mengwei666/my_microduck/readme.md

20261021
添加工控机模型

20261021
添加其他项目文件2

20261021
添加其他项目文件

20261021
上传文件测试
