mengwei666/my_microduck/microduck_scs225/scs225_left_knee/README_CN.md

# 左膝 SCS225 适配（第一关节验证件）

## 1. 这次改了什么

目标：保持 Microduck 左腿的运动学轴线不变，只把 **左膝** 的舵机安装接口从
飞特 HD-1910（`-FT` 版原设计）改成 **SCS225**，先做一个可以在 FreeCAD 里量尺寸、
可以打印试装的验证件。

没有改髋 pitch、髋 roll、踝、脚；右腿也没有改。

关键结论：

- `microduck-replica-cad-master/SolidWorks-FT2026-09-25/` 是 **HD-1910 飞特版**，
  不是 SCS225 版；`microduck_scs225/ascll/` 是从这个版本导出的左腿 STEP。
- 上腿外壳的外形包络是按 XL330 级别（45×24.7×35）留的，但 `-FT` 版的
  膝部舵机腔/加固板已经按更小的 HD-1910 缩过；SCS225 需要把舵机腔清大，
  并且 `rigidity_plate`（上腿加固板）的舵机孔位/轴承座必须改。
- 原 16×22×4 轴承的内孔是 16 mm，SCS225 的输出凸台是 Ø19.2，**不能直接套**；
  本包把轴承上移 2 mm，并给了一个 16 mm 轮毂的占位模型，轮毂和 SCS225 原装
  舵盘的连接还需要按实物舵盘孔距最终确定。

## 2. 文件

| 文件 | 用途 |
|---|---|
| `left_knee_SCS225_check.step` | **总检查装配**：改后上腿 + 改后加固板 + SCS225 + 轴承 + 小腿 + 16 mm 轮毂占位 + 原 HD-1910 髋舵机参考 |
| `left_upper_leg_knee_SCS225.step` | 改后左上腿（膝部按 SCS225 清空） |
| `left_upper_leg_rigidity_plate_knee_SCS225.step` | 改后上腿加固板（SCS225 四孔 + Ø20.2 让位 + 轴承座环） |
| `reference_raw_clearance_cut.step` | 原始切割结果（含被切下的小碎块），仅用于对照，不要打印 |
| `01_mount_holes_top_view.png` | 安装孔俯视图（20.7 × 20.5） |
| `02_knee_stack_section.png` | 膝部轴向剖面（板/轴承/小腿/轮毂的 Z 向堆叠） |
| `03_check_assembly_iso.png` | 总装等轴测预览 |
| `04_check_assembly_knee.png` | 膝部近景 |

所有 STEP 都在 **04_左大腿 装配坐标系** 里：膝轴 `(X,Y) = (10.13, -4.51)`，
轴线沿 `+Z`；原加固板底面 `Z=43.95`，顶面 `Z=45.95`。

## 3. 关键尺寸（可以直接在 FreeCAD 里量）

### SCS225（以输出轴中心、安装面为原点）

- 机体：45.25 × 24.78 mm，深 35 mm（输出面到后盖），输出凸台顶面在 `+3.2 mm`
- 安装面四孔：**20.7 × 20.5 mm**
  - 近排：距轴 **8.3 mm**
  - 远排：距轴 **29.0 mm**
  - 两排都在输出轴同一侧；横向 ±10.25 mm
- 本装配坐标里的四孔中心：
  - `(18.43, -14.76)`
  - `(18.43, +5.74)`
  - `(39.13, -14.76)`
  - `(39.13, +5.74)`

### 改后加固板

- 板底 `Z=43.95`（和 SCS225 安装面共面），板顶 `Z=45.95`
- 四孔：Ø3.2 通孔（M3  clearance，r=1.6）
- 中心让位：Ø20.2（SCS225 输出凸台 Ø19.2，单边 0.5 mm）
- 轴承座环：内 Ø20.2，外 Ø24.0，顶面 `Z=47.95`
- 原 16×22×4 轴承：从 `Z=45.95~49.95` 上移到 **`Z=47.95~51.95`**
  - 与 SCS225 凸台顶面 `Z=47.15` 留 **0.8 mm** 轴向间隙

### 小腿

- 小腿来自 `05_左小腿`，按膝轴对齐后：`Z=51.95~59.9`
- 膝部是 Ø16 内孔（外径约 Ø20 的凸台），和 16 mm 轮毂配合
- 检查装配里小腿底面与轴承顶面有 **0.7 mm** 间隙，试装时用 0.7 mm 垫片或
  调整轮毂法兰补掉

## 4. 在 FreeCAD 里怎么核对

1. 打开 `left_knee_SCS225_check.step`。
2. 用 **Part → Measure**（或 Draft 尺寸）量加固板四个孔：
   - X 向孔距 **20.7**
   - Y 向孔距 **20.5**
   - 对角 **29.14**
   - 孔径 **3.2**（M3 通孔）
3. 量轴线：SCS225 输出凸台、轴承内孔、小腿膝孔的圆心都应在
   `(10.13, -4.51)`，轴线沿 Z；不同心度建议 <0.1 mm。
4. 量安装面：加固板底面与 SCS225 前端面都应是 `Z=43.95`。
5. 量间隙：
   - SCS225 凸台顶 `47.15` ↔ 轴承底 `47.95`：**0.8 mm**
   - 小腿 ↔ 上腿：约 **11.5 mm**
   - 小腿 ↔ 加固板：约 **4.7 mm**
6. 单独打开两个改后零件，运行 **Part → Check geometry**；两个都是单一有效实体。
7. 检查髋舵机冲突：原 HD-1910 髋舵机的近端在 `Y=-15.66`，SCS225 远排
   内侧孔 `(39.13,-14.76)` 距它只有约 **0.9 mm**。**第一次膝部试装不要把
   HD-1910 髋舵机装上去**；以后把髋也换成 SCS225 时，让它的长边朝 `-X`，
   机体会退到 `Y≈-52.5~-27.8`，这个冲突就消失。

## 5. 打印与试装步骤

1. 打印：
   - 上腿：PLA/PETG，0.2 mm 层高，3 墙，20% 填充
   - 加固板：**4 墙，40% 以上填充**（它是承力件）
2. 先不装舵机，把 SCS225 放进上腿膝部，确认机体不顶住上腿，安装面与
   加固板底面贴合。
3. 用原螺丝把加固板固定到上腿（髋侧仍是 HD-1910 孔位，膝侧是新孔位）。
4. 用 **4× M3×8 沉头/低扁头** 把 SCS225 锁到加固板上，对角预紧。
   - 远排内侧那颗离髋舵机很近；若暂时不装髋舵机，可以先装它。
5. 把 16×22×4 轴承放进加固板轴承环（`Z=47.95`）。太松就加轴承胶，
   太紧就把环孔修 0.1 mm。
6. 给 SCS225 装 16 mm 轮毂（`16mm_hub_proposal_not_final` 只是占位）：
   - 轮毂法兰要固定在 SCS225 原装 25T 舵盘上（按实物舵盘孔距打 4×M2，
     或压装/胶接）
   - 轮毂 16 mm 外圆与轴承内孔、小腿 Ø16 孔配合；建议 16.0 -0.02/-0.05
7. 舵机先回中位（raw 511）再装舵盘/轮毂/小腿；手动转 ±30°，确认无卡滞。
8. 用 7.4 V、≥5 A 电源给舵机上电，先小角度（±10°）来回，再逐步加大。
9. 记录实测孔距、轴心偏差、轴承间隙；如果都正常，再按同样方法改髋 pitch
   和右腿。

## 6. 已知问题 / 下一步

- **上腿结构**：SCS225 比 HD-1910 大，切割后上腿膝部是开口的；加固板
  （2 mm + 轴承环）目前充当外侧盖板。验证尺寸没问题，但长期使用建议加一块
  **内侧背板/抱箍**，把 SCS225 背面四个孔和上腿连起来，形成“三明治”结构。
  这也是下一步最值得做的零件。
- **16 mm 轮毂**：STEP 里的轮毂是占位件，25T 舵盘接口必须按你手上的 SCS225
  实物舵盘测孔距后才能定稿。
- **髋 pitch**：本次未改。第一次膝部测试不要装原 HD-1910 髋舵机；后续改髋时
  让 SCS225 长边朝 `-X`。
- **运动学**：膝轴 `(10.13,-4.51)` 没变；轴承/小腿整体外移 2 mm，属于横向
  偏移，矢状面连杆长度不变。RL 模型暂时不用改连杆，但碰撞体要按新外形更新。
- **SCS225 参考 STEP**：原文件是 8 个重叠实体的 compound，FreeCAD 会报
  `valid=False`，这是参考模型本身的问题，不影响尺寸核对；我们改的
  上腿和加固板都是单一有效实体。
