mengwei666/my_microduck/docs/rk3588-scs225-13dof.md

# RK3588 + SCS225 十三自由度机器人 — 接口与训练安排

本文档记录这台自制机器人的硬件接口、关节分配、标定方法、IMU 约定，以及
`microduck_rl` 训练计划。运行时基于 `microduck` 的 `robotd`（新增 `--bus scs`），
训练基于 `microduck_rl`。

---

## 1. 硬件

| 部件 | 型号 / 接口 | 说明 |
|---|---|---|
| 主控 | 正点原子 ATK-DLRK3588（RK3588） | Buildroot，glibc 2.37，aarch64 |
| 舵机 | 飞特 Feetech **SCS225** ×13 | 串行总线，TTL 半双工，7.4V |
| 舵机转接板 | Waveshare Bus Servo Adapter (A) | 跳线 **B**（USB 模式），USB 接板子 → `/dev/ttyACM0` |
| IMU | **MPU6050** 模块 | I2C2：JP5 `P1_A0`=SCL、`P1_A1`=SDA，地址 **0x68**（AD0→GND） |
| 舵机供电 | 7.4V（2S）/ ≥5A | **不可用 12V**，会损坏 SCS225 |
| IMU 供电 | 3.3V（JP1） | JP5 是纯信号排针，无电源脚 |

调试串口：板载 CH343，`/dev/ttyACM0`（在 PC 上），**1500000 8N1**。

---

## 2. 关节分配（舵机 ID → 关节 → robotd 槽位）

舵机 ID 就是总线地址，出厂已按 1–13 设置。**本机没有摇头（head_yaw）和嘴巴（mouth）**
两个自由度，其余关节保持与量产 Microduck 相同的顺序和索引。

| 舵机 ID | 关节名 | robotd 槽位 | 中文 |
|---:|---|---:|---|
| 1 | `left_hip_yaw` | 0 | 左髋偏航 |
| 2 | `left_hip_roll` | 1 | 左髋横滚 |
| 3 | `left_hip_pitch` | 2 | 左髋俯仰 |
| 4 | `left_knee` | 3 | 左膝 |
| 5 | `left_ankle` | 4 | 左踝 |
| 6 | `neck_pitch` | 5 | 颈俯仰 |
| 7 | `head_pitch` | 6 | 头俯仰 |
| 8 | `head_roll` | 8 | 头横滚 |
| 9 | `right_hip_yaw` | 10 | 右髋偏航 |
| 10 | `right_hip_roll` | 11 | 右髋横滚 |
| 11 | `right_hip_pitch` | 12 | 右髋俯仰 |
| 12 | `right_knee` | 13 | 右膝 |
| 13 | `right_ankle` | 14 | 右踝 |

**缺失的两个槽位**：`head_yaw` = 槽位 7、`mouth` = 槽位 9。它们保持 0，永不被命令。
代码里的常量是 `robotd::SCS_JOINT_SLOTS = [0,1,2,3,4,5,6,8,10,11,12,13,14]`。

> ⚠️ 这是一条**约定**，不是测量结果。接线时若某个舵机装到了别的关节，必须改这张表。
> 验证方法见 §5。

### 2.1 训练用的紧凑顺序

训练（`microduck_rl`）用一套 13 元素的紧凑顺序，与上表**同序**，只是重新编号：

```
训练索引 i : 0  1  2  3  4   5          6          7         8   9  10 11 12
关节       : 左髋×5             颈俯仰    头俯仰     头横滚    右髋×5
运行时槽位 : 0  1  2  3  4   5          6          8         10 11 12 13 14
```

即 `训练索引 i ↔ 运行时槽位 SCS_JOINT_SLOTS[i]`，两边顺序一致。

---

## 3. SCS225 电气与协议参数（实测）

| 项目 | 值 |
|---|---|
| 总线 | 1 Mbps，8 数据位，无校验，1 停止位；TTL 半双工 |
| 位置分辨率 | 0–1023，中位 **511**，行程 300°（约 0.293°/count） |
| 字节序 | 16 位寄存器 **高字节在前（大端）**（SCS 系列与 SMS 系列相反） |
| 单次 READ 长度 | **≤3 字节可靠**；4 字节大量失败，≥5 字节完全无响应（实测） |
| 单次 WRITE | 任意长度均可 |
| 同步写 | 广播 ID `0xFE`，指令 `0x83` |
| 弧度换算 | `rad = (raw − 511) × (300° / 1024)`；`rad_to_raw` 为其逆 |
| 默认力矩 | 上电为**自由**，需显式使能 |

关键寄存器（大端）：

| 地址 | 名称 | 字节 | 说明 |
|---|---:|---|---|
| 0x05 | ID | 1 | 1–253 |
| 0x06 | 波特率 | 1 | 0 = 1 Mbps |
| 0x09 / 0x0B | 最小/最大角度限位 | 2 / 2 | 出厂 20 / 1003 |
| 0x12 | phase | 1 | Bit0：方向取反；Bit3：速度 0 = 最大 |
| 0x15 / 0x16 | 位置环 Kp / Kd | 1 / 1 | 0–254 |
| 0x28 | 力矩开关 | 1 | 0 自由 / 1 使能 / 2 阻尼 |
| 0x2A | 目标位置 | 2 | 0–1023 |
| 0x2E | 目标速度 | 2 | 步/秒，0 = 最快 |
| 0x38 | 当前位置 | 2 | |
| 0x3A | 当前速度 | 2 | 有符号，步/秒 |
| 0x3C | 当前负载 | 2 | 0.1% |
| 0x3E | 输入电压 | 1 | 0.1V |
| 0x3F | 温度 | 1 | °C |
| 0x41 | 状态 | 1 | Bit0 电压 / Bit2 温度 / Bit5 负载 |
| 0x42 | 移动标志 | 1 | 1 = 运动中 |

---

## 4. 关节标定（每台机器人必做）

驱动把 **raw 511 当作 0 rad**，正方向为 raw 增大。由于装配差异，每个关节需要：

1. **机械零位 raw**：手扶关节到设计零位，读当前位置，与 511 的差就是该关节的
   offset（当前代码未实现 per-joint offset，需要时再加）。
2. **方向**：给该关节一个小目标（如 +100 raw），确认实际转向与模型一致；不一致就写
   `phase`（0x12）Bit0 取反，或在标定表里记负号。
3. **限位**：写 `min/max angle limit`（0x09/0x0B），避免自碰撞或扯线。
4. **Kp/Kd**：默认 Kp=32、Kd=0 可先跑，整定阶段再调（运行时 `robotd` 会按策略的
   `gain` 统一写 Kp）。

标定时的读/写命令可用板子上的 `/root/scs225` 工具（scan/read/move），或笔记本上的
`microduck/scripts/scs225_debug.py`。

---

## 5. IMU 与机身坐标

- 当前**以模块现有安装方向作为机身坐标**：驱动里 mount = 单位四元数，不额外旋转。
- `gravity` 约定与 Microduck 一致：**竖直静止时为 `[0, 0, −1]`**（机身坐标）。
  MPU6050 的加速度计在静止时测到的是"向上"的比力，驱动取反并归一化。
- **没有磁力计 → 无法测偏航**。四元数只含倾斜（tilt-only），航向恒为 0；依赖偏航的
  功能（如精准转向）需要额外传感器或靠腿部里程计。
- 若以后改变模块安装方向，在 `duck-control/src/mpu6050.rs` 里加 mount 旋转（与
  `imu.rs` 的 `SflpDecoder::DEFAULT_MOUNT` 同一套约定），改完重新编译部署。

---

## 6. 运行与验证

板子上（`/root/robotd`、`/root/robotctl` 已部署）：

```sh
RUST_LOG=info /root/robotd --bus scs --port /dev/ttyACM0 --no-policy \
    --socket /run/robotd.sock > /tmp/robotd.log 2>&1 &
/root/robotctl --socket /run/robotd.sock health
```

期望输出：

```
robot     healthy
  loop      49.9 of 50.0 Hz · ...
  bus       ok
  imu       ready
  battery   7.x V (..%)
```

总线自检（不动舵机）：

```sh
/root/scs225 --port /dev/ttyACM0 --ids 1-13 scan
/root/scs225 --port /dev/ttyACM0 --ids 1-13 read
```

---

## 7. 训练计划（`microduck_rl`）

**目标**：13 自由度、先训**前进/后退**（机体 x 方向速度 `vx`，侧移/转向先不训）。

### 7.1 模型

当前 `microduck_rl` 的模型是 14 自由度（`0-4` 左腿、`5-8` 头颈
`neck_pitch/head_pitch/head_yaw/head_roll`、`9-13` 右腿），14 个执行器，观测 61D。
本机去掉 `head_yaw` → **13 自由度、13 个执行器**。

改动清单（按 mjlab 约定）：

1. MJCF：删除 `head_yaw` 关节与对应 actuator（或移到 `passive_` 前缀之外但禁用），
   保留质量/惯量/碰撞体不变。
2. `microduck_constants.py`：更新执行器/关节列表与 HOME 帧（去掉 head_yaw 一项）。
3. `microduck_*_env_cfg.py` / `mdp.py`：动作维度、观测项、奖励里引用 head_yaw 的
   一律删除或置零；`symmetry.py` 的镜像表同步删列。
4. 观测：保持"每槽非零采样"的约定，删掉的槽位不要留死权重。

### 7.2 任务

- 复用 `Mjlab-Velocity-Flat-MicroDuck`。
- 命令只采 `vx`（前进正、后退负），`vy=0`、`yaw_rate=0`；保留 `head_pose` 槽但采样
  小范围或零，维持输入神经元活性。
- 课程：先小速度、平地，稳定后再放宽 `vx` 范围。

### 7.3 流程

```bash
cd microduck_rl
uv run list-envs
uv run train Mjlab-Velocity-Flat-MicroDuck-13Dof \
    --env.scene.num-envs 64 --agent.max_iterations 5      # 冒烟
uv run train Mjlab-Velocity-Flat-MicroDuck-13Dof \
    --env.scene.num-envs 4096 --agent.max_iterations 4000 \
    --agent.logger tensorboard                            # 本机 RTX 2070
uv run play  <TASK_ID> --checkpoint-file logs/.../model_4000.pt
uv run scripts/export.py <TASK_ID> --wandb-run-path ...   # 或训练结束自动导出 ONNX
```

### 7.4 部署到板子

ONNX 经 `robotctl policy load` 或 `publish` 安装。**动作/观测维度与运行时天然兼容**：

- 训练时 BAM 执行器按关节名正则匹配，策略输出仍是 **14 个动作**（13 个真实关节
  + 一个被 equality 锁死的 `head_yaw`），观测仍是 **61D**，与 `robotd` 的策略契约一致。
- 被锁死的 `head_yaw` 动作在训练中没有梯度，在真机上又被 `SCS_JOINT_SLOTS` 跳过
  （槽位 7 不在列表里），所以不需要为了 13 自由度去改 `duck-ipc-proto`/`robotd`。
- 部署时只需保证策略的动作顺序与 §2.1 的训练顺序一致（由模型关节顺序决定）。

### 7.5 现实提醒

机器人目前还是散件，没有结构尺寸/质量。先用"删掉 head_yaw 的量产模型"训练，能得到
可用的前进/后退步态起点；等你有腿长、连杆质量、质心实测值后，把 MJCF 的惯性参数改
成实机值再微调，迁移会更稳。

---

## 8. 已知限制与坑

- **SCS225 单次读 ≤3 字节**：驱动已按位置/速度分开读并重试 3 次，别改回 6 字节合并读。
- **写入后立即读会偶发失败**：供电不足时尤其明显；7.4V/≥5A 后实测 0/50 失败。
- **12V 必坏**：SCS / SC 系列是 7.4V 舵机，Waveshare 板上标的 9–12.6V 是给 ST 系列的。
- **P1_A0/P1_A1 无内部上拉**：I2C 依赖 MPU6050 模块板载上拉，线要短、插要紧。
- 没有 `head_yaw`/`mouth`：量产策略不能直接跑，必须按 §7 重训或做动作维度适配。
