mengwei666/my_microduck/microduck-replica-cad-master/组件图/01-躯干主体-爆炸图.png

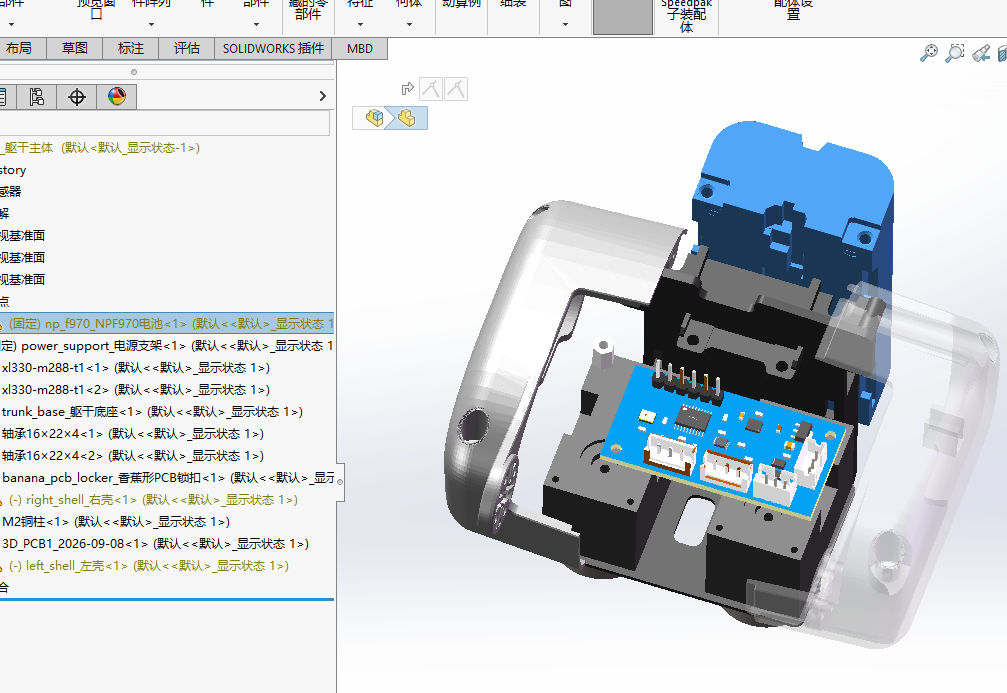
microduck-replica-cad-master/组件图/01-躯干主体-爆炸图.png
