mengwei666/my_microduck/microduck-replica-cad-master/组件图/10-头部总成爆炸1.png

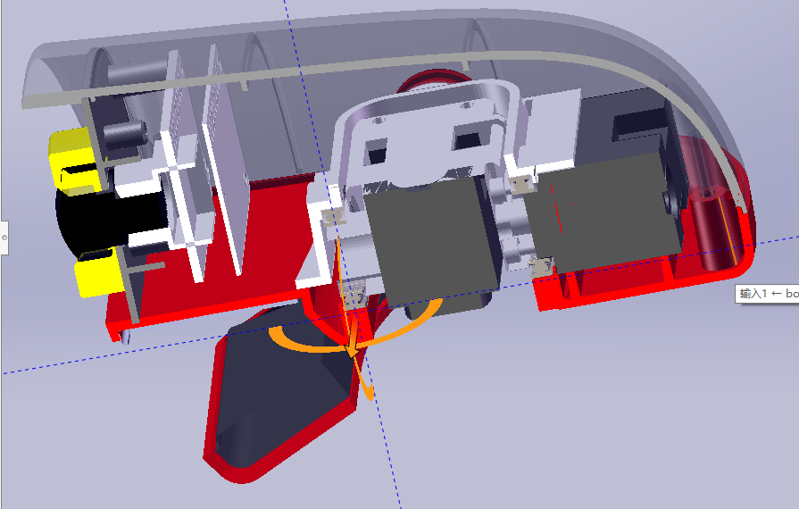
microduck-replica-cad-master/组件图/10-头部总成爆炸1.png
