mengwei666/my_microduck/microduck_scs225/scs225_cad/SCS215_ST3215_2D.png

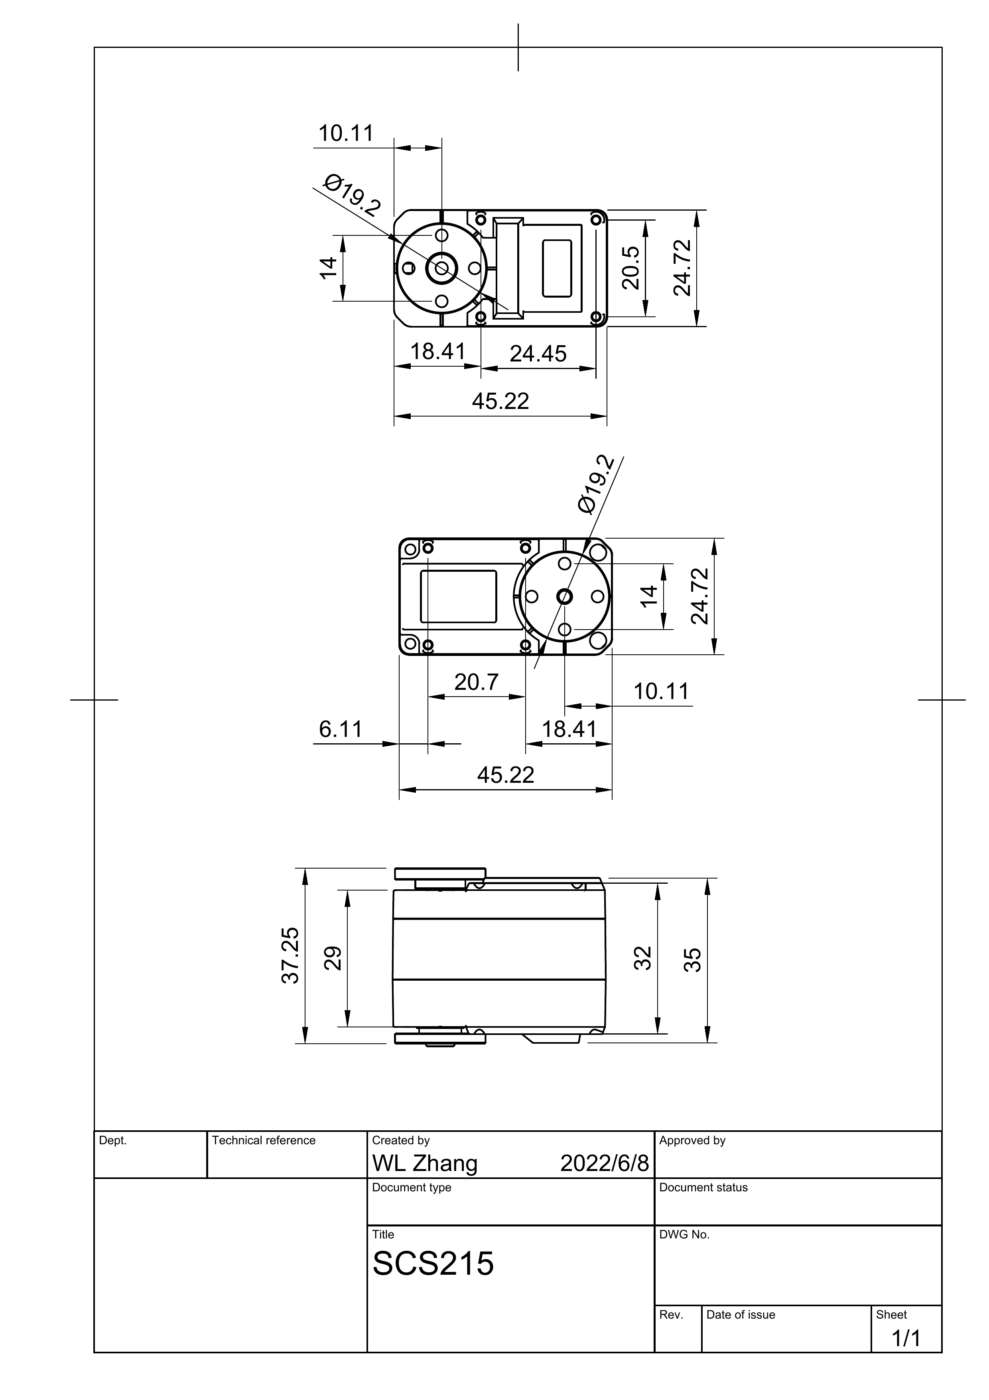
microduck_scs225/scs225_cad/SCS215_ST3215_2D.png
