mengwei666/my_microduck/microduck_scs225/scs225_cad/SCS225_spec_page6.png

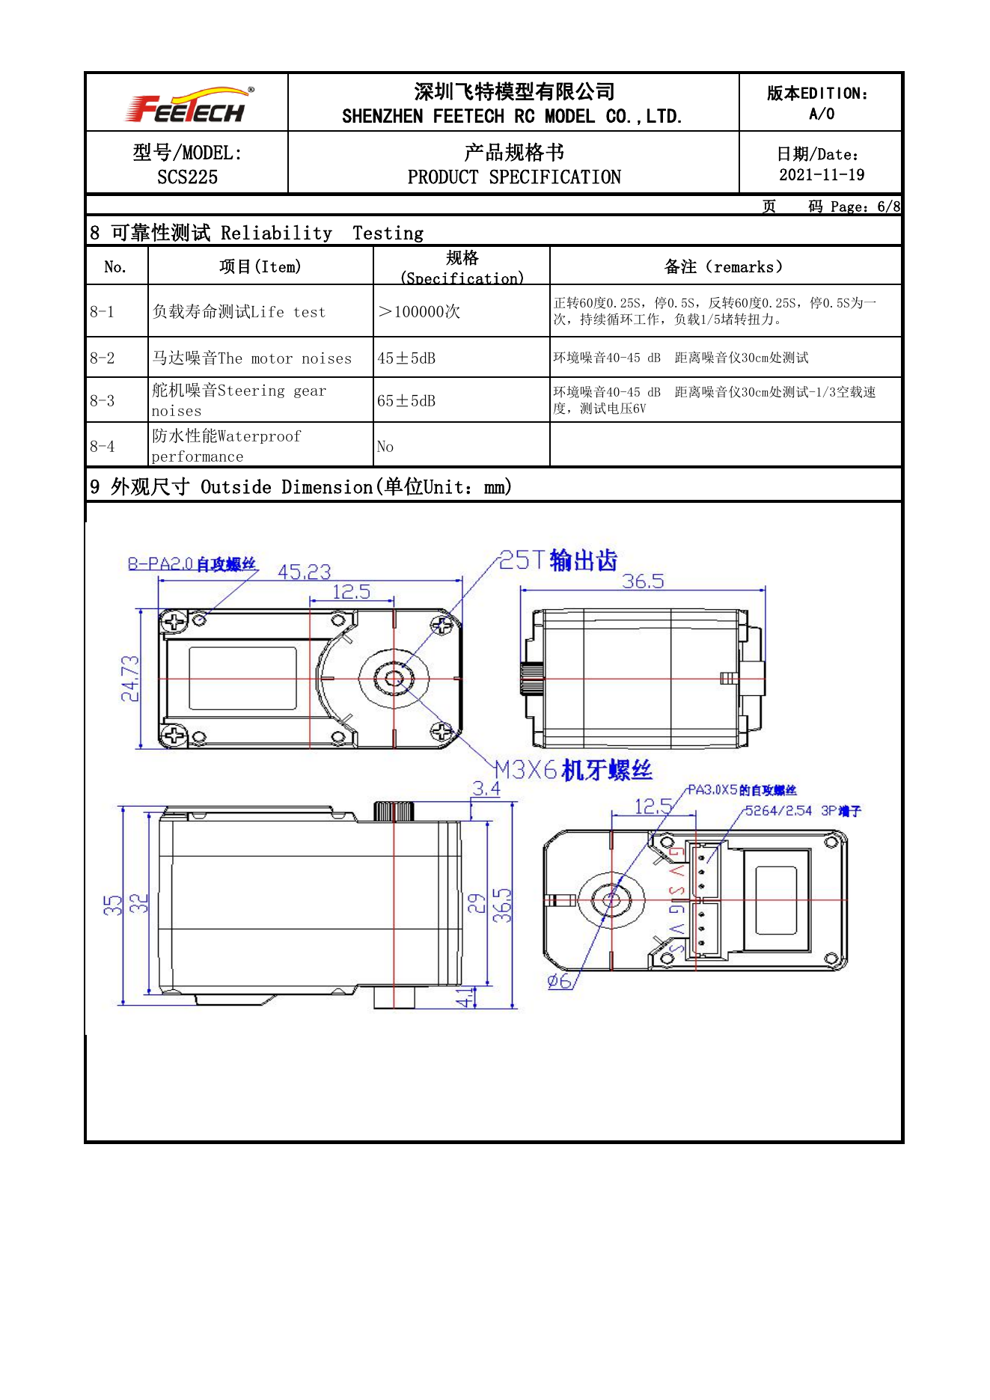
microduck_scs225/scs225_cad/SCS225_spec_page6.png
