mengwei666/my_microduck/microduck_scs225/scs225_left_ankle/01_full_iso.png

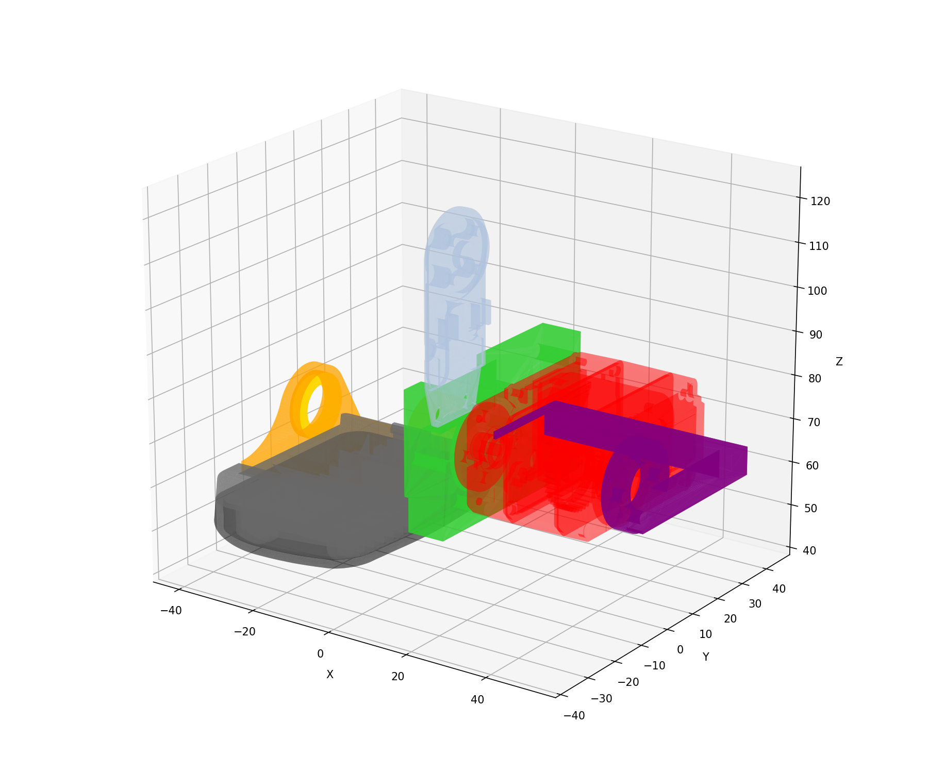
microduck_scs225/scs225_left_ankle/01_full_iso.png
