mengwei666/my_microduck/microduck_scs225/scs225_left_ankle/02_ankle_close.png

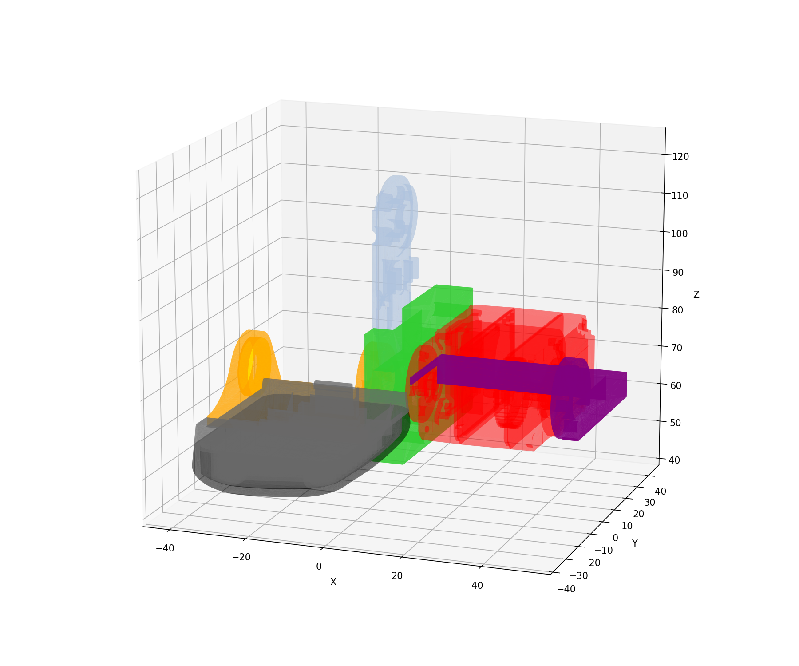
microduck_scs225/scs225_left_ankle/02_ankle_close.png
