mengwei666/my_microduck/microduck_scs225/scs225_left_ankle_v2/01_check_iso.png

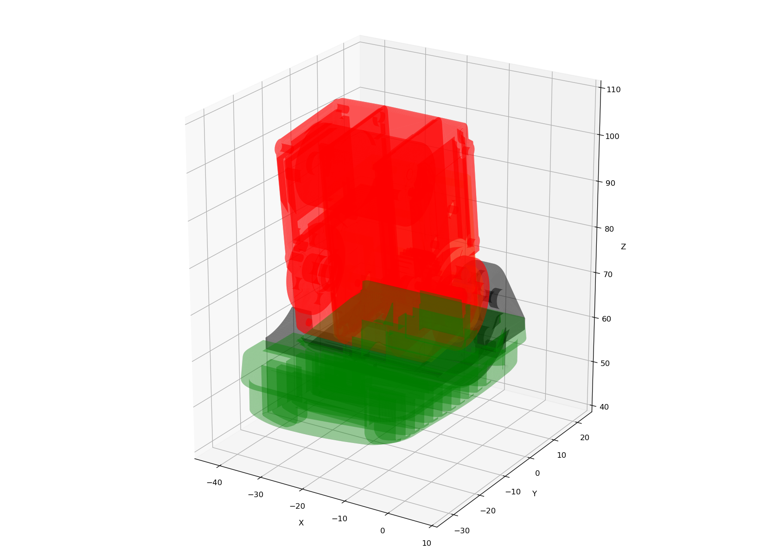
microduck_scs225/scs225_left_ankle_v2/01_check_iso.png
