mengwei666/my_microduck/microduck_scs225/scs225_left_ankle_v2/02_section_xz.png

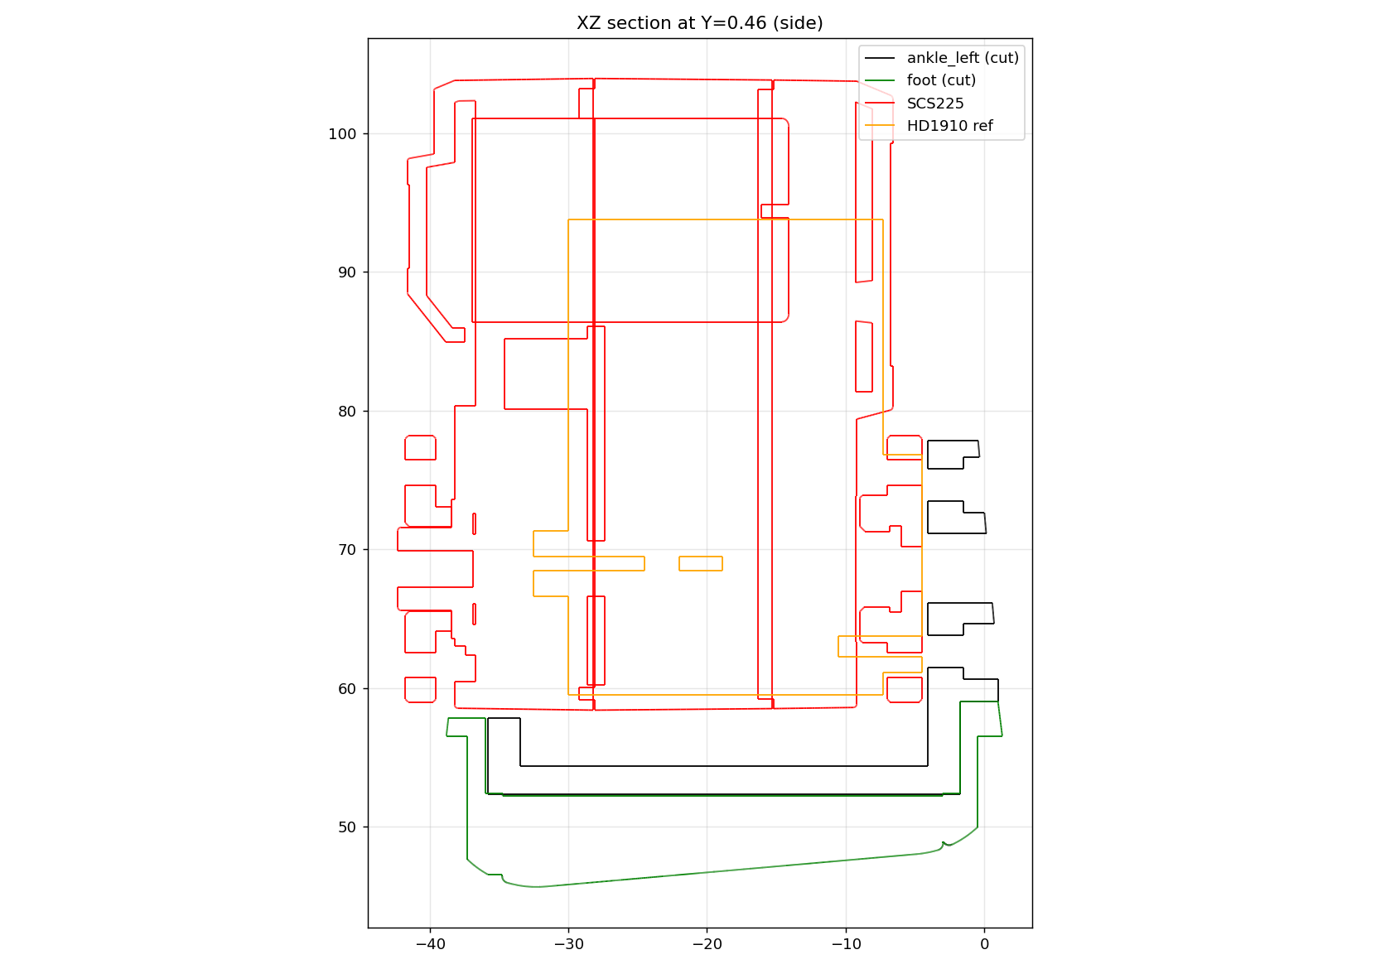
microduck_scs225/scs225_left_ankle_v2/02_section_xz.png
