mengwei666/my_microduck/microduck_scs225/scs225_left_ankle_v2/03_section_xy.png

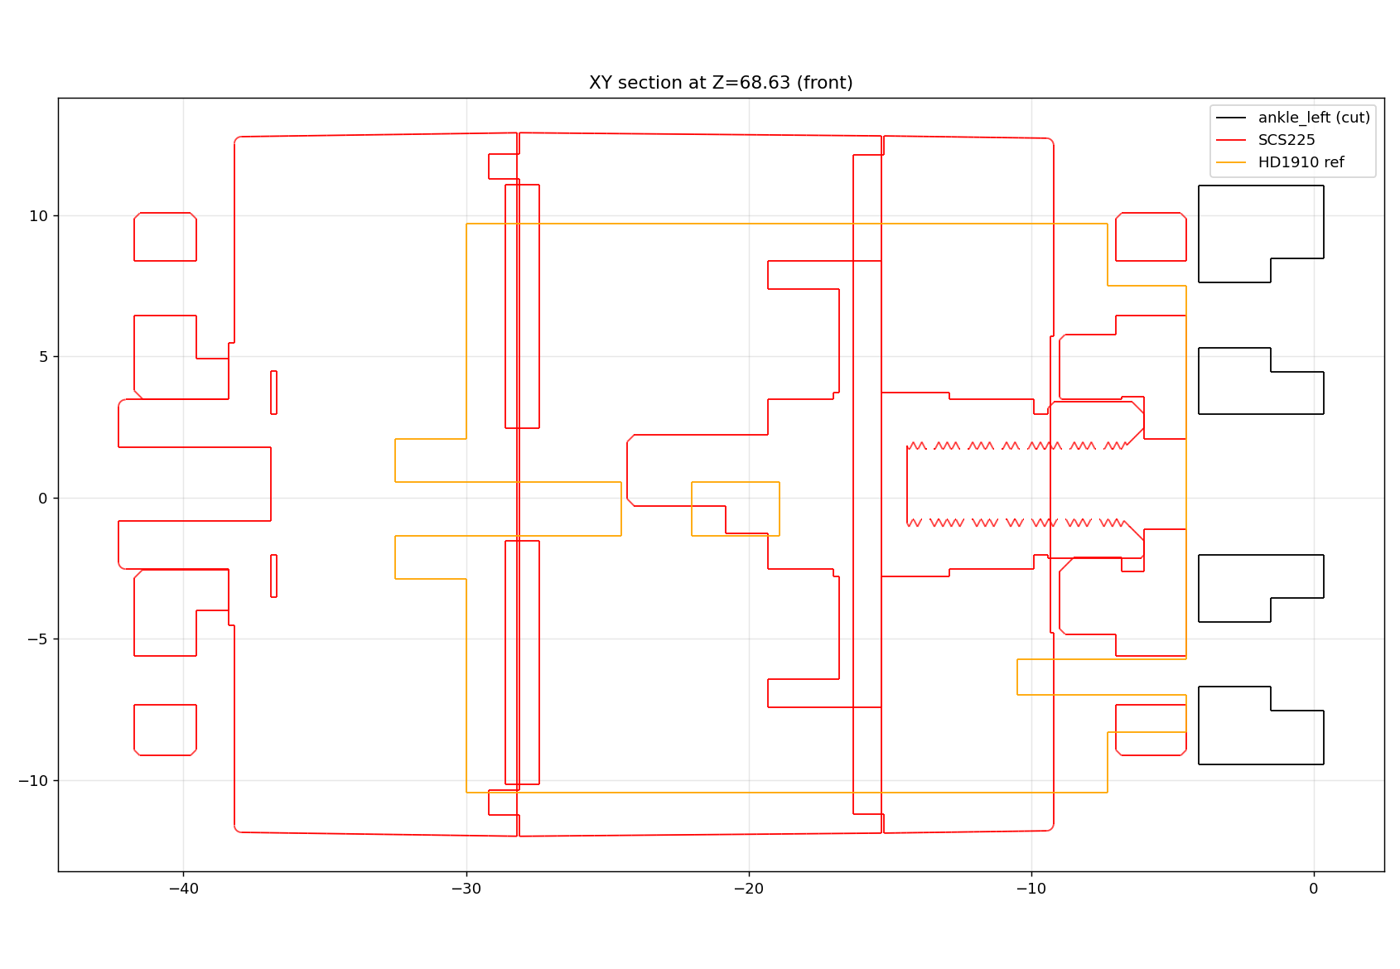
microduck_scs225/scs225_left_ankle_v2/03_section_xy.png
