mengwei666/my_microduck/microduck_scs225/scs225_left_knee/01_mount_holes_top_view.png

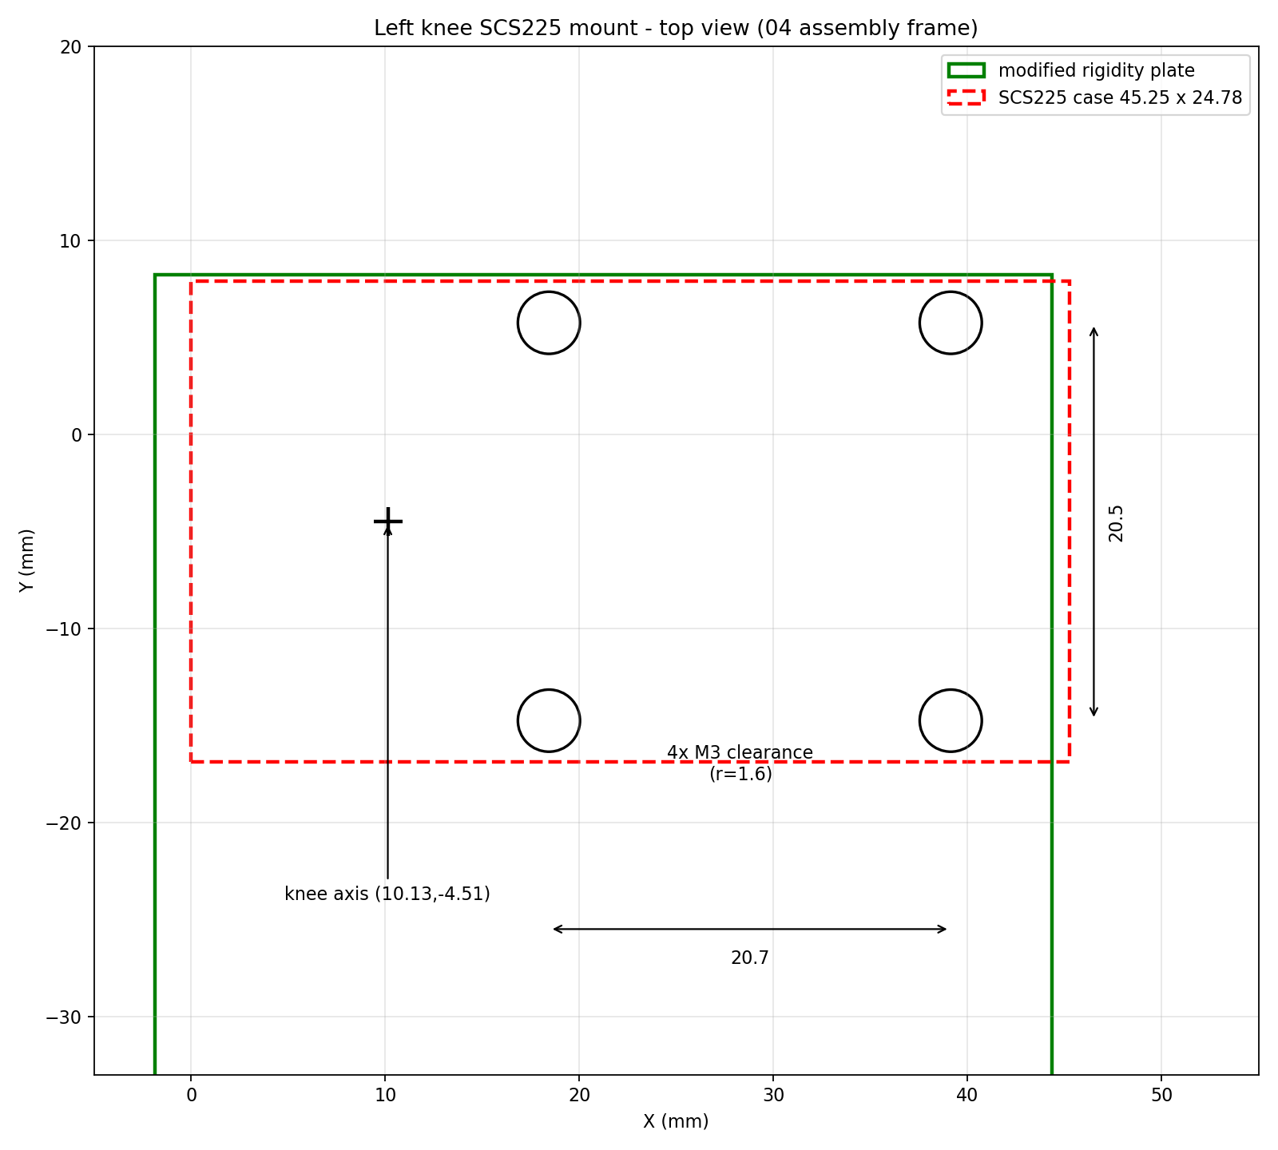
microduck_scs225/scs225_left_knee/01_mount_holes_top_view.png
