mengwei666/my_microduck/microduck_scs225/scs225_left_knee/02_knee_stack_section.png

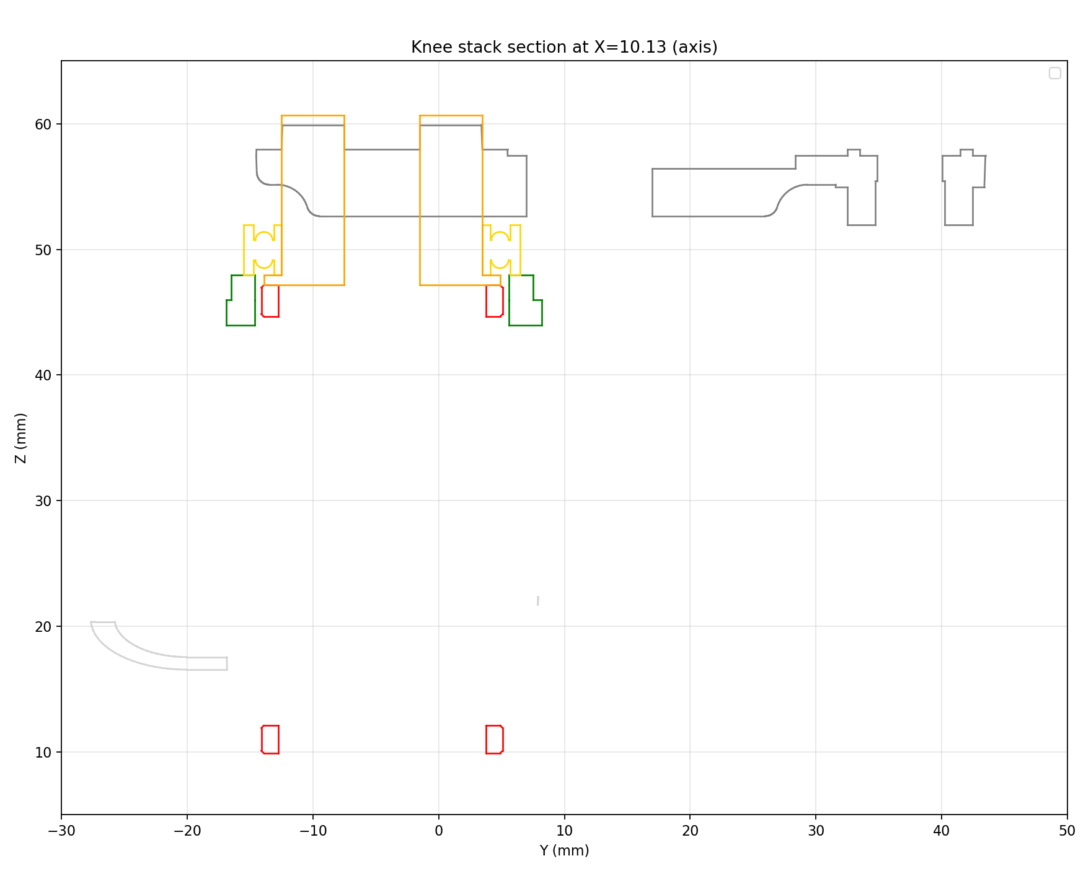
microduck_scs225/scs225_left_knee/02_knee_stack_section.png
