mengwei666/my_microduck/microduck_scs225/leg_cad/inspect_ft_parts2_out.txt

[FreeCAD Console mode <Use Ctrl-D (i.e. EOF) to exit.>]
>>> Adding snap-specific PYTHONPATH to sys.path: /home/mw/snap/freecad/common/.local/lib/python3.12/site-packages:/snap/freecad/2741/lib/python3.12/site-packages:/snap/freecad/2741/usr/lib/python3/dist-packages
==== left_upper_leg_FT.step
BBOX (42.5, -13.47, -12.2, 70.5, 34.19, 48.8)
SIZE 28.0 47.66 61.0 SOLIDS 1 FACES 5425
SMALL CYLINDERS 0
==== leg_FT.step
BBOX (32.5, 12.0, -12.22, 40.45, 32.0, 45.78)
SIZE 7.95 20.0 58.0 SOLIDS 1 FACES 6401
SMALL CYLINDERS 0
==== yaw2roll_FT.step
BBOX (6.0, -13.3, -5.0, 29.0, 12.5, 15.5)
SIZE 23.0 25.8 20.5 SOLIDS 1 FACES 7918
SMALL CYLINDERS 0
==== bearing_roll_FT.step
BBOX (-11.5, -20.0, 0.0, 11.5, 20.0, 3.5)
SIZE 23.0 40.0 3.5 SOLIDS 1 FACES 26
SMALL CYLINDERS 8
    (1.15, (-9.0, -17.0, 0.0), (-0.0, -0.0, 1.0))
    (1.15, (-8.0, 18.0, 0.0), (-0.0, -0.0, 1.0))
    (1.15, (8.0, 18.0, 0.0), (-0.0, -0.0, 1.0))
    (1.15, (9.0, -17.0, 0.0), (-0.0, -0.0, 1.0))
    (2.0, (-9.5, -18.0, 1.5), (0.0, 0.0, -1.0))
    (2.0, (-9.5, 18.0, 1.5), (0.0, 0.0, -1.0))
    (2.0, (9.5, -18.0, 1.5), (0.0, 0.0, -1.0))
    (2.0, (9.5, 18.0, 1.5), (0.0, 0.0, -1.0))
==== ankle_left_FT.step
BBOX (-14.67, -19.75, -16.3, 21.85, 19.75, 10.42)
SIZE 36.52 39.5 26.72 SOLIDS 1 FACES 88
SMALL CYLINDERS 12
    (1.0, (-12.92, 55.01, -8.1), (0.0, -1.0, 0.0))
    (1.15, (-6.0, 11.45, -0.0), (-0.0, 1.0, -0.0))
    (1.15, (0.0, 11.45, -6.0), (-0.0, 1.0, -0.0))
    (1.15, (0.0, 11.45, 6.0), (-0.0, 1.0, -0.0))
    (1.15, (6.0, 11.45, 0.0), (-0.0, 1.0, 0.0))
    (1.15, (17.5, 0.0, -16.3), (-0.0, -0.0, 1.0))
    (2.0, (-6.0, 17.25, -0.0), (-0.0, 1.0, -0.0))
    (2.0, (0.0, 17.25, -6.0), (-0.0, 1.0, -0.0))
    (2.0, (0.0, 17.25, 6.0), (-0.0, 1.0, -0.0))
    (2.0, (6.0, 17.25, 0.0), (-0.0, 1.0, -0.0))
    (2.0, (13.46, 55.01, -9.1), (0.0, -1.0, 0.0))
    (2.0, (17.5, 0.0, -8.1), (-0.0, -0.0, 1.0))
==== rigidity_plate_FT.step
BBOX (-11.73, -34.2, 0.0, 46.74, 11.0, 2.0)
SIZE 58.47 45.2 2.0 SOLIDS 1 FACES 48
SMALL CYLINDERS 15
    (1.0, (17.65, -25.88, -8.0), (0.0, 0.0, -1.0))
    (1.0, (17.65, -15.57, -8.0), (0.0, 0.0, -1.0))
    (1.08, (13.14, -30.0, -8.0), (-0.0, -0.0, 1.0))
    (1.08, (13.14, -14.0, -8.0), (-0.0, -0.0, 1.0))
    (1.15, (-8.0, -22.5, 0.0), (-0.0, -0.0, 1.0))
    (1.15, (8.0, -22.5, 0.0), (-0.0, -0.0, 1.0))
    (1.5, (-1.84, -30.27, -8.0), (-0.0, -0.0, 1.0))
    (1.5, (-1.84, -28.26, -8.0), (-0.0, -0.0, 1.0))
    (1.5, (8.69, -30.27, -8.0), (-0.0, -0.0, 1.0))
    (1.5, (8.69, -28.26, -8.0), (-0.0, -0.0, 1.0))
    (2.0, (-6.8, -16.05, -8.0), (-0.0, -0.0, 1.0))
    (2.0, (-6.8, -12.38, -8.0), (-0.0, -0.0, 1.0))
    (2.0, (6.26, -10.86, -8.0), (-0.0, -0.0, 1.0))
    (2.0, (21.94, -24.88, -8.0), (-0.0, -0.0, 1.0))
    (2.0, (22.74, -16.57, -8.0), (-0.0, -0.0, 1.0))
>>>
