mengwei666/my_microduck/microduck_scs225/leg_cad/inspect_parts_out.txt

[FreeCAD Console mode <Use Ctrl-D (i.e. EOF) to exit.>]
>>> Adding snap-specific PYTHONPATH to sys.path: /home/mw/snap/freecad/common/.local/lib/python3.12/site-packages:/snap/freecad/2741/lib/python3.12/site-packages:/snap/freecad/2741/usr/lib/python3/dist-packages
==== HD1910
BBOX (-10.02, -24.9, -22.9, 10.6, 9.5, 7.3)
SIZE 20.62 34.4 30.2 SOLIDS 14 FACES 1389
  CYL r=0.10 axis=(0.0, 0.0, 1.0) n=25
      (-2.4, 0.15, 2.5)
      (-2.36, -0.45, 2.5)
      (-2.28, 0.74, 2.5)
      (-2.17, -1.02, 2.5)
      (-2.03, 1.29, 2.5)
      (-1.85, -1.53, 2.5)
      (-1.64, 1.75, 2.5)
      (-1.41, -1.94, 2.5)
      (-1.16, 2.1, 2.5)
      (-0.88, -2.23, 2.5)
      (-0.6, 2.32, 2.5)
      (-0.3, -2.38, 2.5)
      (0.0, 2.4, 2.5)
      (0.3, -2.38, 2.5)
      (0.6, 2.32, 2.5)
      (0.88, -2.23, 2.5)
      (1.16, 2.1, 2.5)
      (1.41, -1.94, 2.5)
      (1.64, 1.75, 2.5)
      (1.85, -1.53, 2.5)
  CYL r=0.15 axis=(0.0, 0.0, 1.0) n=78
      (-7.39, 0.07, -6.0)
      (-7.39, 0.15, -6.0)
      (-7.32, -1.04, -6.0)
      (-7.31, -1.12, -6.0)
      (-7.28, 1.26, -6.0)
      (-7.27, 1.33, -6.0)
      (-7.06, -2.2, -6.0)
      (-7.03, -2.27, -6.0)
      (-6.99, 2.41, -6.0)
      (-6.96, 2.48, -6.0)
      (-6.61, -3.3, -6.0)
      (-6.58, -3.37, -6.0)
      (-6.51, 3.5, -6.0)
      (-6.47, 3.57, -6.0)
      (-6.0, -4.32, -6.0)
      (-5.95, -4.38, -6.0)
      (-5.87, 4.5, -6.0)
      (-5.82, 4.56, -6.0)
      (-5.23, -5.23, -6.0)
      (-5.17, -5.28, -6.0)
  CYL r=0.30 axis=(0.0, 0.0, 1.0) n=6
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
  CYL r=2.60 axis=(1.0, 0.0, 0.0) n=1
      (30.3, 22.0, -6.2)
  CYL r=3.00 axis=(1.0, 0.0, 0.0) n=1
      (37.45, 22.0, 35.78)
==== yaw2roll
BBOX (6.0, -13.3, -5.0, 29.0, 12.5, 15.5)
SIZE 23.0 25.8 20.5 SOLIDS 1 FACES 7918
  CYL r=2.65 axis=(0.0, 1.0, 0.0) n=1
      (17.5, 17.0, -0.0)
==== trunk_base
BBOX (-28.5, -13.0, 15.5, 28.5, 23.0, 19.5)
SIZE 57.0 36.0 4.0 SOLIDS 1 FACES 992
  CYL r=1.20 axis=(0.0, 0.0, 1.0) n=4
      (-25.5, 20.5, 15.5)
      (-9.5, 20.5, 15.5)
      (9.5, 20.5, 15.5)
      (25.5, 20.5, 15.5)
  CYL r=2.00 axis=(0.0, 0.0, 1.0) n=8
      (-26.5, -11.0, 15.5)
      (-26.5, 21.0, 15.5)
      (-1.0, -0.0, 15.5)
      (-1.0, 8.0, 15.5)
      (1.0, 0.0, 15.5)
      (1.0, 8.0, 15.5)
      (26.5, -11.0, 15.5)
      (26.5, 21.0, 15.5)
>>>
