mengwei666/my_microduck/microduck-replica-cad-master/SolidWorks-FT2026-09-25/10_头部总成-FT.SLDASM

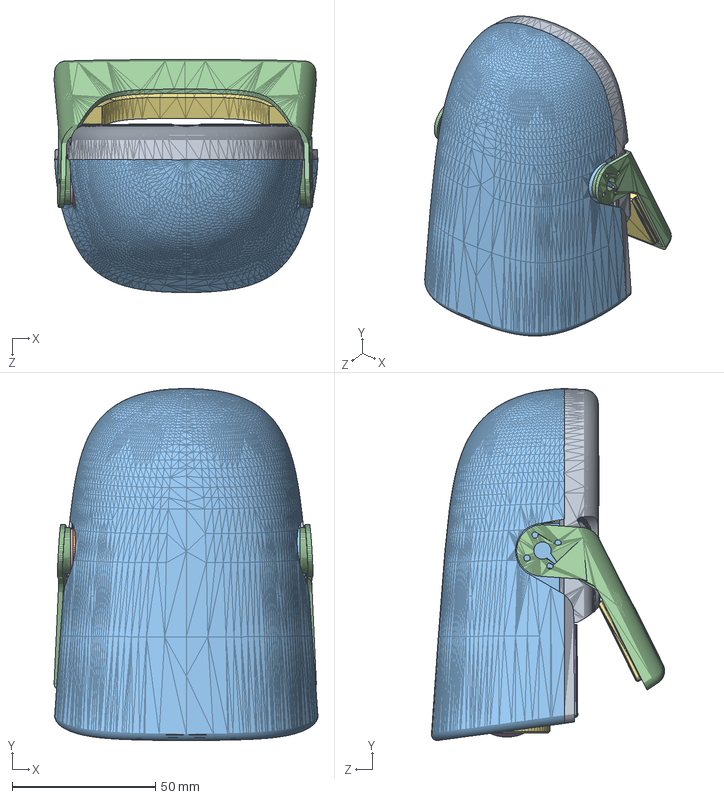
[picture p40: CAD file, 2026-10-21]
microduck-replica-cad-master/SolidWorks-FT2026-09-25/10_头部总成-FT.SLDASM
92.0 x 122.7 x 81.3 mm
bottom_head_shell_头部下壳-FT
face_part_面部零件-FT
HD-1910-c001-dan x 3
轴承16×22×4-FT x 2
99-yaw_roll_motion_偏航横滚运动-F
lens_镜头-FT
noenoeil_眼睛-FT
elec_rpi_robot_hat_pcb_树莓派机器人HAT电路板-FT
pcb__raspberry_pi_zero_2_w_树莓派Zero2W电路板-FT
motor_support_电机支架-FT
top_head_shell_头部上壳-FT
jaw_下巴-FT
deep groove ball bearings gb
soft_mouth_top_软嘴顶部-FT
jaw_soft_软下巴-FT
