mengwei666/my_microduck/microduck-replica-cad-master/SolidWorks-XL330-v1.1/03_左髋roll.SLDASM

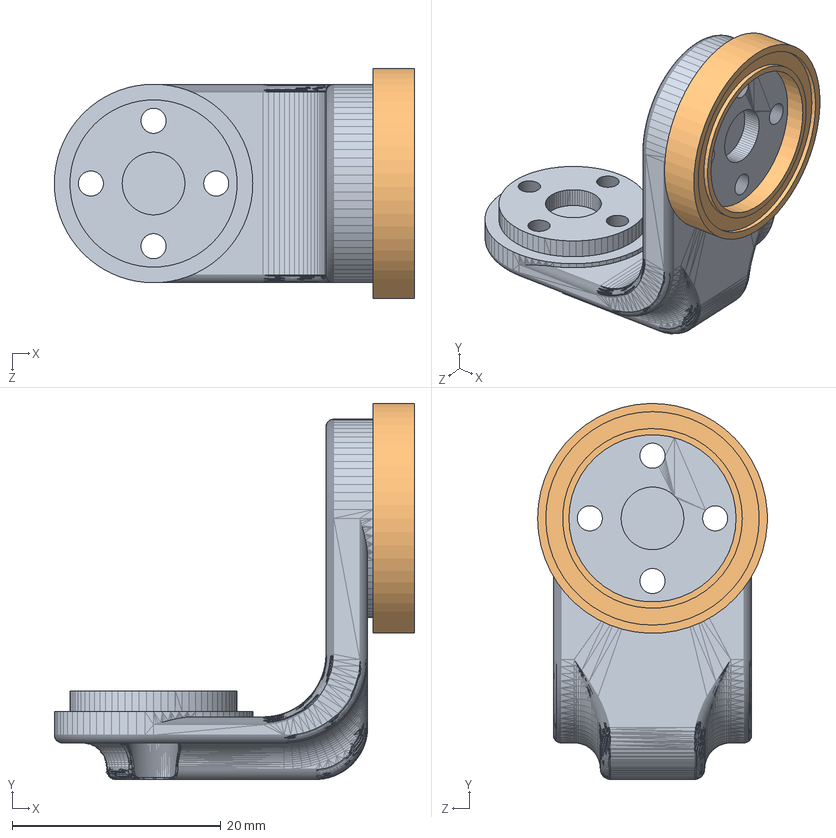
[picture p41: CAD file, 2026-10-21]
microduck-replica-cad-master/SolidWorks-XL330-v1.1/03_左髋roll.SLDASM
34.5 x 36.0 x 22.0 mm
hip_l_髋部左
轴承16×22×4
