mengwei666/my_microduck/microduck-replica-cad-master/SolidWorks-FT2026-09-25/15_右踝脚-FT.SLDASM

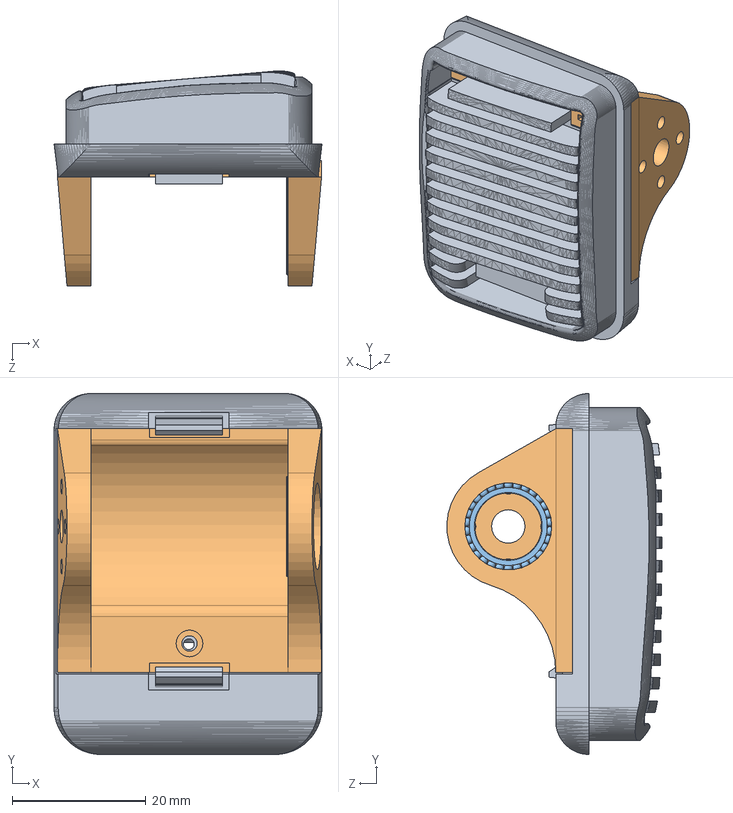
[picture p42: CAD file, 2026-10-21]
microduck-replica-cad-master/SolidWorks-FT2026-09-25/15_右踝脚-FT.SLDASM
40.1 x 54.0 x 32.2 mm
foot_right_右脚-FT
ankle_right脚踝右1-FT
deep groove ball bearings gb
