mengwei666/my_microduck/microduck-replica-cad-master/SolidWorks-XL330-v1.1/05_左小腿.SLDASM

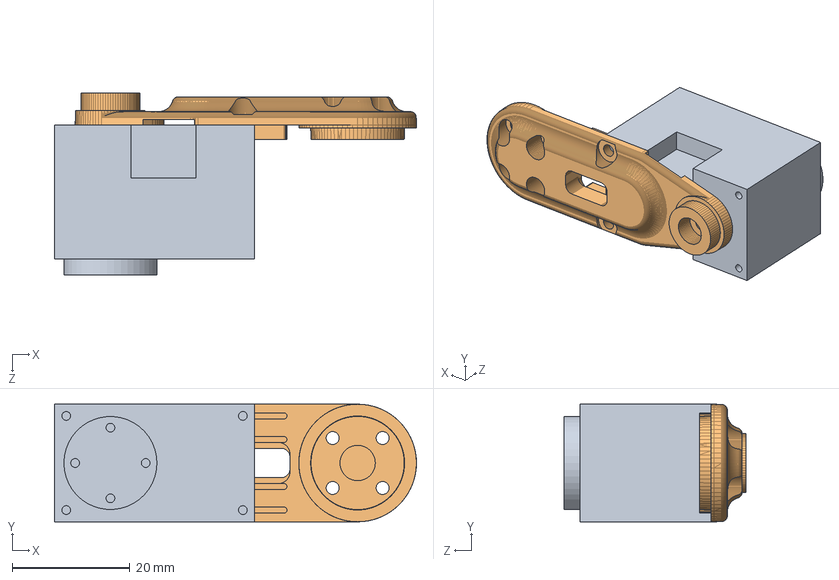
[picture p43: CAD file, 2026-10-21]
microduck-replica-cad-master/SolidWorks-XL330-v1.1/05_左小腿.SLDASM
61.5 x 20.0 x 31.0 mm
xl330-m288-t1
leg_腿部
