mengwei666/my_microduck/microduck-replica-cad-master/SolidWorks-FT2026-09-25/06_左踝脚-FT.SLDASM

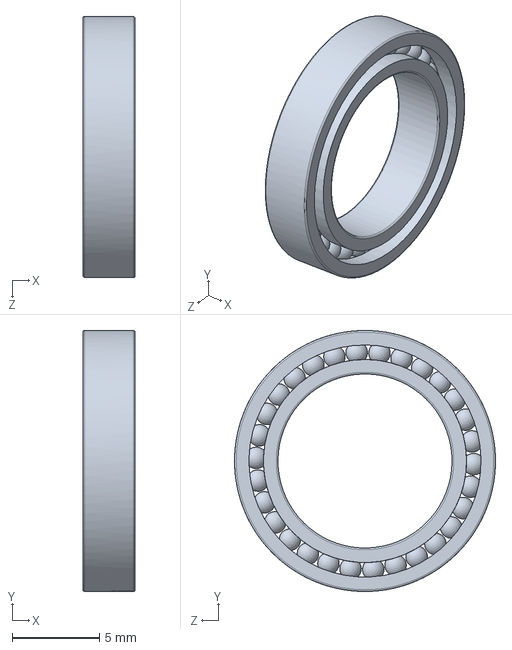
[picture p44: CAD file, 2026-10-21]
microduck-replica-cad-master/SolidWorks-FT2026-09-25/06_左踝脚-FT.SLDASM
3.00 x 15.0 x 15.0 mm
