mengwei666/my_microduck/microduck-replica-cad-master/SolidWorks-FT2026-09-25/03_左髋roll-FT.SLDASM

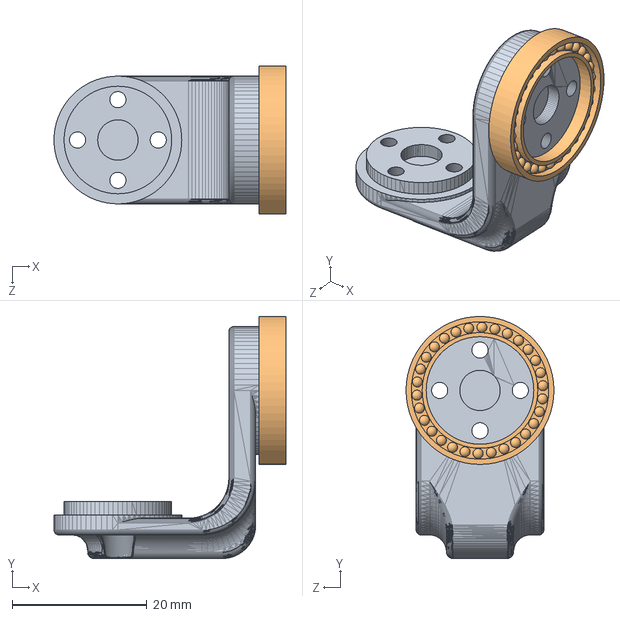
[picture p45: CAD file, 2026-10-21]
microduck-replica-cad-master/SolidWorks-FT2026-09-25/03_左髋roll-FT.SLDASM
34.5 x 36.0 x 22.0 mm
hip_l_髋部左-FT
轴承16×22×4-FT
