mengwei666/my_microduck/microduck-replica-cad-master/SolidWorks-XL330-v1.1/08_颈俯仰.SLDASM

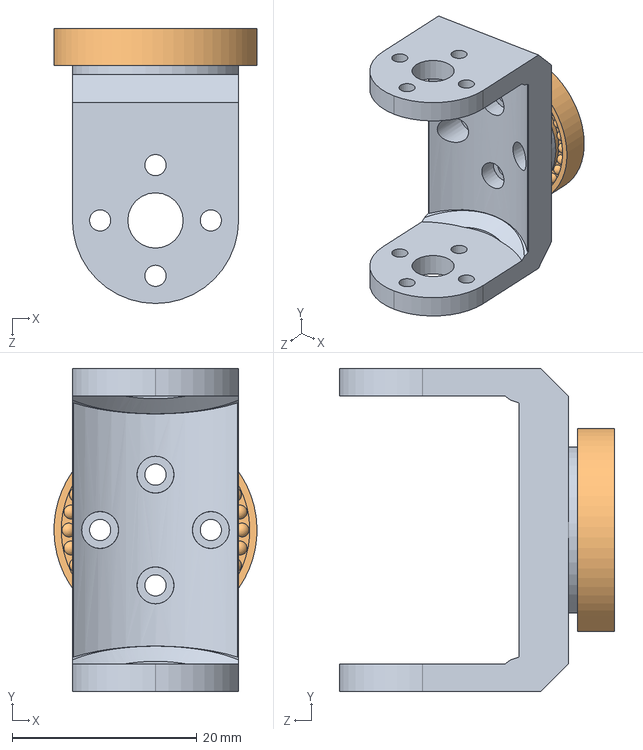
[picture p46: CAD file, 2026-10-21]
microduck-replica-cad-master/SolidWorks-XL330-v1.1/08_颈俯仰.SLDASM
22.0 x 35.0 x 29.8 mm
neck_pitch_颈部俯仰
轴承16×22×4
