mengwei666/my_microduck/microduck-replica-cad-master/SolidWorks-FT2026-09-25/01_躯干主体-FT.SLDASM

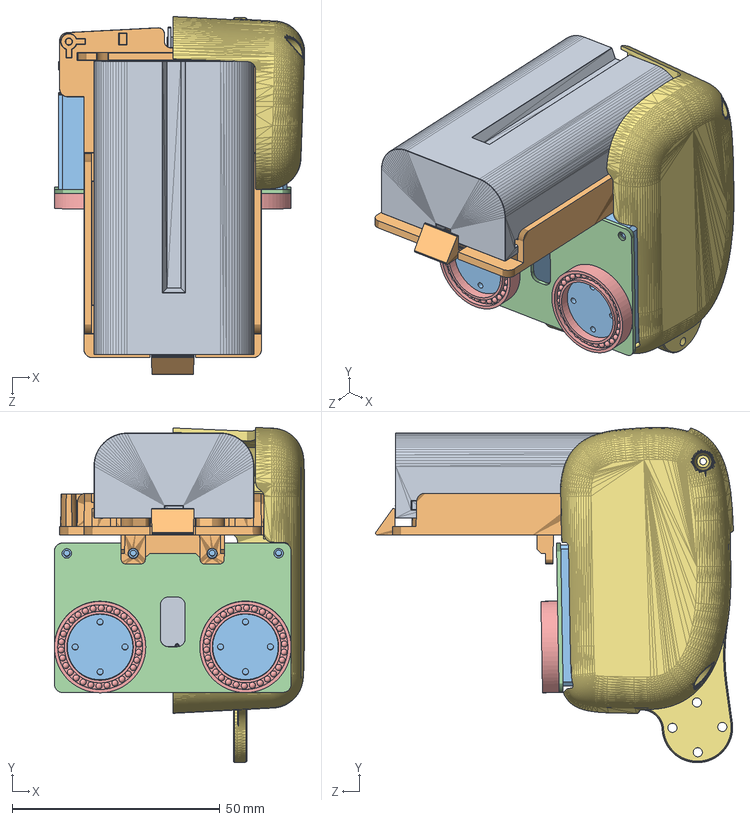
[picture p47: CAD file, 2026-10-21]
microduck-replica-cad-master/SolidWorks-FT2026-09-25/01_躯干主体-FT.SLDASM
60.3 x 80.7 x 86.2 mm
np_f970_NPF970电池-FT
power_support_电源支架-FT
HD-1910-c001-dan x 2
trunk_base_躯干底座-FT
轴承16×22×4-FT x 2
banana_pcb_locker_香蕉形PCB锁扣-FT
right_shell_右壳-FT
M2铜柱-FT
3D_PCB1_2026-09-08-FT
