mengwei666/my_microduck/microduck-replica-cad-master/SolidWorks-XL330-v1.1/09_头yaw-roll.SLDASM

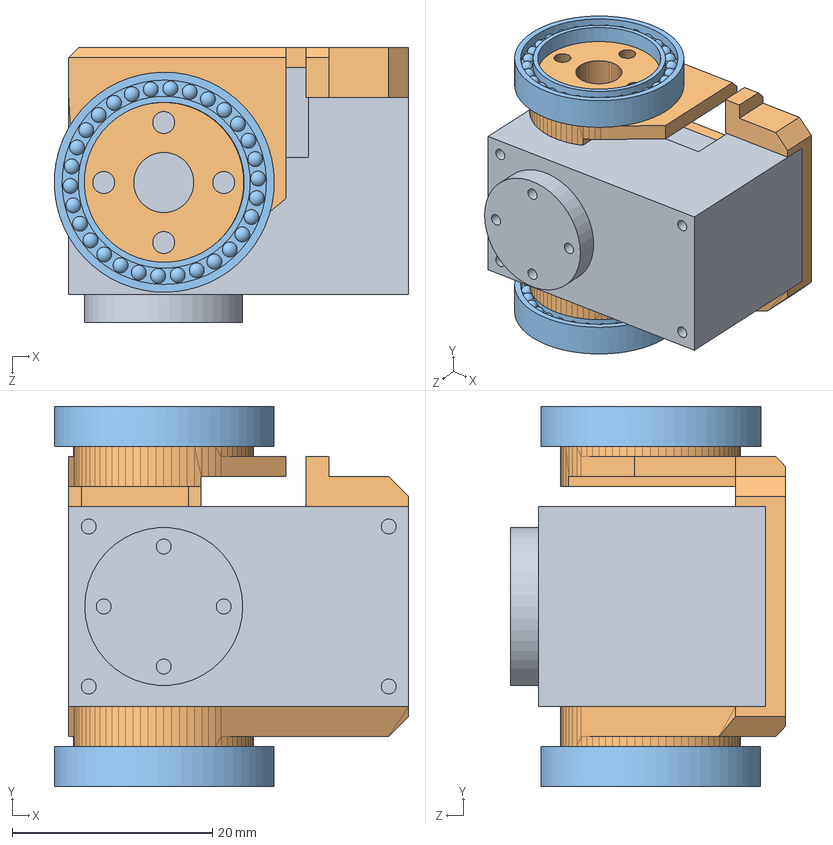
[picture p48: CAD file, 2026-10-21]
microduck-replica-cad-master/SolidWorks-XL330-v1.1/09_头yaw-roll.SLDASM
35.4 x 38.0 x 27.5 mm
xl330-m288-t1
yaw_roll_motion_偏航横滚运动
轴承16×22×4 x 2
