mengwei666/my_microduck/microduck-replica-cad-master/SolidWorks-FT2026-09-25/04_左大腿-FT.SLDASM

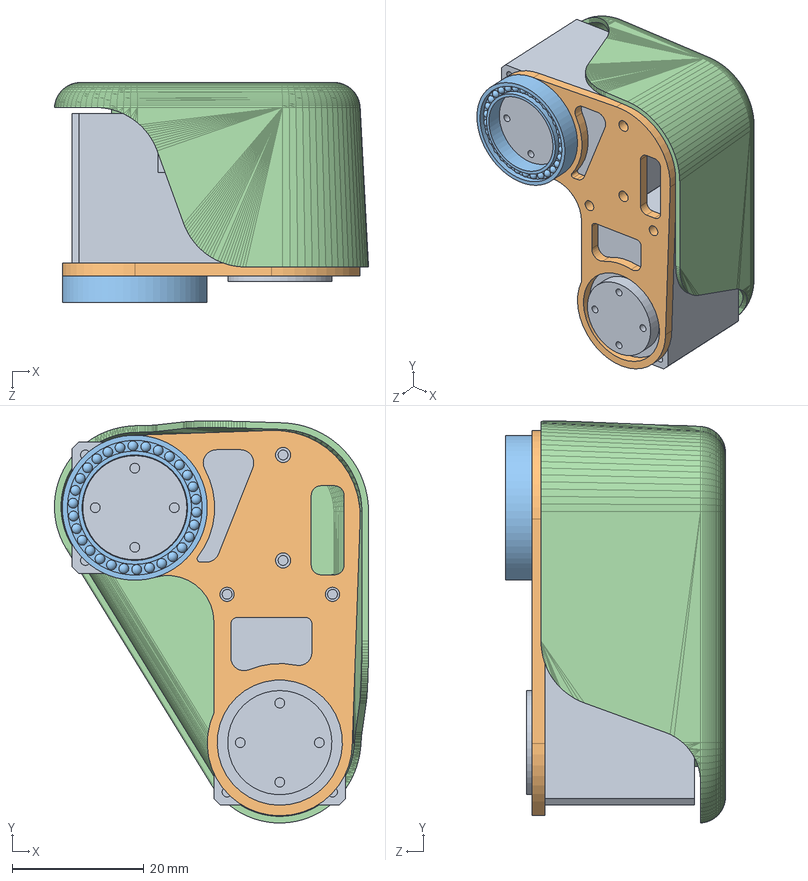
[picture p49: CAD file, 2026-10-21]
microduck-replica-cad-master/SolidWorks-FT2026-09-25/04_左大腿-FT.SLDASM
47.7 x 61.0 x 33.4 mm
HD-1910-c001-dan x 2
01-upper_leg_rigidity_plate_上腿加固板-FT
轴承16×22×4-FT
left_upper_leg_左上腿-FT
