mengwei666/my_microduck/microduck-replica-cad-master/SolidWorks-FT2026-09-25/02_左髋yaw-roll-FT.SLDASM

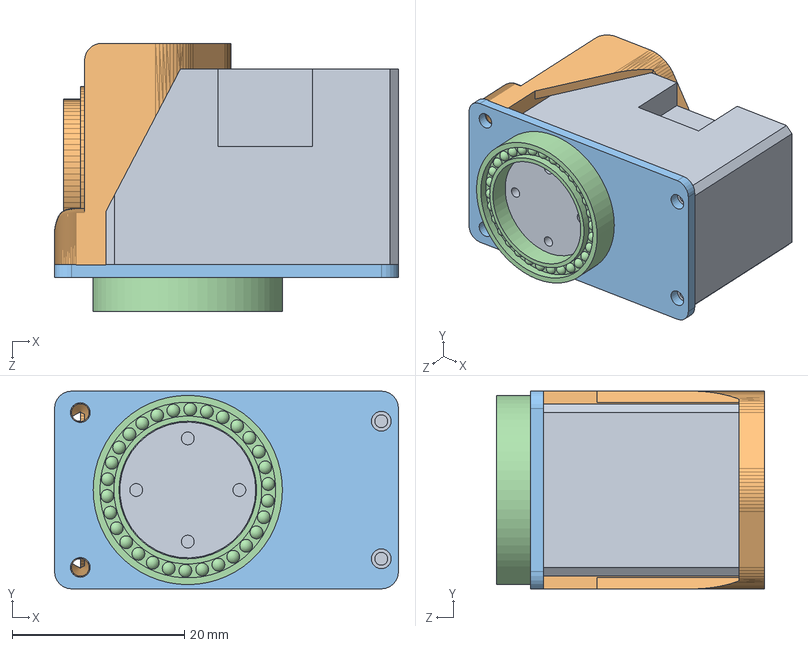
[picture p50: CAD file, 2026-10-21]
microduck-replica-cad-master/SolidWorks-FT2026-09-25/02_左髋yaw-roll-FT.SLDASM
40.0 x 23.0 x 31.2 mm
HD-1910-c001-dan
yaw2roll_偏航转横滚-FT
bearing_roll_轴承滚轮-FT
轴承16×22×4-FT
