mengwei666/my_microduck/microduck-replica-cad-master/SolidWorks-FT2026-09-25/09_头yaw-roll-FT.SLDASM

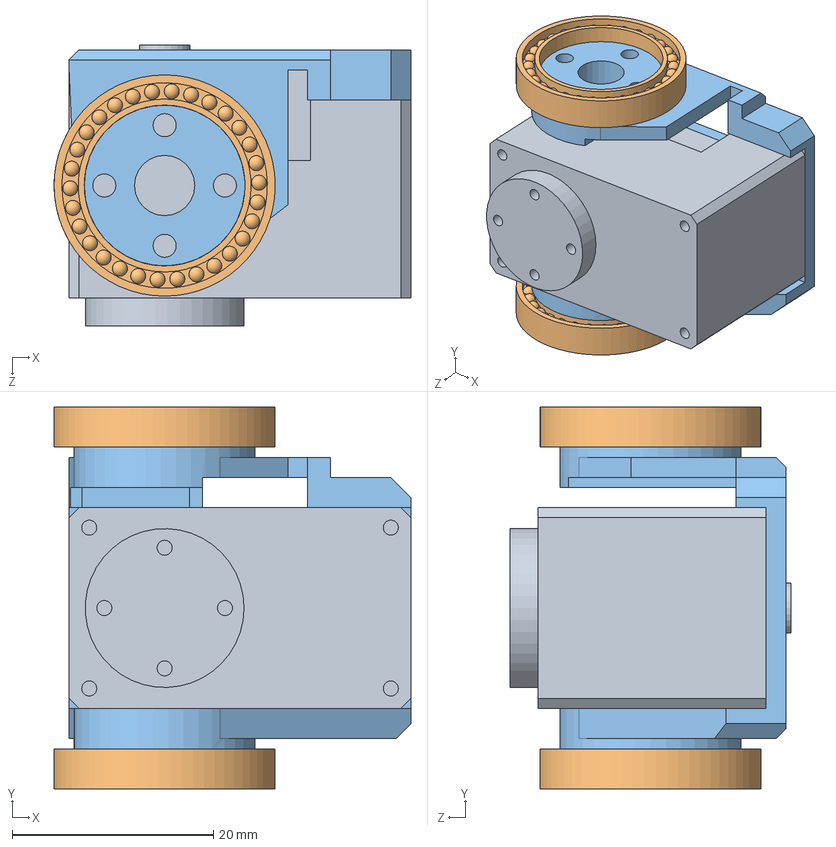
[picture p51: CAD file, 2026-10-21]
microduck-replica-cad-master/SolidWorks-FT2026-09-25/09_头yaw-roll-FT.SLDASM
35.5 x 38.0 x 28.0 mm
HD-1910-c001-dan
轴承16×22×4-FT x 2
99-yaw_roll_motion_偏航横滚运动-F
