mengwei666/my_microduck/microduck-replica-cad-master/SolidWorks-XL330-v1.1/14_右小腿.SLDASM

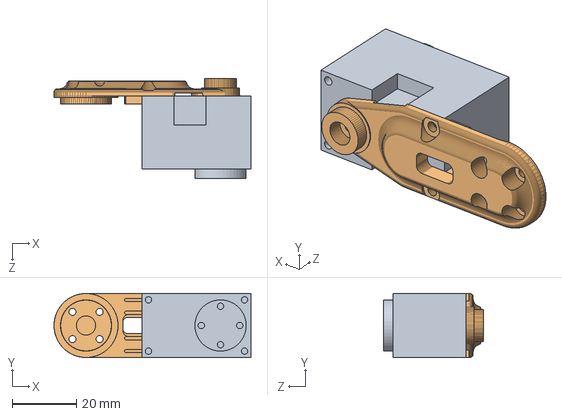
[picture p52: CAD file, 2026-10-21]
microduck-replica-cad-master/SolidWorks-XL330-v1.1/14_右小腿.SLDASM
61.5 x 20.0 x 31.2 mm
舵机xl330-288
leg_腿部
