mengwei666/my_microduck/microduck-replica-cad-master/SolidWorks-FT2026-09-25/13_右大腿-FT.SLDASM

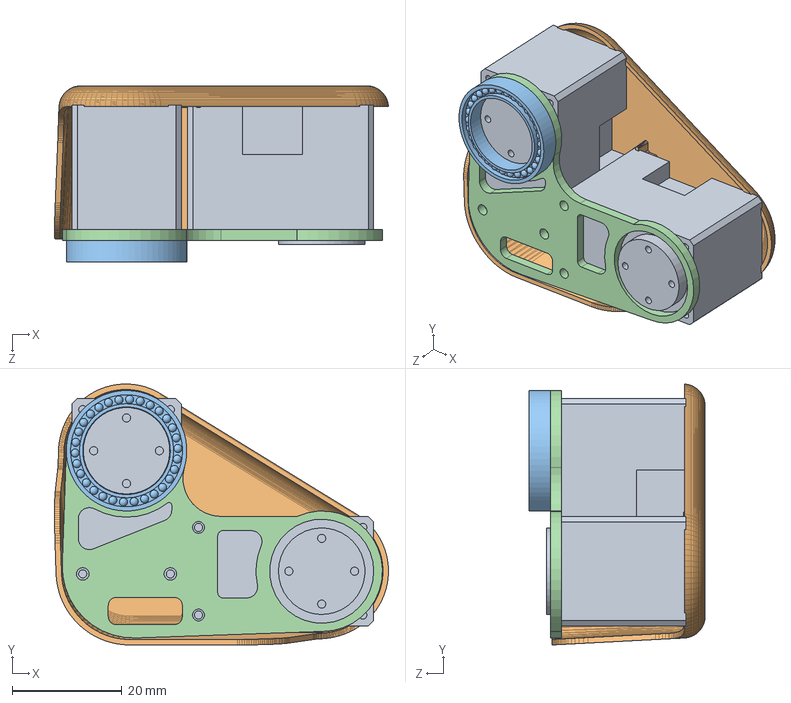
[picture p53: CAD file, 2026-10-21]
microduck-replica-cad-master/SolidWorks-FT2026-09-25/13_右大腿-FT.SLDASM
61.0 x 47.7 x 32.2 mm
HD-1910-c001-dan x 2
right_upper_leg_右上腿-FT
轴承16×22×4-FT
01-upper_leg_rigidity_plate_上腿加固板-FT
