mengwei666/my_microduck/microduck-replica-cad-master/SolidWorks-XL330-v1.1/13_右大腿.SLDASM

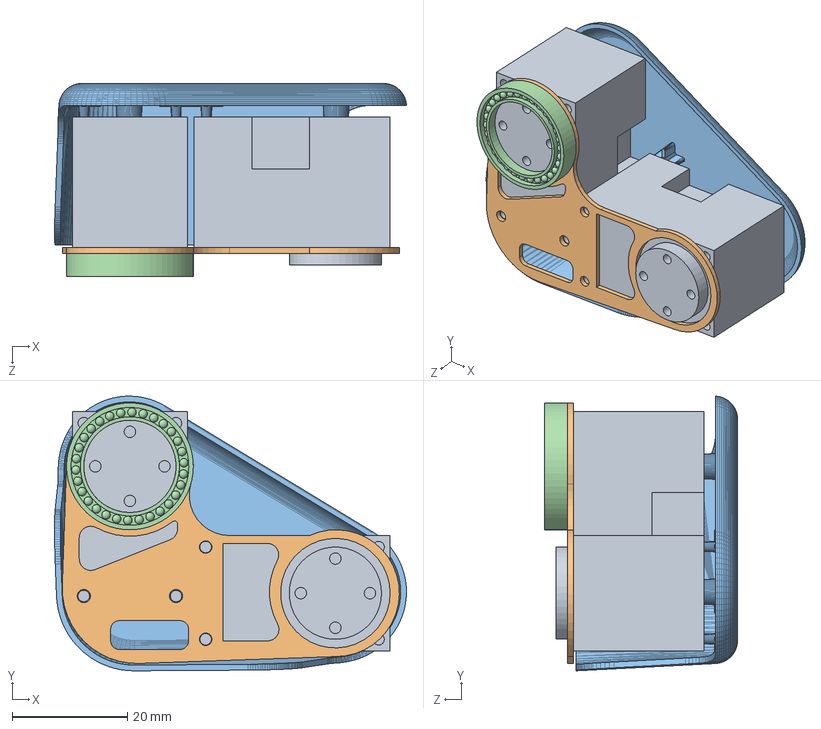
[picture p54: CAD file, 2026-10-21]
microduck-replica-cad-master/SolidWorks-XL330-v1.1/13_右大腿.SLDASM
61.1 x 47.7 x 33.5 mm
舵机xl330-288 x 2
01-upper_leg_rigidity_plate_上腿加固板
right_upper_leg_右上腿
轴承16×22×4
