mengwei666/my_microduck/microduck-replica-cad-master/SolidWorks-FT2026-09-25/07_颈根-FT.SLDASM

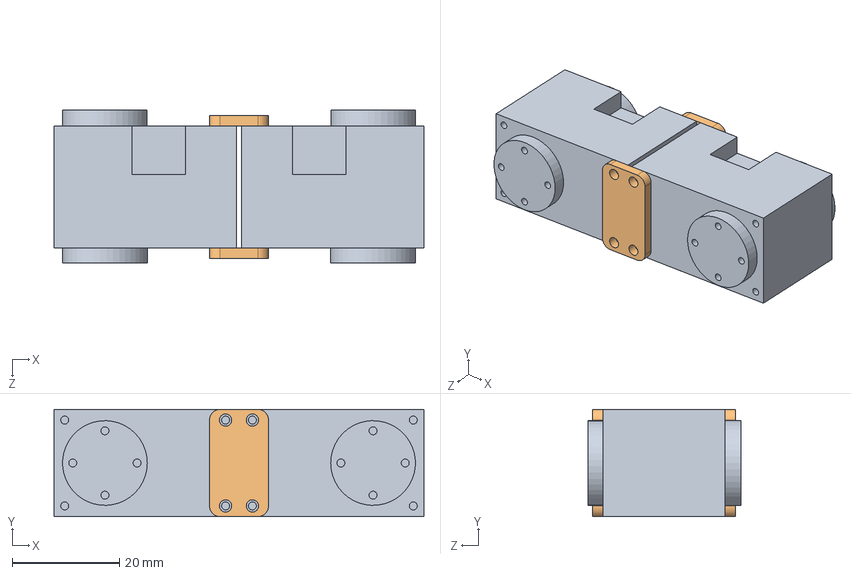
[picture p55: CAD file, 2026-10-21]
microduck-replica-cad-master/SolidWorks-FT2026-09-25/07_颈根-FT.SLDASM
69.0 x 20.0 x 28.5 mm
HD-1910-c001-shuang x 2
neck_颈部-FT x 2
