mengwei666/my_microduck/microduck-replica-cad-master/SolidWorks-XL330-v1.1/06_左踝脚.SLDASM

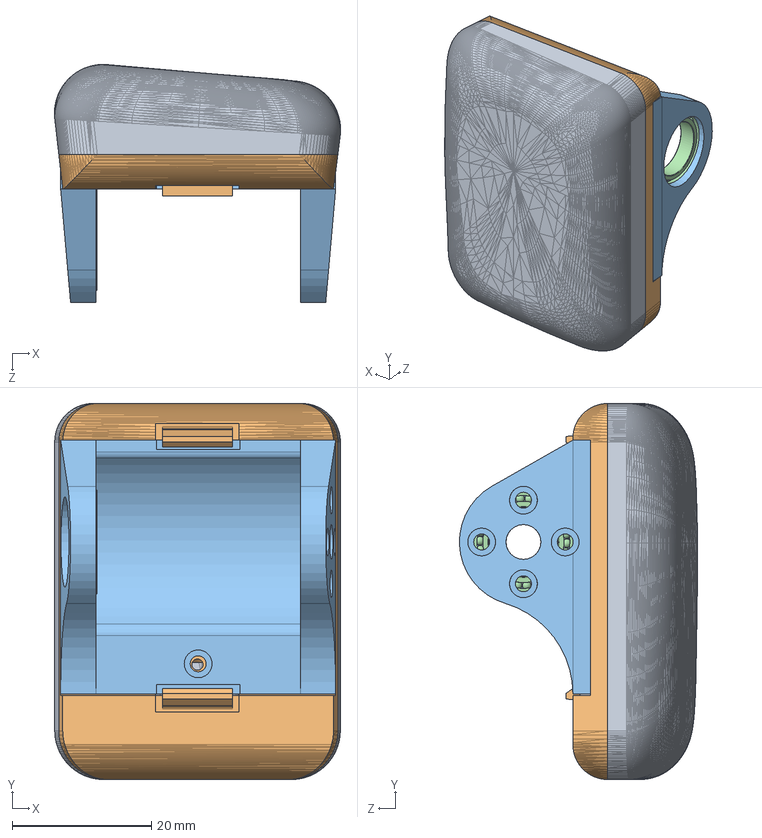
[picture p57: CAD file, 2026-10-21]
microduck-replica-cad-master/SolidWorks-XL330-v1.1/06_左踝脚.SLDASM
41.1 x 54.0 x 34.2 mm
sole_left_左脚底
foot_left_左脚
ankle_left_脚踝左
deep groove ball bearings gb
