mengwei666/my_microduck/microduck-replica-cad-master/SolidWorks-FT2026-09-25/轮滑鞋组件.SLDASM

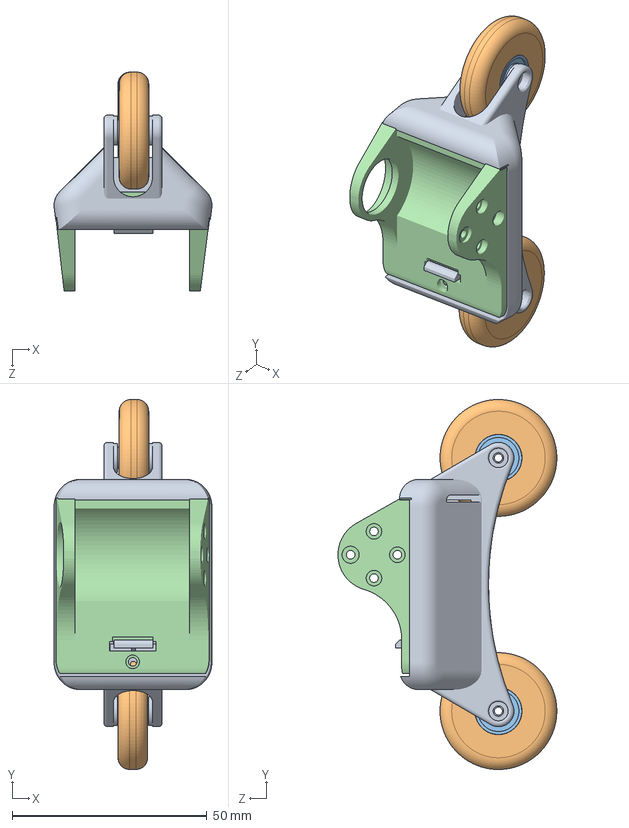
[picture p58: CAD file, 2026-10-21]
microduck-replica-cad-master/SolidWorks-FT2026-09-25/轮滑鞋组件.SLDASM
40.5 x 95.0 x 56.1 mm
roller_blade_滚轮叶片_mm
合体轮胎 x 2
轴承12×6×3 x 4
ankle_l_v1_脚踝左V1
