mengwei666/my_microduck/microduck-replica-cad-master/SolidWorks-FT2026-09-25/14_右小腿-FT.SLDASM

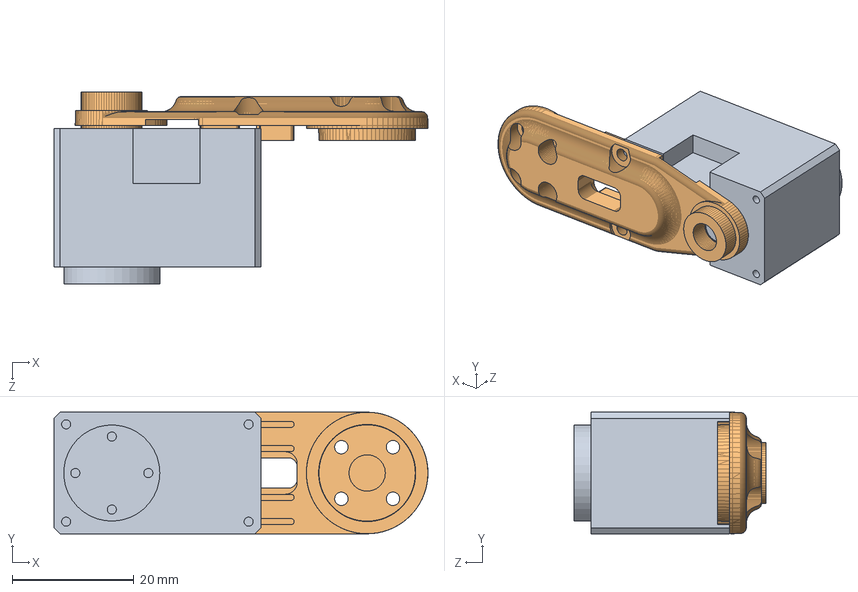
[picture p59: CAD file, 2026-10-21]
microduck-replica-cad-master/SolidWorks-FT2026-09-25/14_右小腿-FT.SLDASM
61.5 x 20.0 x 31.5 mm
HD-1910-c001-dan
leg_腿部-FT
