mengwei666/my_microduck/microduck-replica-cad-master/SolidWorks-FT2026-09-25/motor_support_电机支架-FT.SLDPRT

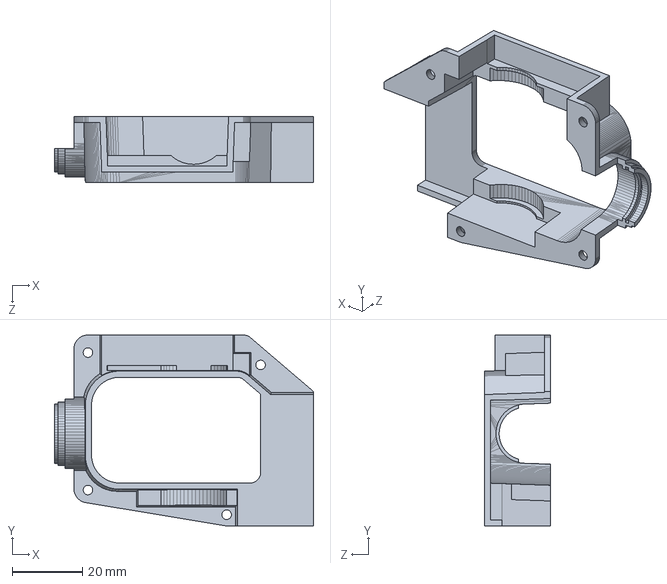
[picture p60: CAD file, 2026-10-21]
microduck-replica-cad-master/SolidWorks-FT2026-09-25/motor_support_电机支架-FT.SLDPRT
73.5 x 54.2 x 18.8 mm
