mengwei666/my_microduck/microduck-replica-cad-master/SolidWorks-XL330-v1.1/foot_left_左脚.SLDPRT

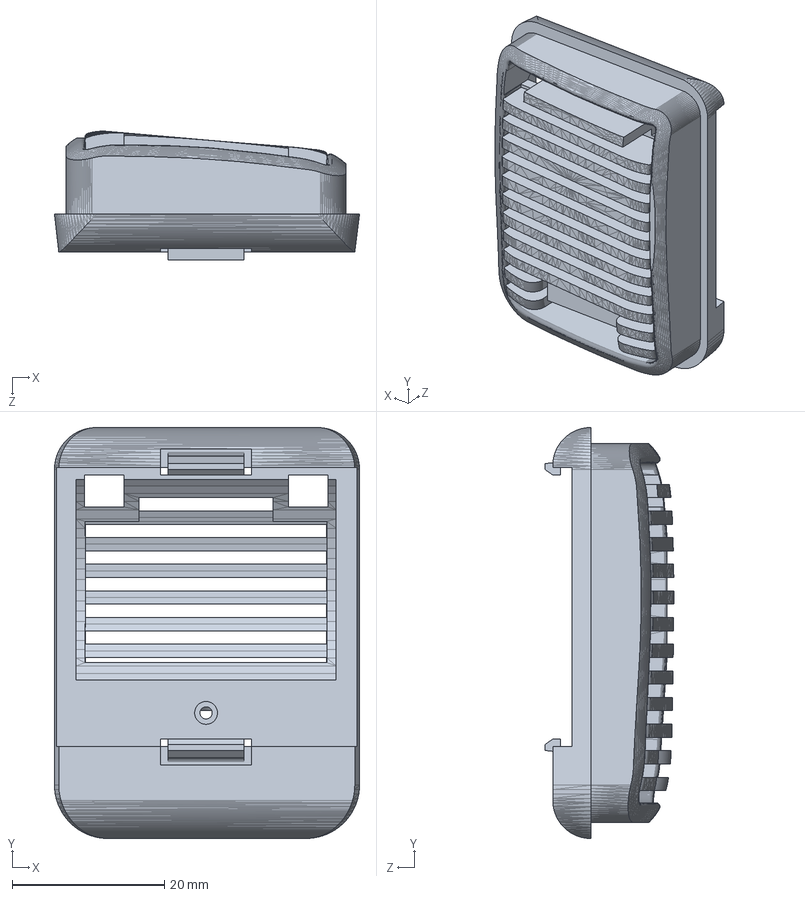
[picture p61: CAD file, 2026-10-21]
microduck-replica-cad-master/SolidWorks-XL330-v1.1/foot_left_左脚.SLDPRT
40.1 x 54.0 x 16.9 mm
