mengwei666/my_microduck/microduck_rl/src/mjlab_microduck/robot/microduck/assets/soft_mouth_top.stl

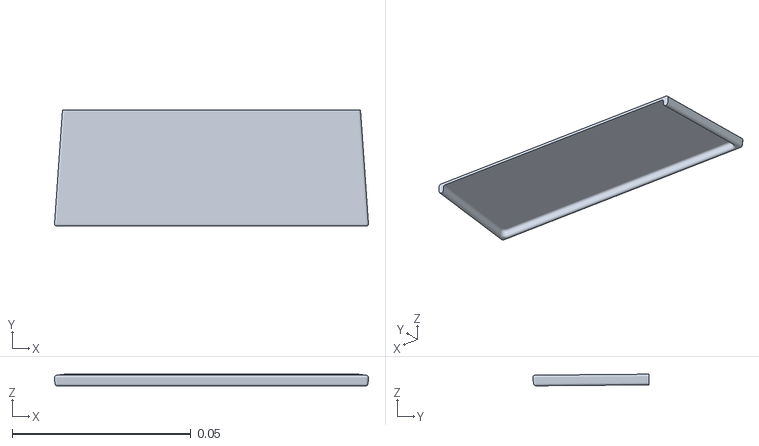
[picture p63: CAD file, 2026-09-17]
microduck_rl/src/mjlab_microduck/robot/microduck/assets/soft_mouth_top.stl
0.0878 x 0.0326 x 0.00328
