mengwei666/my_microduck/microduck_rl/src/mjlab_microduck/robot/xl330_test_bench/assets/part_4.stl

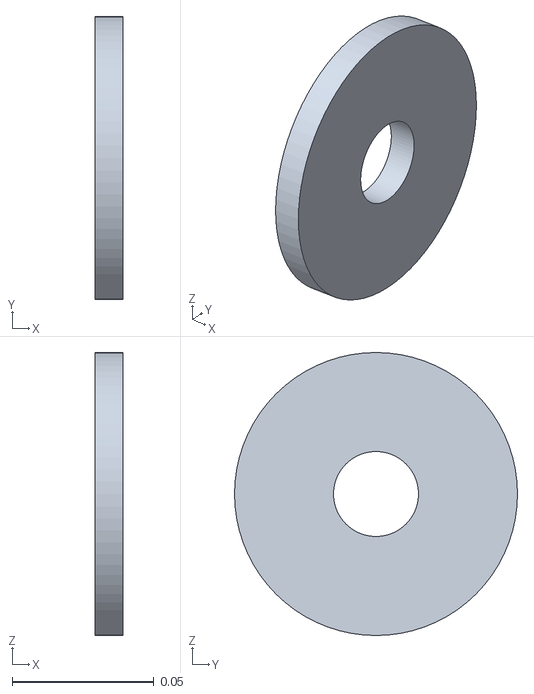
[picture p64: CAD file, 2026-09-17]
microduck_rl/src/mjlab_microduck/robot/xl330_test_bench/assets/part_4.stl
0.01 x 0.1 x 0.1
