mengwei666/my_microduck/microduck_scs225/ascll/02_左髋yaw-roll/yaw2roll_偏航转横滚-FT.STEP

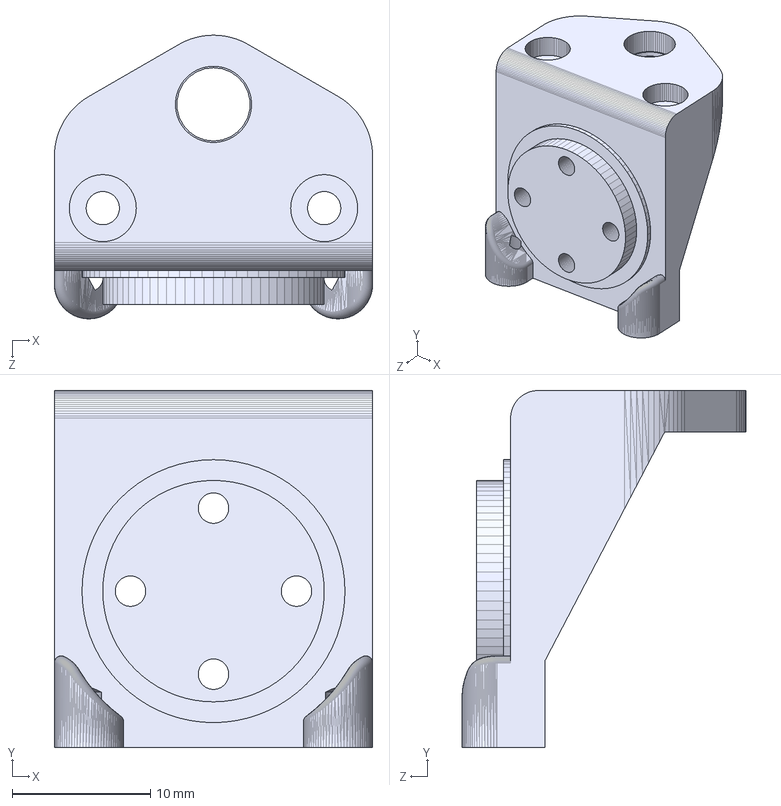
[picture p65: CAD file, 2026-10-20]
microduck_scs225/ascll/02_左髋yaw-roll/yaw2roll_偏航转横滚-FT.STEP
23.0 x 25.8 x 20.5 mm
