mengwei666/my_microduck/microduck_scs225/ascll/03_左髋roll/hip_l_髋部左-FT.STEP

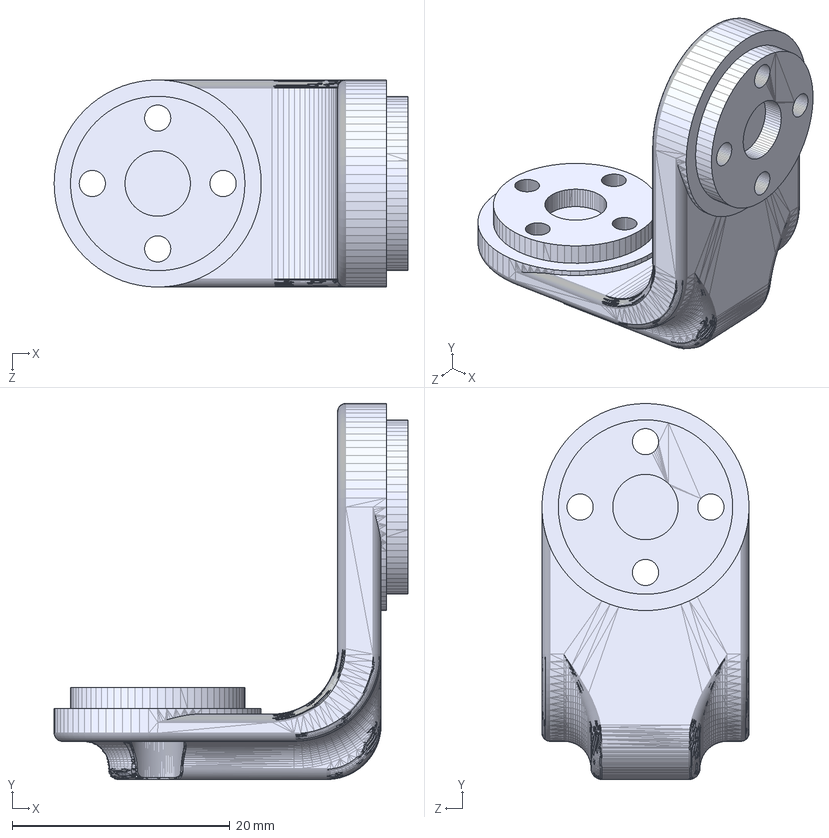
[picture p66: CAD file, 2026-10-20]
microduck_scs225/ascll/03_左髋roll/hip_l_髋部左-FT.STEP
32.5 x 34.5 x 19.0 mm
