mengwei666/my_microduck/microduck_scs225/ascll/04_左大腿/01-upper_leg_rigidity_plate_上腿加固板-FT.STEP

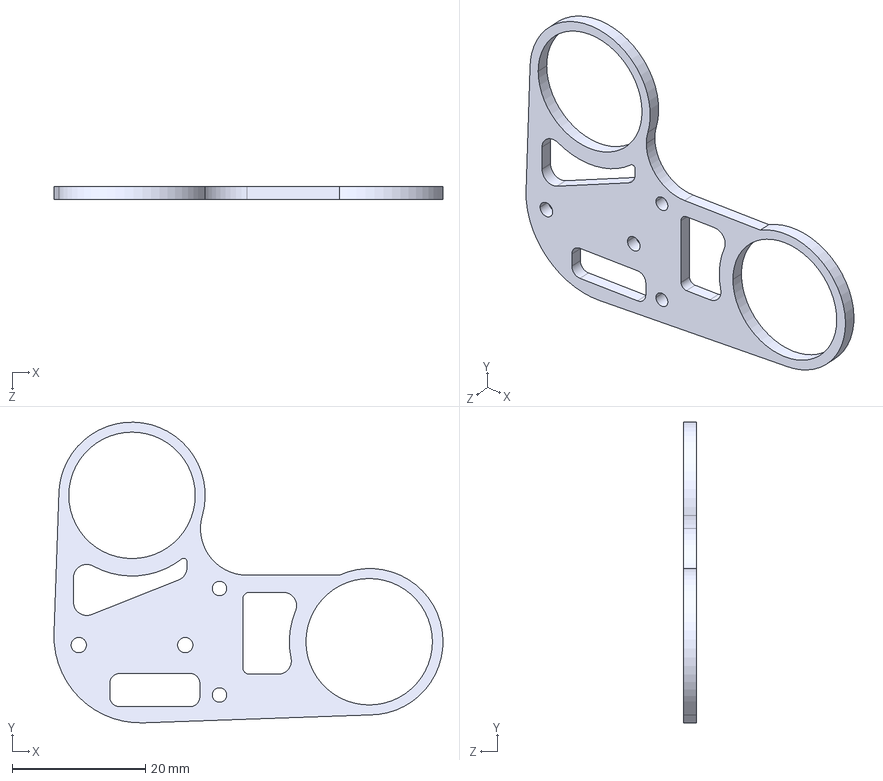
[picture p67: CAD file, 2026-10-20]
microduck_scs225/ascll/04_左大腿/01-upper_leg_rigidity_plate_上腿加固板-FT.STEP
58.5 x 45.2 x 2.00 mm
