mengwei666/my_microduck/microduck_scs225/ascll/05_左小腿/HD-1910-c001-dan.STEP

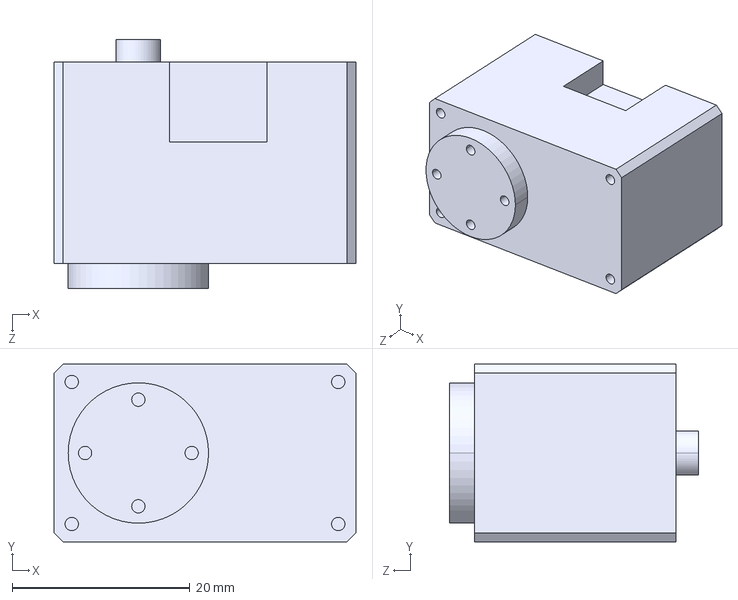
[picture p68: CAD file, 2026-10-20]
microduck_scs225/ascll/05_左小腿/HD-1910-c001-dan.STEP
34.0 x 20.0 x 28.0 mm
