mengwei666/my_microduck/microduck_scs225/leg_cad/ft_changed_parts/STEP-changed-parts-FT 2026-09-30/bearing_roll_轴承滚轮-FT.STEP

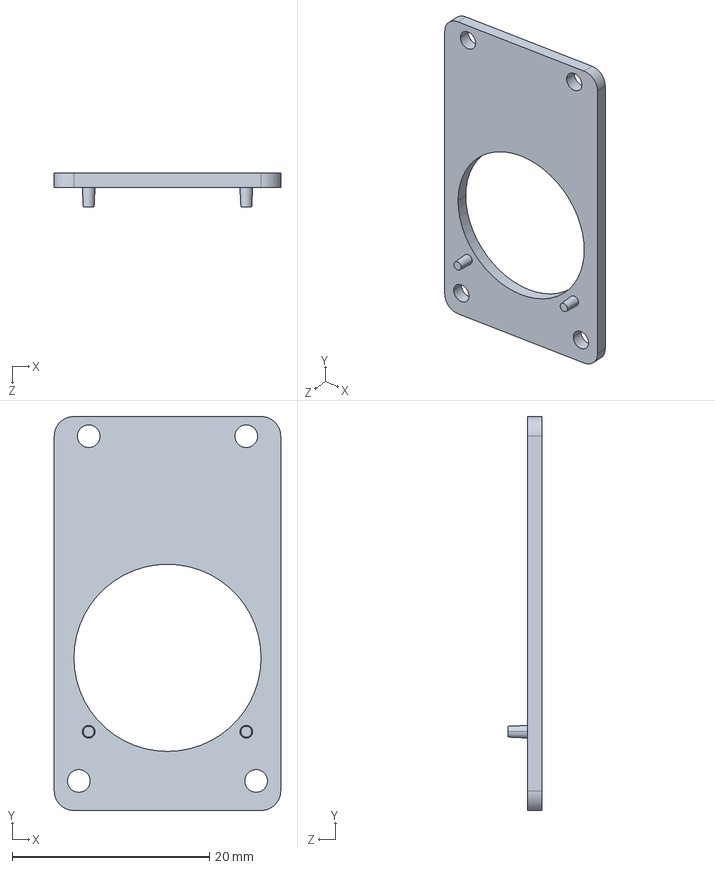
[picture p69: CAD file, 2026-10-20]
microduck_scs225/leg_cad/ft_changed_parts/STEP-changed-parts-FT 2026-09-30/bearing_roll_轴承滚轮-FT.STEP
23.0 x 40.0 x 3.50 mm
