mengwei666/my_microduck/microduck_scs225/leg_cad/microduck_trunk_base.step

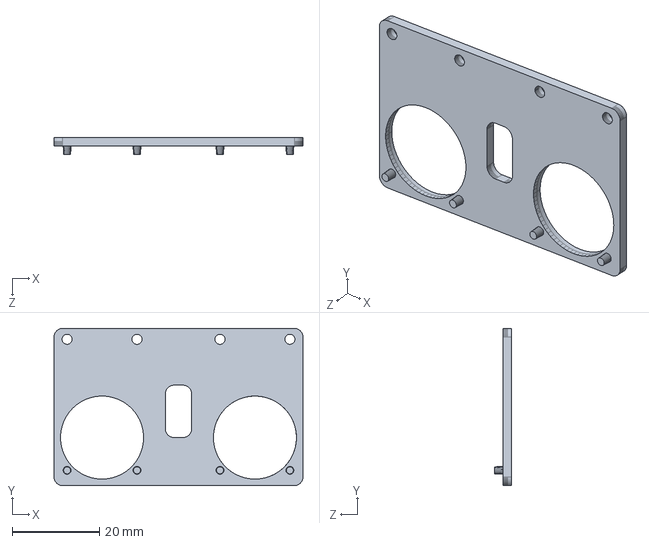
[picture p70: CAD file, 2026-10-20]
microduck_scs225/leg_cad/microduck_trunk_base.step
57.0 x 36.0 x 4.00 mm
