mengwei666/my_microduck/microduck_scs225/scs225_cad/SCS225_simplified.step

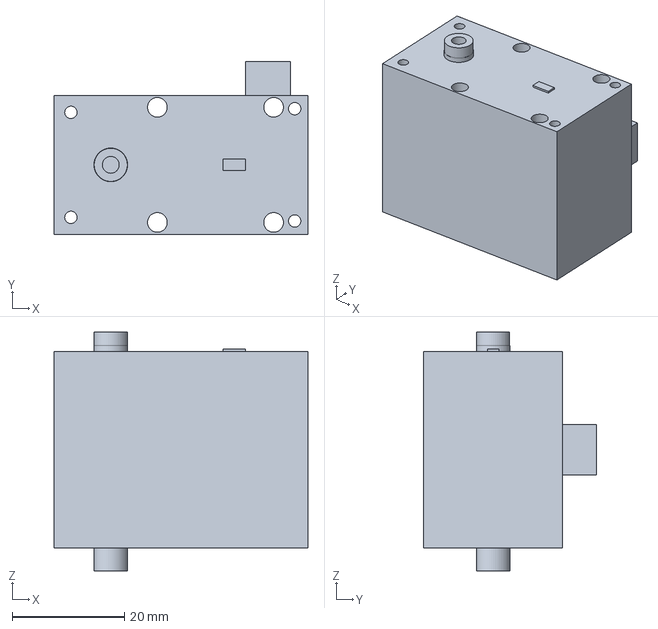
[picture p71: CAD file, 2026-10-20]
microduck_scs225/scs225_cad/SCS225_simplified.step
45.2 x 30.7 x 42.5 mm
