mengwei666/my_microduck/microduck_scs225/scs225_left_knee/left_knee_SCS225_check.step

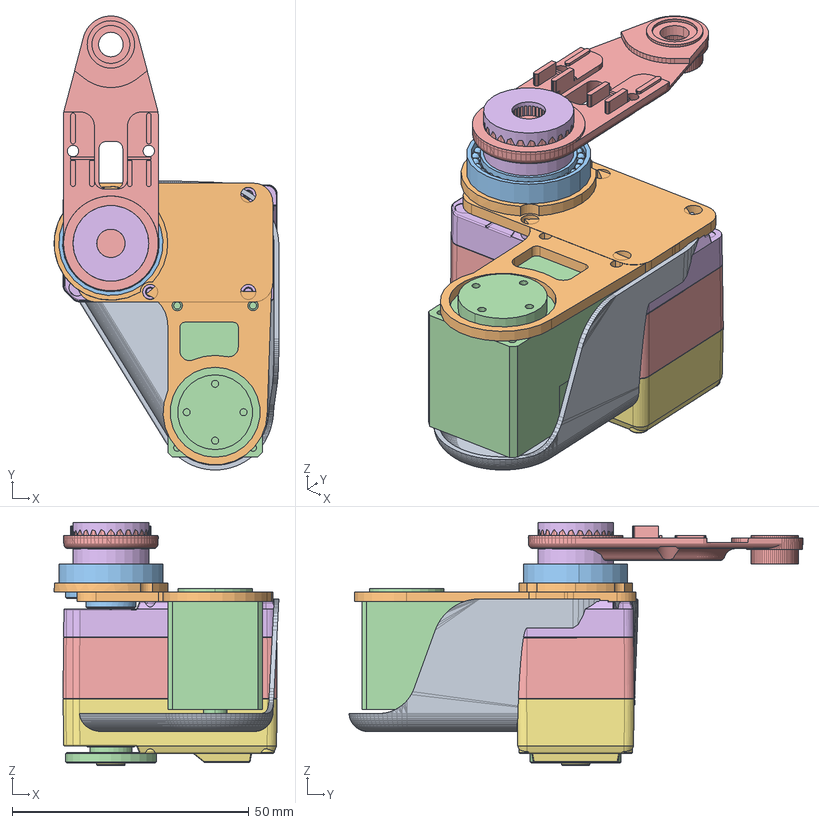
[picture p73: CAD file, 2026-10-21]
microduck_scs225/scs225_left_knee/left_knee_SCS225_check.step
47.5 x 95.8 x 51.4 mm
left_upper_leg_knee_SCS225
rigidity_plate_knee_SCS225
bearing_16x22x4_moved_up_2mm
hip_servo_HD1910_unchanged_for_reference
SCS225_at_left_knee
left_lower_leg_aligned_knee
16mm_hub_proposal_not_final
