mengwei666/my_microduck/microduck_scs225/zuo.FCStd

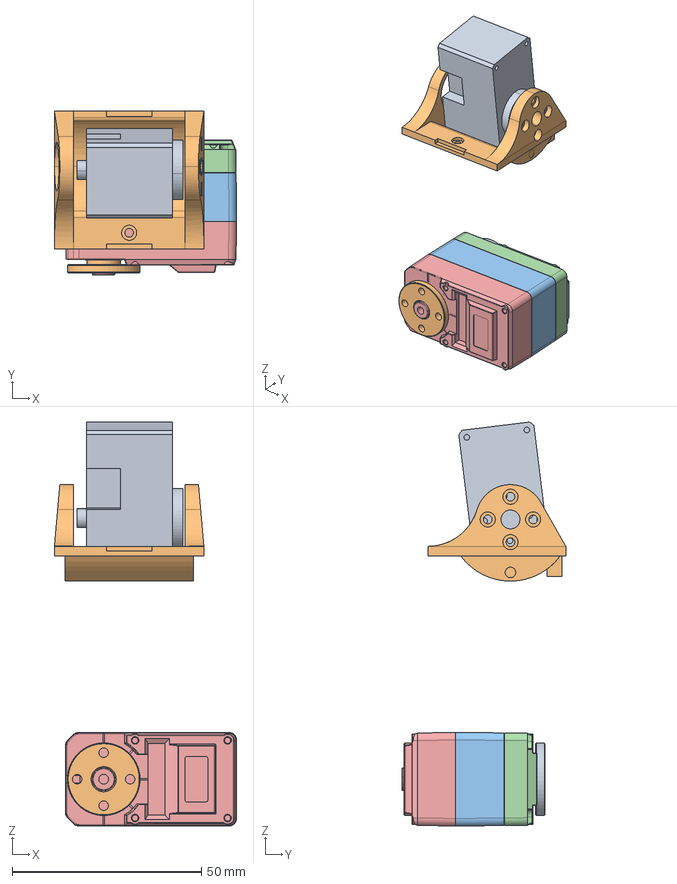
[picture p74: CAD file, 2026-10-21]
microduck_scs225/zuo.FCStd
48.1 x 43.3 x 106.7 mm
HD-1910-c001-dan
ZK_122
SG-ZIJI_15
XG-ZIJI_16
MOTOR-1723_3
PCB-CHAZUO_92
GE_27
\X2\91D15C5E823576D8FF089A7152A8FF09\X0\ v2
\X2\91D15C5E823576D8FF084ECE52A8FF09\X0\ v2
