mengwei666/my_microduck/microduck-replica-cad-master/SolidWorks-XL330-v1.1/banana_pcb_locker_香蕉形PCB锁扣.SLDPRT

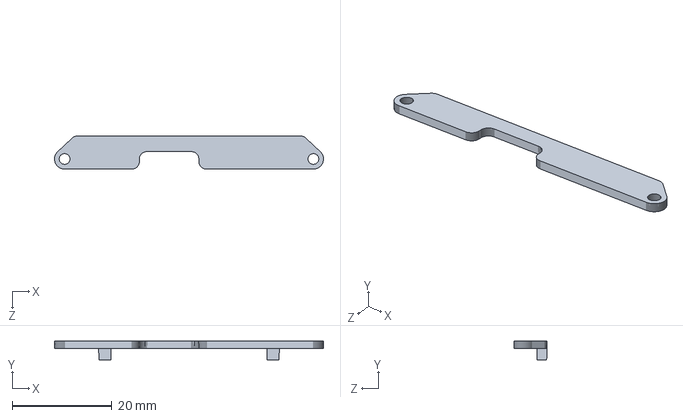
[picture p75: CAD file, 2026-10-21]
microduck-replica-cad-master/SolidWorks-XL330-v1.1/banana_pcb_locker_香蕉形PCB锁扣.SLDPRT
54.1 x 3.80 x 6.65 mm
