mengwei666/my_microduck/microduck_rl/src/mjlab_microduck/robot/microduck/assets/motor_support.stl

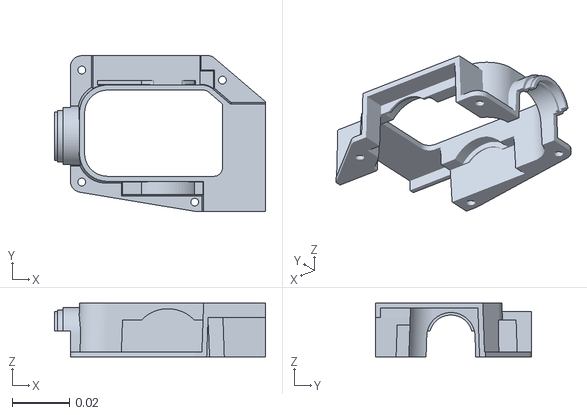
[picture p76: CAD file, 2026-09-17]
microduck_rl/src/mjlab_microduck/robot/microduck/assets/motor_support.stl
0.0735 x 0.0542 x 0.0188
