mengwei666/my_microduck/microduck_rl/src/mjlab_microduck/robot/xl330_test_bench/assets/part_5.stl

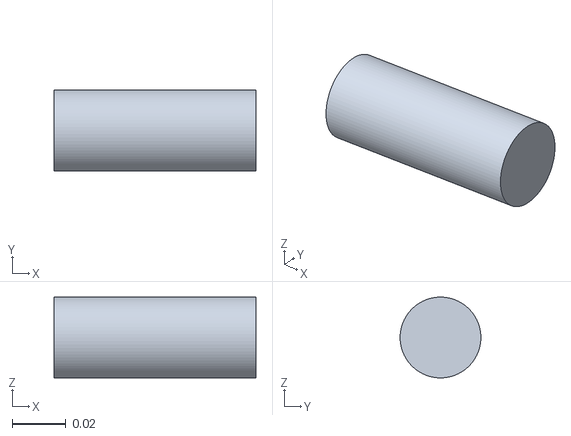
[picture p77: CAD file, 2026-09-17]
microduck_rl/src/mjlab_microduck/robot/xl330_test_bench/assets/part_5.stl
0.075 x 0.03 x 0.03
