mengwei666/my_microduck/microduck_scs225/ascll/03_左髋roll/轴承16×22×4-FT.STEP

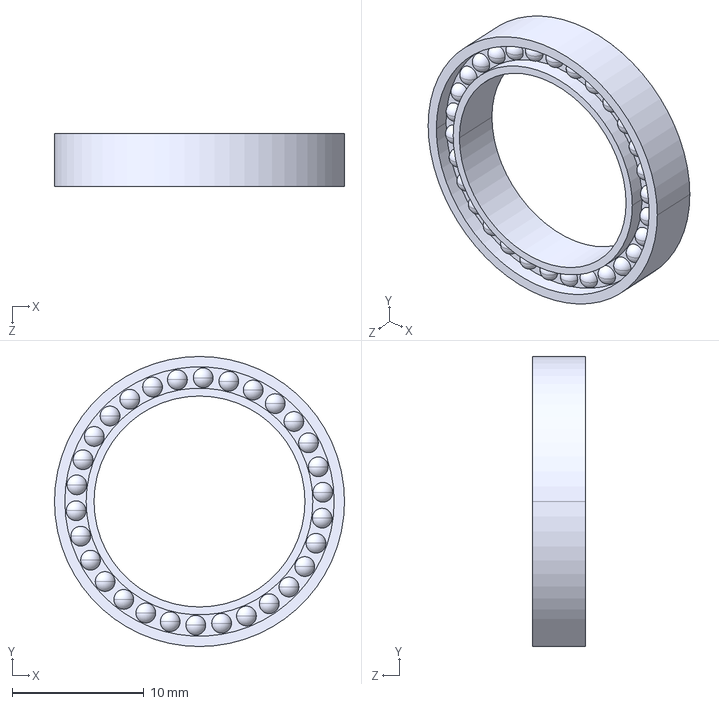
[picture p78: CAD file, 2026-10-20]
microduck_scs225/ascll/03_左髋roll/轴承16×22×4-FT.STEP
22.0 x 22.0 x 4.00 mm
