mengwei666/my_microduck/microduck_scs225/ascll/05_左小腿/leg_腿部-FT.STEP

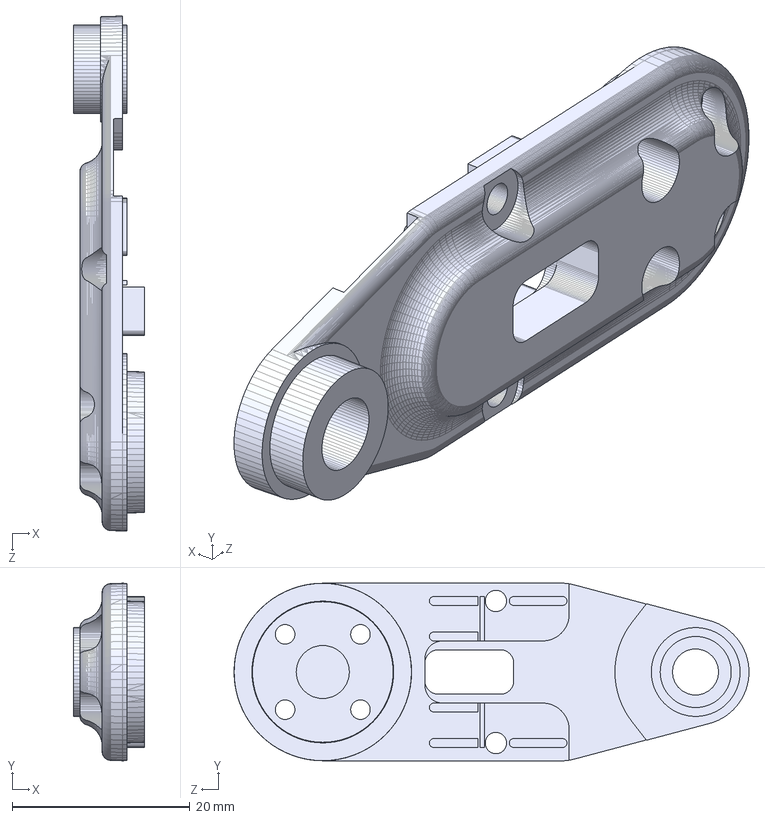
[picture p79: CAD file, 2026-10-20]
microduck_scs225/ascll/05_左小腿/leg_腿部-FT.STEP
7.95 x 20.0 x 58.0 mm
