mengwei666/my_microduck/microduck_scs225/ascll/Bus Servo Adapter (A).step

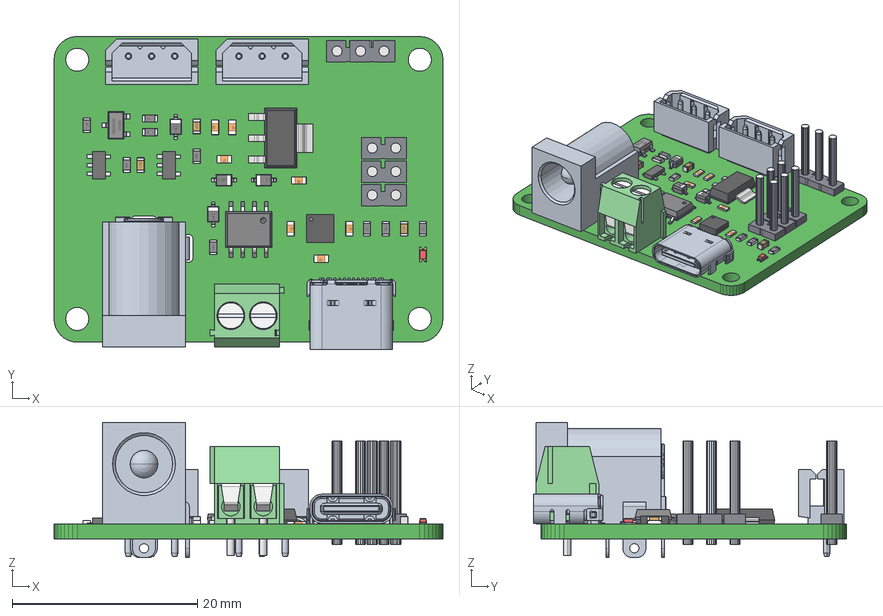
[picture p80: CAD file, 2026-10-21]
microduck_scs225/ascll/Bus Servo Adapter (A).step
42.0 x 33.8 x 14.6 mm
Board
User_Library-0603_SMD_Capacitor x 7
3_1_2_A x 3
SOD323 x 4
dc-005-5a-20
User_Library-DG350-3,5-02P
X2564WV-03-N0SN x 2
_2_1_2_3_4_AF0 x 9
_7_1_2_AF0 x 9
User_Library-QFN-16
User_Library-TO-223_1_1
User_Library-TO-223_2_1
User_Library-TO-223_3_1
User_Library-TO-223_4_1
User_Library-TO-223_5_1
User_Library-sop-8
SOT-23
Extruded x 27
User_Library-LED_0603_R_Pocket002
User_Library-LED_0603_R_Pad004
User_Library-LED_0603_R_Fillet
User_Library-LED_0603_R_Pocket001
User_Library-LED_0603_R_Pad
