mengwei666/my_microduck/microduck_scs225/leg_cad/microduck_left_upper_leg.step

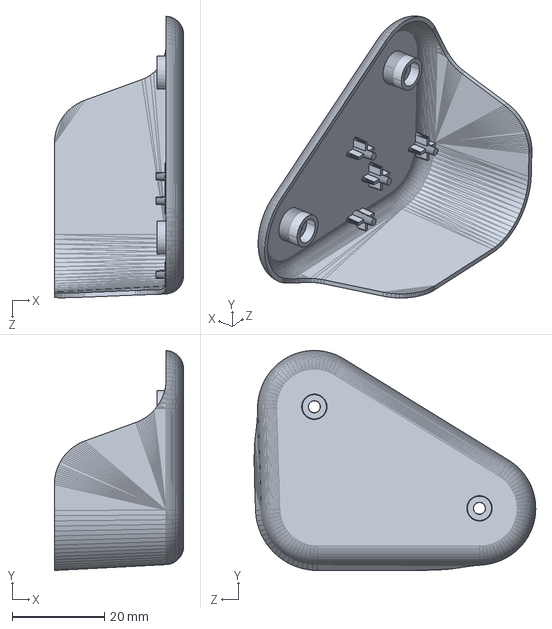
[picture p81: CAD file, 2026-10-20]
microduck_scs225/leg_cad/microduck_left_upper_leg.step
28.0 x 47.7 x 61.0 mm
