mengwei666/my_microduck/microduck_scs225/scs225_cad/SCS225_reference_ST3215.step

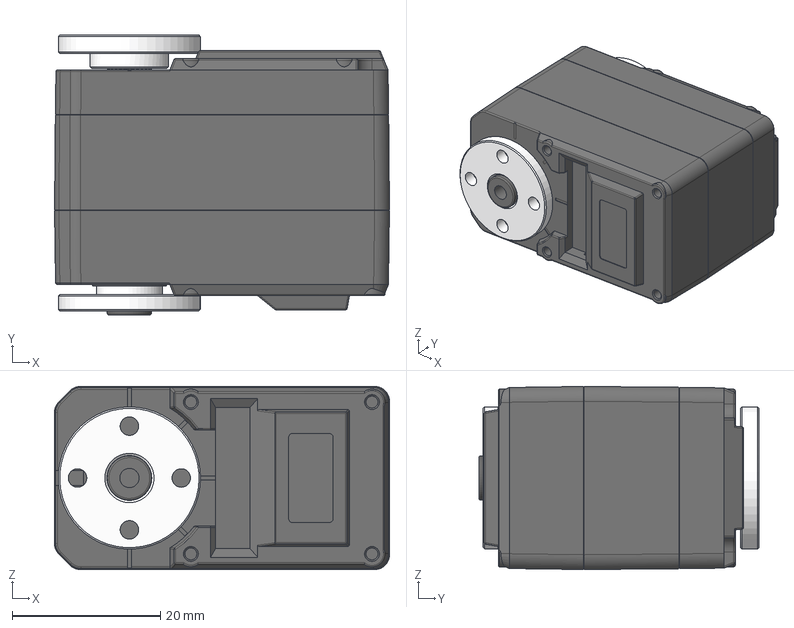
[picture p82: CAD file, 2026-10-20]
microduck_scs225/scs225_cad/SCS225_reference_ST3215.step
45.2 x 37.8 x 24.7 mm
ZK_122
SG-ZIJI_15
XG-ZIJI_16
MOTOR-1723_3
PCB-CHAZUO_92
GE_27
金属舵盘（驱动）
金属舵盘（从动）
