mengwei666/my_microduck/microduck_scs225/scs225_left_ankle/SCS225_ankle_housing.step

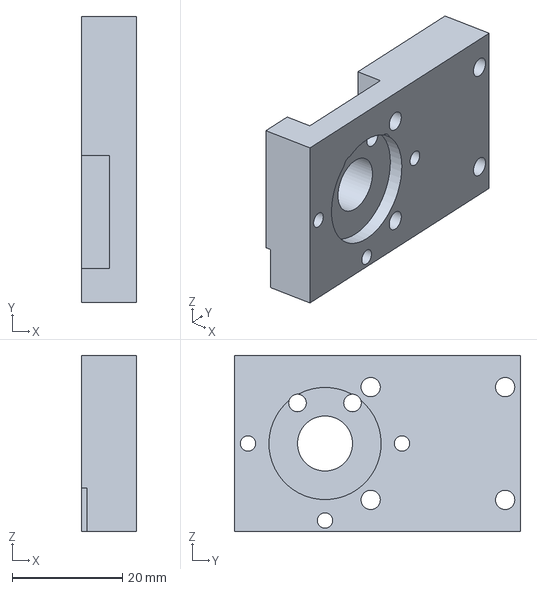
[picture p83: CAD file, 2026-10-21]
microduck_scs225/scs225_left_ankle/SCS225_ankle_housing.step
10.0 x 52.0 x 32.0 mm
