mengwei666/my_microduck/microduck_scs225/scs225_left_ankle_v2/left_ankle_SCS225_check.step

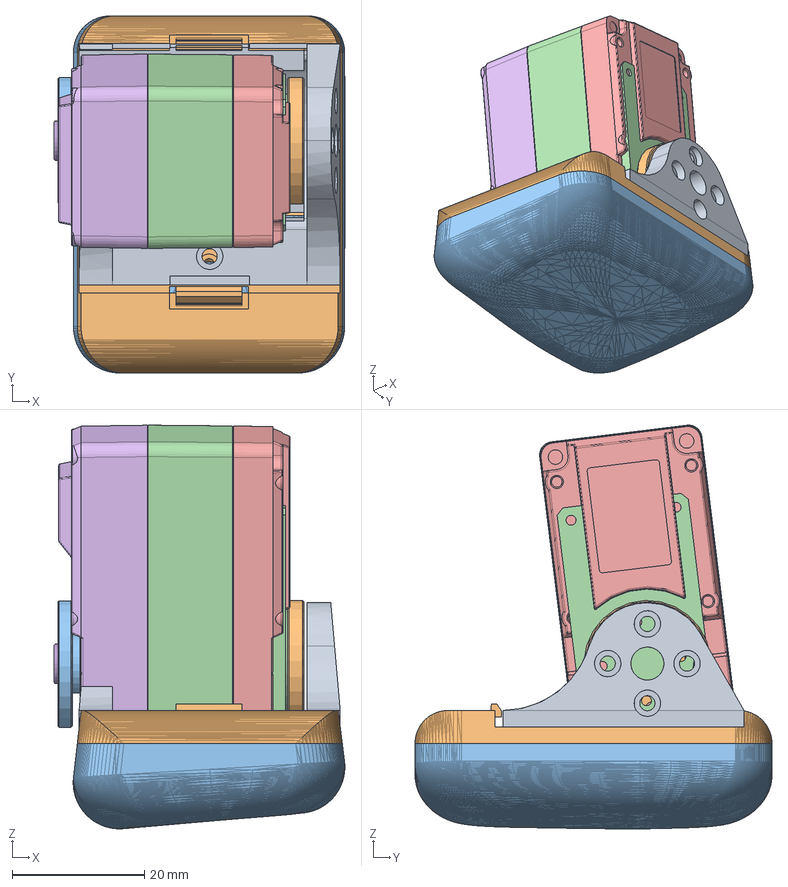
[picture p84: CAD file, 2026-10-21]
microduck_scs225/scs225_left_ankle_v2/left_ankle_SCS225_check.step
44.0 x 54.0 x 61.1 mm
ankle_left_SCS225
foot_left_SCS225
sole_left_original
SCS225_fit
HD1910_original_reference
