mengwei666/my_microduck/microduck_scs225/scs225_left_knee/left_upper_leg_rigidity_plate_knee_SCS225.step

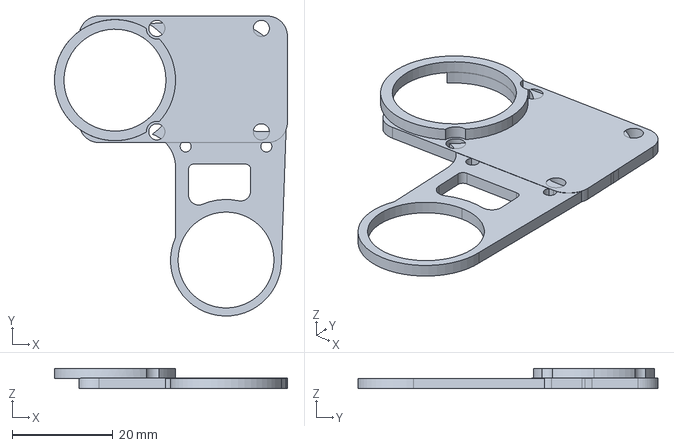
[picture p85: CAD file, 2026-10-21]
microduck_scs225/scs225_left_knee/left_upper_leg_rigidity_plate_knee_SCS225.step
46.2 x 59.4 x 4.00 mm
