mengwei666/my_microduck/microduck_scs225/左踝.FCStd

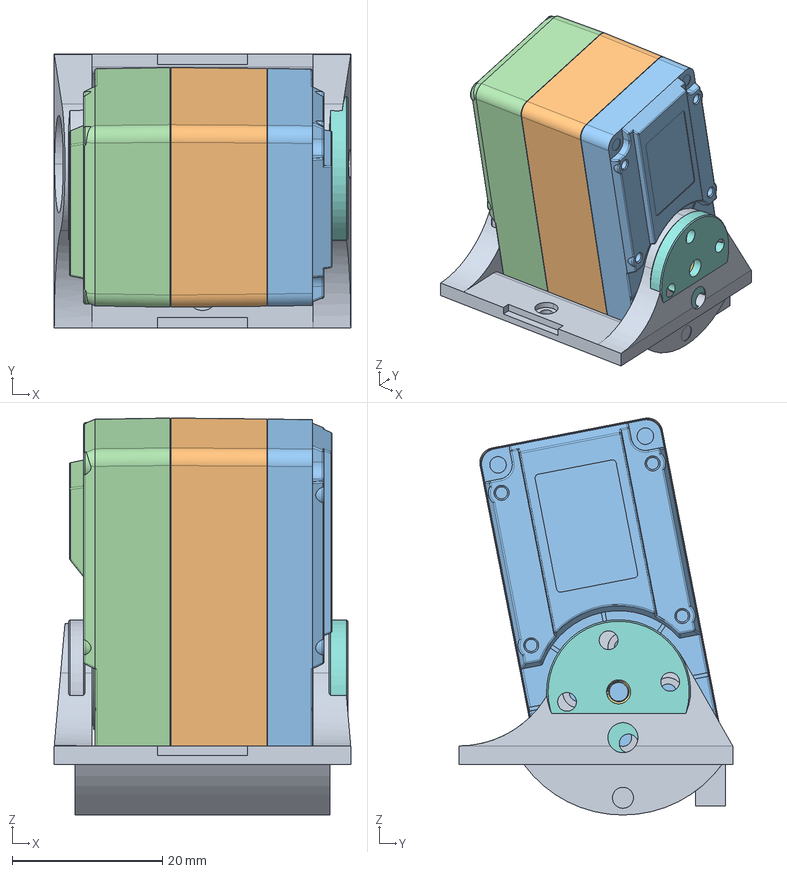
[picture p86: CAD file, 2026-10-21]
microduck_scs225/左踝.FCStd
39.5 x 36.5 x 52.9 mm
ZK_122
SG-ZIJI_15
XG-ZIJI_16
MOTOR-1723_3
PCB-CHAZUO_92
GE_27
\X2\91D15C5E823576D8FF089A7152A8FF09\X0\ v2
\X2\91D15C5E823576D8FF084ECE52A8FF09\X0\ v2
