mengwei666/my_microduck/microduck-replica-cad-master/SolidWorks-FT2026-09-25/sole_right_右脚底-FT.SLDPRT

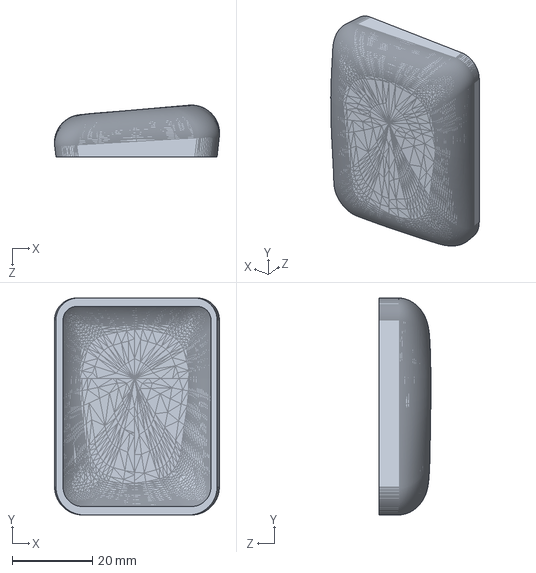
[picture p87: CAD file, 2026-10-21]
microduck-replica-cad-master/SolidWorks-FT2026-09-25/sole_right_右脚底-FT.SLDPRT
41.1 x 54.0 x 12.9 mm
