mengwei666/my_microduck/microduck_rl/src/mjlab_microduck/robot/microduck/assets/tire.stl

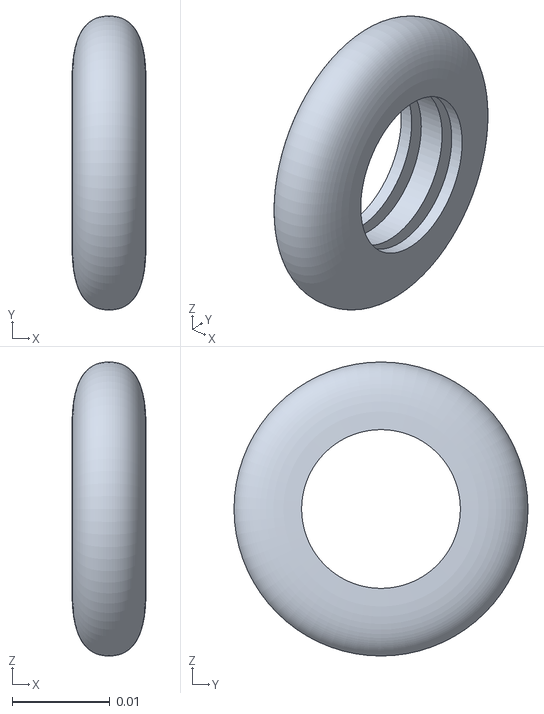
[picture p88: CAD file, 2026-09-17]
microduck_rl/src/mjlab_microduck/robot/microduck/assets/tire.stl
0.0076 x 0.03 x 0.03
