mengwei666/my_microduck/microduck_rl/src/mjlab_microduck/robot/xl330_test_bench/assets/part_1.stl

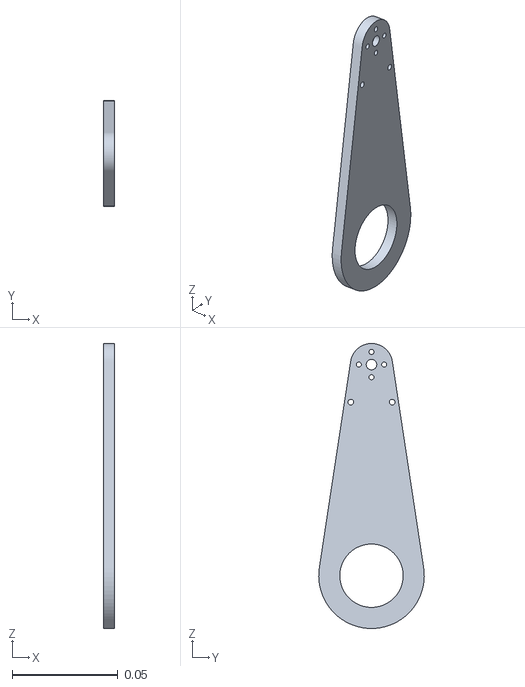
[picture p89: CAD file, 2026-09-17]
microduck_rl/src/mjlab_microduck/robot/xl330_test_bench/assets/part_1.stl
0.005 x 0.05 x 0.135
