mengwei666/my_microduck/microduck_scs225/ascll/06_左踝脚/ankle_left_脚踝左-FT.STEP

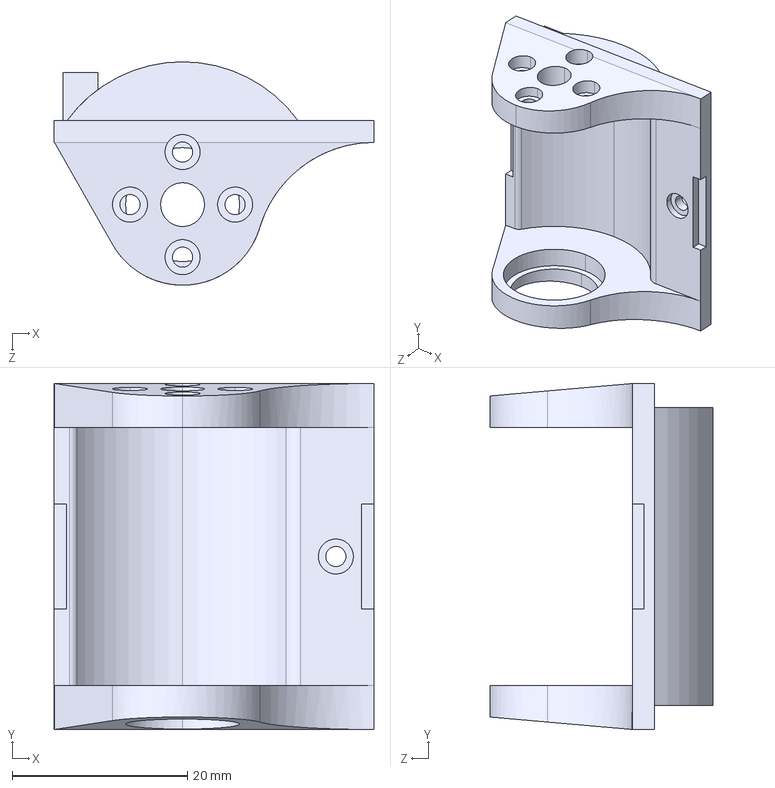
[picture p90: CAD file, 2026-10-20]
microduck_scs225/ascll/06_左踝脚/ankle_left_脚踝左-FT.STEP
36.5 x 39.5 x 25.5 mm
