mengwei666/my_microduck/microduck_scs225/leg_cad/ft_changed_parts/STEP-changed-parts-FT 2026-09-30/99-yaw_roll_motion_偏航横滚运动-F.STEP

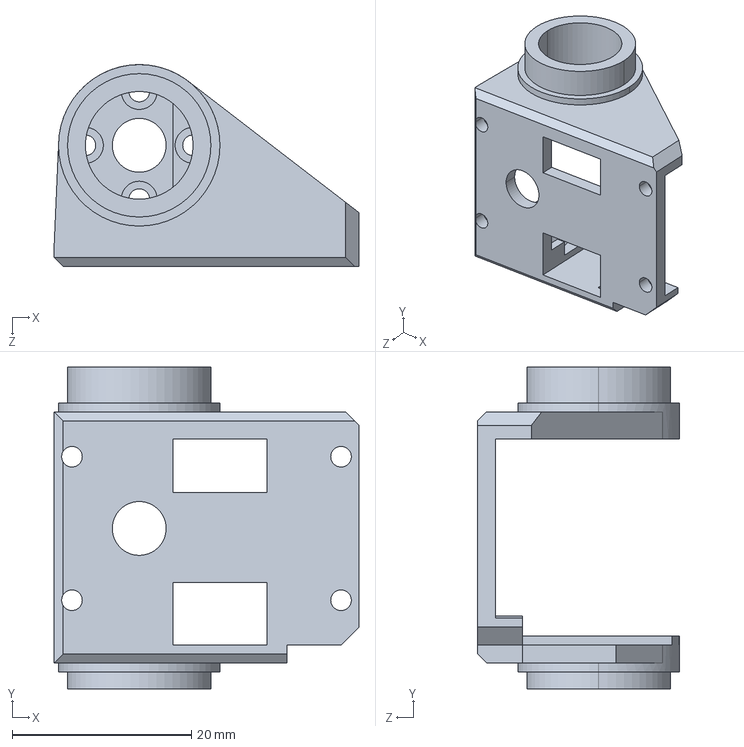
[picture p91: CAD file, 2026-10-20]
microduck_scs225/leg_cad/ft_changed_parts/STEP-changed-parts-FT 2026-09-30/99-yaw_roll_motion_偏航横滚运动-F.STEP
34.0 x 35.9 x 22.5 mm
