mengwei666/my_microduck/microduck_scs225/scs225_cad/SCS225_mount_template.step

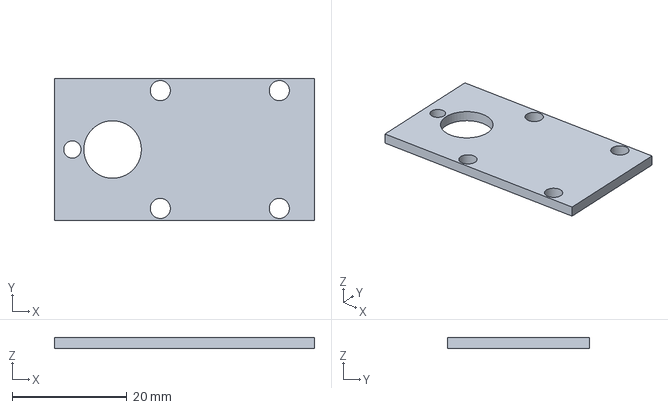
[picture p92: CAD file, 2026-10-20]
microduck_scs225/scs225_cad/SCS225_mount_template.step
45.2 x 24.7 x 2.00 mm
