mengwei666/my_microduck/microduck_scs225/scs225_left_ankle/leg_lower_SCS225_cut.step

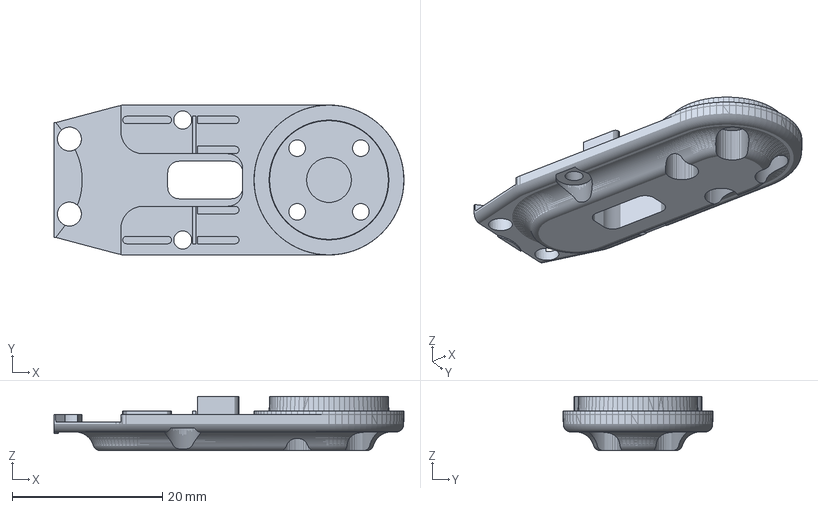
[picture p93: CAD file, 2026-10-21]
microduck_scs225/scs225_left_ankle/leg_lower_SCS225_cut.step
46.7 x 20.0 x 7.25 mm
