mengwei666/my_microduck/microduck_scs225/scs225_left_ankle_v2/SCS225_fit_reference.step

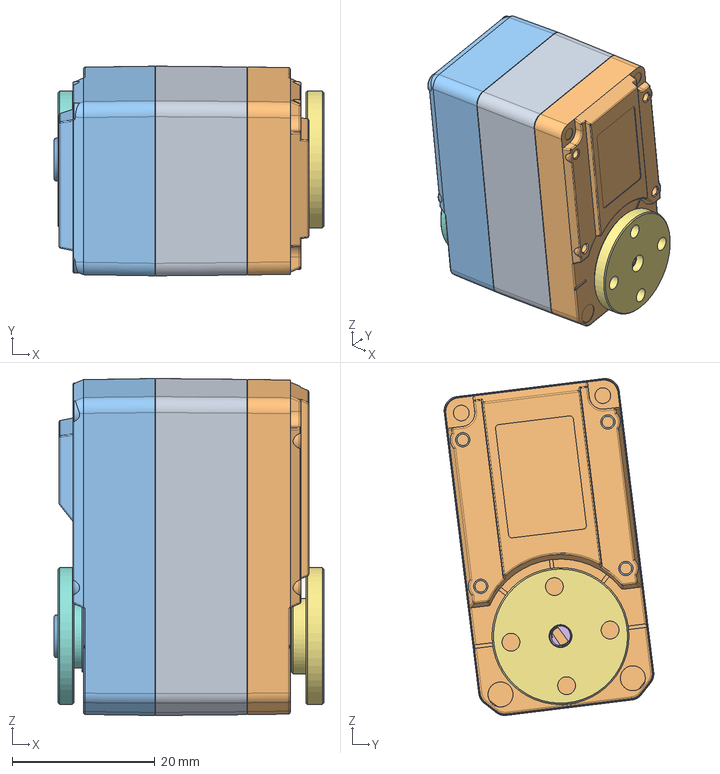
[picture p94: CAD file, 2026-10-21]
microduck_scs225/scs225_left_ankle_v2/SCS225_fit_reference.step
37.8 x 29.4 x 47.3 mm
