mengwei666/my_microduck/microduck_scs225/scs225_left_knee/reference_raw_clearance_cut.step

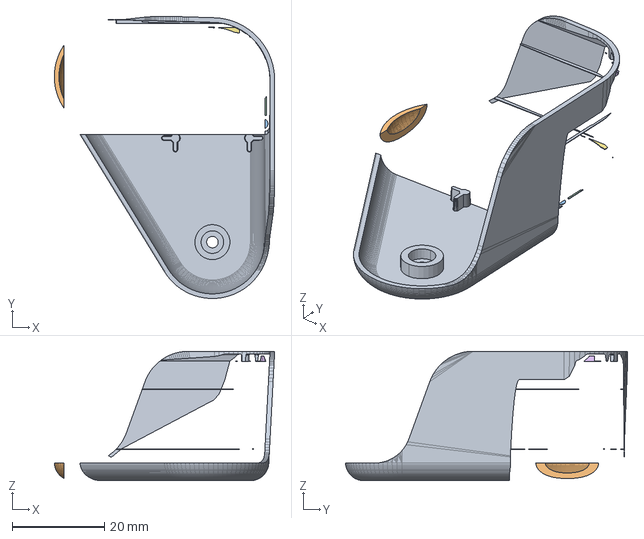
[picture p95: CAD file, 2026-10-21]
microduck_scs225/scs225_left_knee/reference_raw_clearance_cut.step
47.7 x 61.0 x 28.0 mm
