mengwei666/my_microduck/microduck_rl/src/mjlab_microduck/robot/microduck/assets/bottom_head_shell.stl

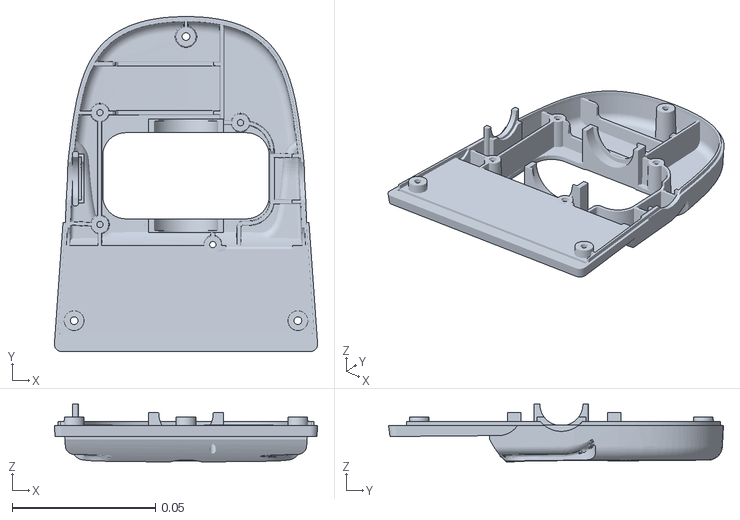
[picture p97: CAD file, 2026-09-17]
microduck_rl/src/mjlab_microduck/robot/microduck/assets/bottom_head_shell.stl
0.0918 x 0.117 x 0.0201
