mengwei666/my_microduck/microduck_scs225/scs225_cad/SCS215_ST3215_2D.dxf

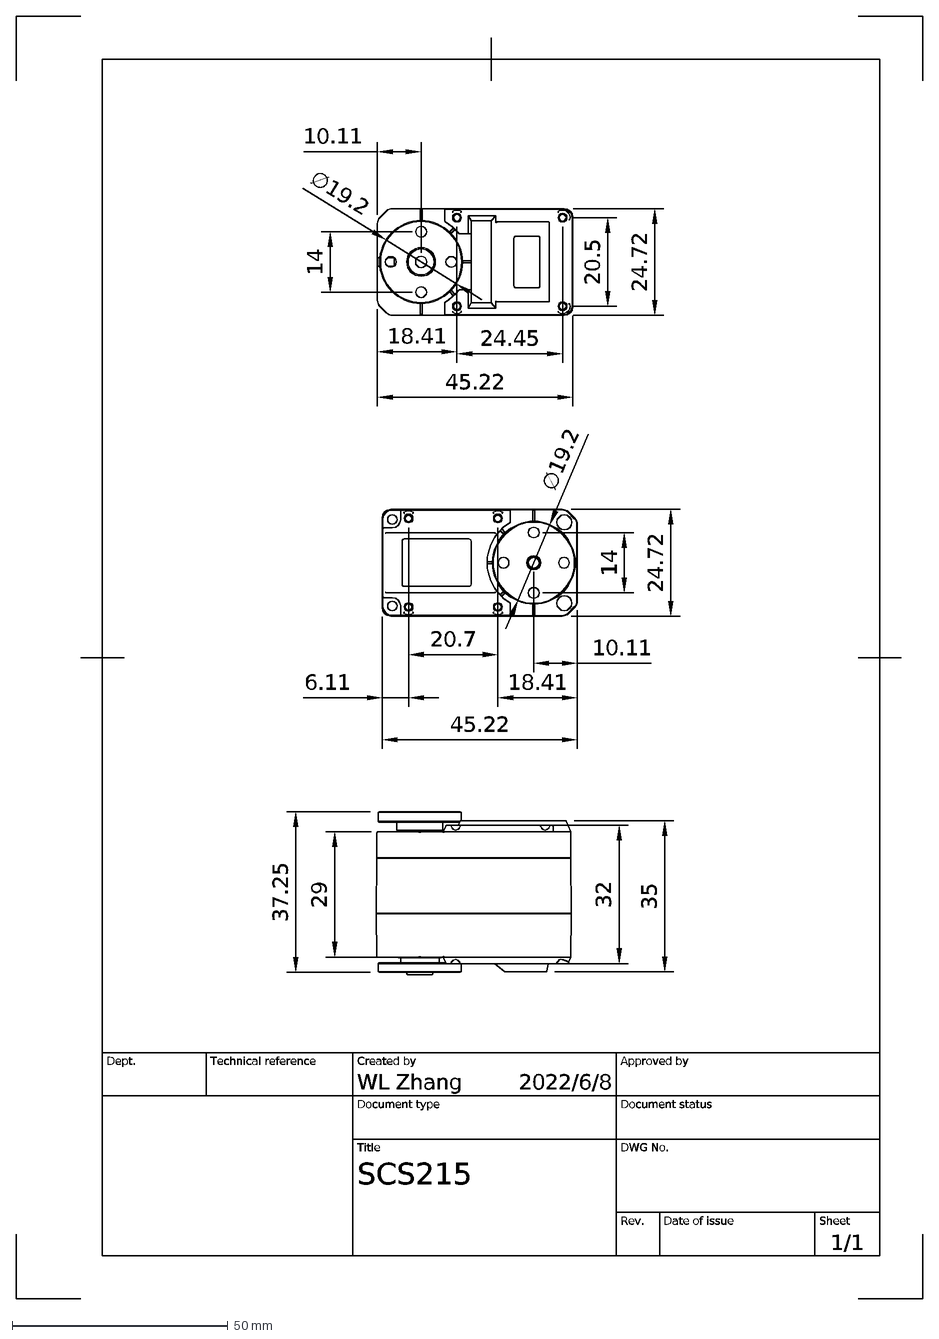
[picture p98: CAD file, 2026-10-20]
microduck_scs225/scs225_cad/SCS215_ST3215_2D.dxf
2022/6/8
1/1
SCS215
WL Zhang
Dept.
Technical reference
Created by
Approved by
Document type
Document status
Title
DWG No.
Rev.
Date of issue
Sheet
24.45
18.41
10.11
20.5
24.72
45.22
37.25
20.7
6.11
∅19.2
14
32
35
29
