mengwei666/my_microduck/microduck_scs225/scs225_left_ankle/ankle_left_SCS225.step

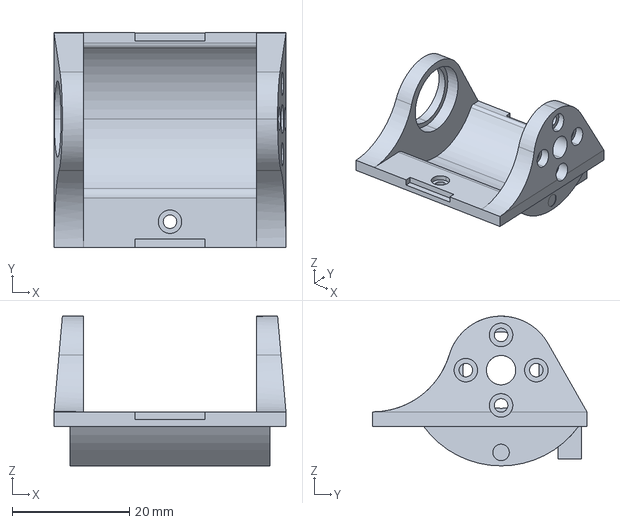
[picture p99: CAD file, 2026-10-21]
microduck_scs225/scs225_left_ankle/ankle_left_SCS225.step
39.5 x 36.5 x 25.5 mm
