mengwei666/my_microduck/microduck_scs225/scs225_left_knee/left_upper_leg_knee_SCS225.step

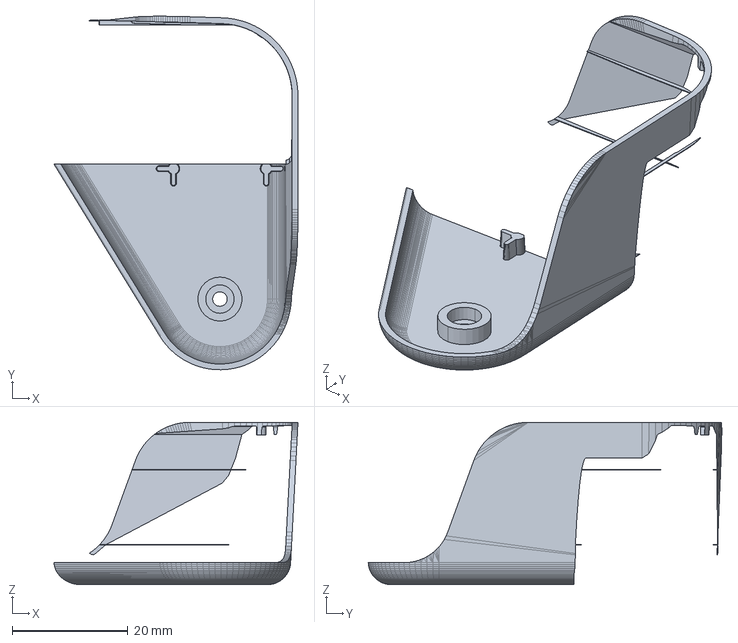
[picture p100: CAD file, 2026-10-21]
microduck_scs225/scs225_left_knee/left_upper_leg_knee_SCS225.step
42.1 x 61.0 x 28.0 mm
