mengwei666/my_microduck/microduck_rl/src/mjlab_microduck/robot/microduck/assets/ankle_l_v1.stl

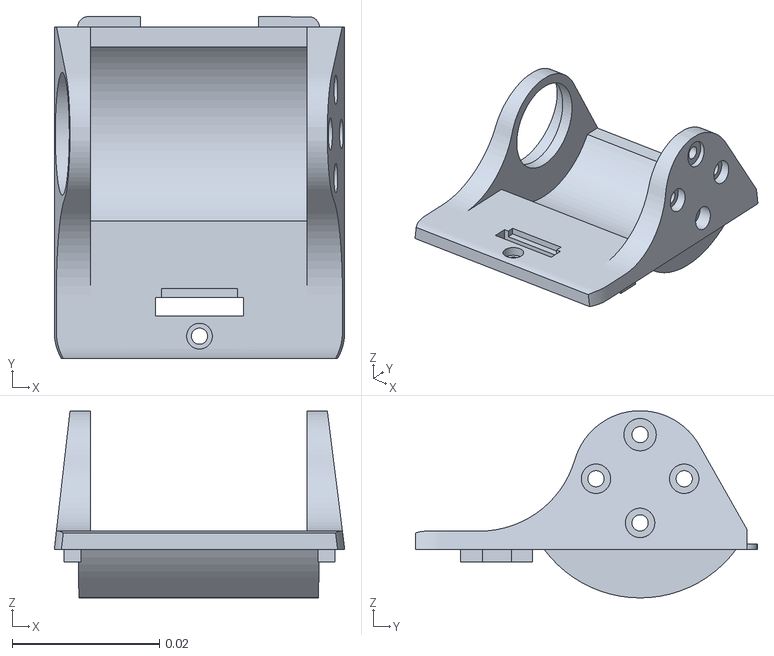
[picture p101: CAD file, 2026-09-17]
microduck_rl/src/mjlab_microduck/robot/microduck/assets/ankle_l_v1.stl
0.0395 x 0.0465 x 0.0254
