mengwei666/my_microduck/microduck_rl/src/mjlab_microduck/robot/xl330_test_bench/assets/spacer.stl

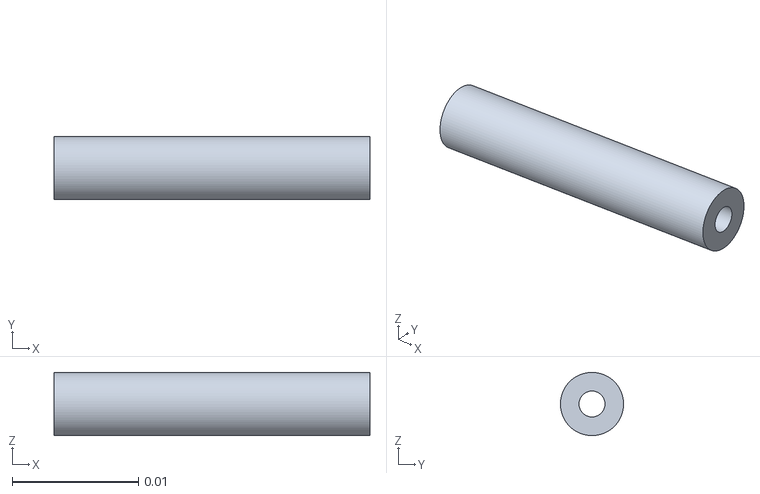
[picture p102: CAD file, 2026-09-17]
microduck_rl/src/mjlab_microduck/robot/xl330_test_bench/assets/spacer.stl
0.025 x 0.005 x 0.005
