mengwei666/my_microduck/microduck_scs225/ascll/04_左大腿/left_upper_leg_左上腿-FT.STEP

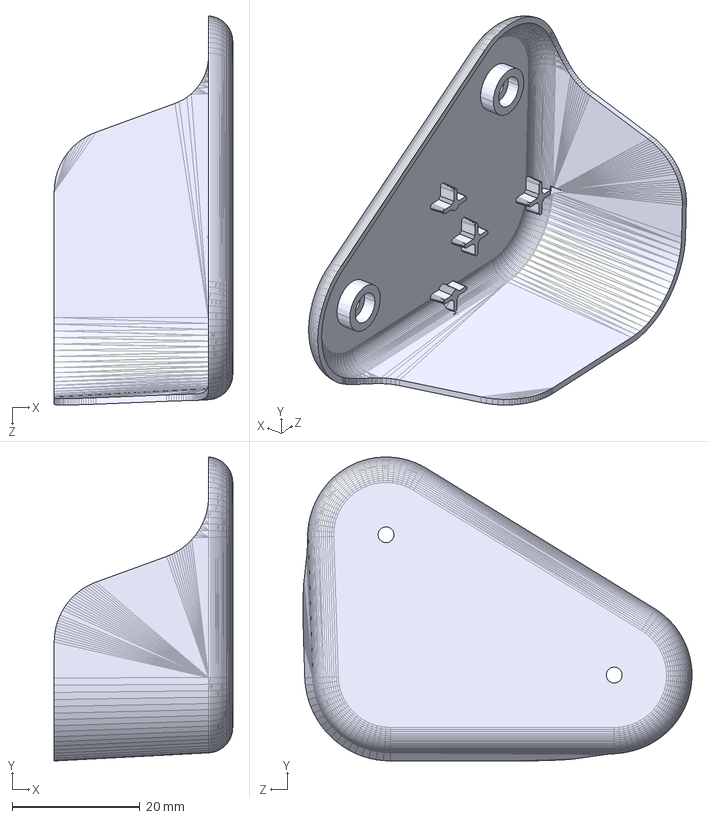
[picture p103: CAD file, 2026-10-20]
microduck_scs225/ascll/04_左大腿/left_upper_leg_左上腿-FT.STEP
28.0 x 47.7 x 61.0 mm
