mengwei666/my_microduck/microduck_scs225/scs225_cad/SCS225_body_only.step

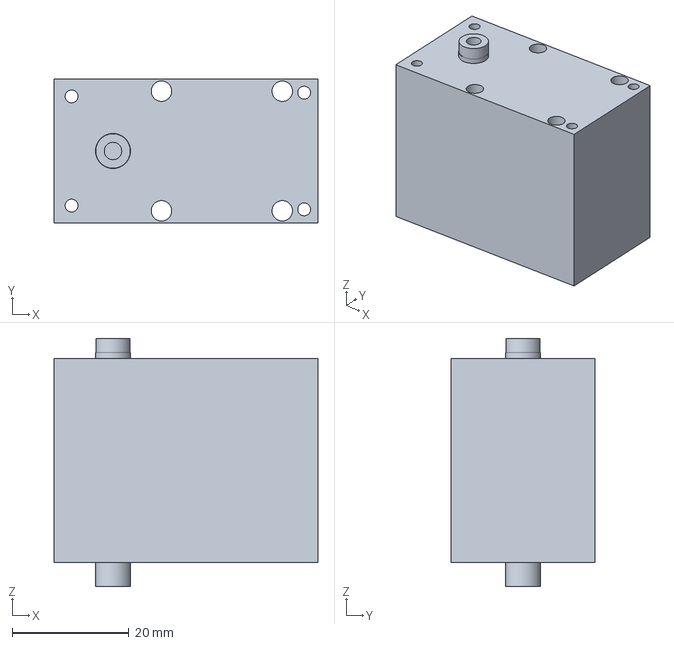
[picture p105: CAD file, 2026-10-20]
microduck_scs225/scs225_cad/SCS225_body_only.step
45.2 x 24.7 x 42.5 mm
