mengwei666/my_microduck/microduck_scs225/scs225_left_ankle/SCS225_ankle_link.step

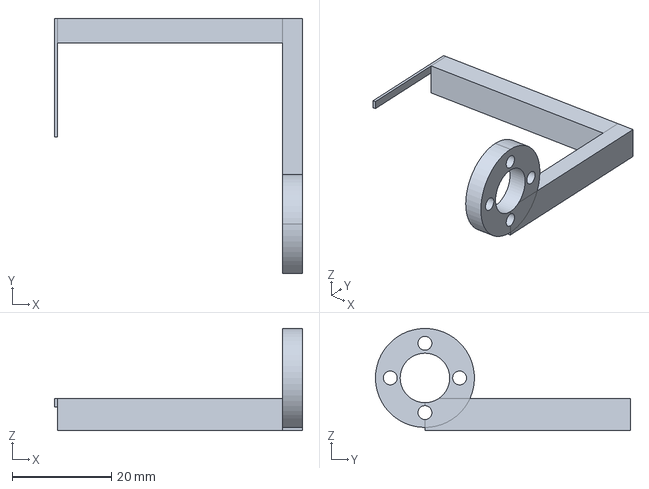
[picture p106: CAD file, 2026-10-21]
microduck_scs225/scs225_left_ankle/SCS225_ankle_link.step
50.1 x 51.5 x 20.6 mm
