mengwei666/my_microduck/microduck-replica-cad-master/SolidWorks-XL330-v1.1/np_f970_NPF970电池.SLDPRT

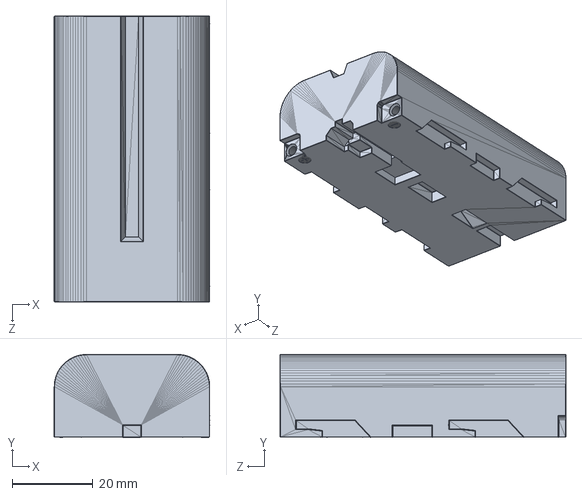
[picture p107: CAD file, 2026-10-21]
microduck-replica-cad-master/SolidWorks-XL330-v1.1/np_f970_NPF970电池.SLDPRT
38.6 x 20.6 x 70.8 mm
