mengwei666/my_microduck/microduck_rl/src/mjlab_microduck/robot/microduck/assets/ankle_right.stl

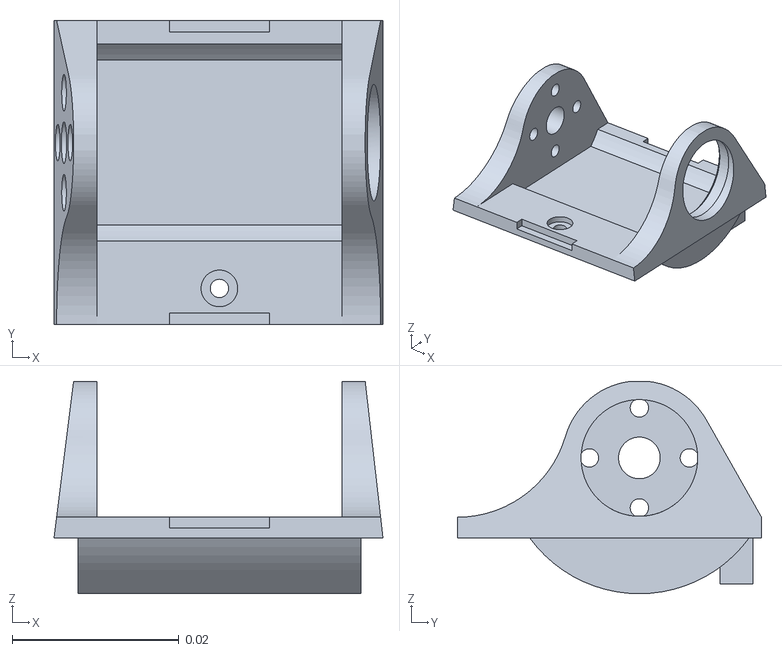
[picture p108: CAD file, 2026-09-17]
microduck_rl/src/mjlab_microduck/robot/microduck/assets/ankle_right.stl
0.0395 x 0.0365 x 0.0255
