mengwei666/my_microduck/microduck_rl/src/mjlab_microduck/robot/xl330_test_bench/assets/part_3.stl

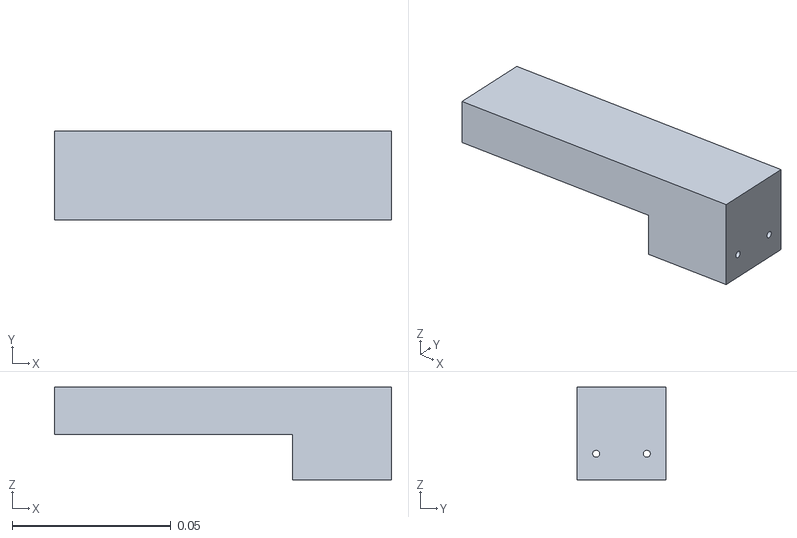
[picture p109: CAD file, 2026-09-17]
microduck_rl/src/mjlab_microduck/robot/xl330_test_bench/assets/part_3.stl
0.106 x 0.0282 x 0.0292
