mengwei666/my_microduck/microduck_scs225/leg_cad/ft_changed_parts/STEP-changed-parts-FT 2026-09-30/合体轮胎.STEP

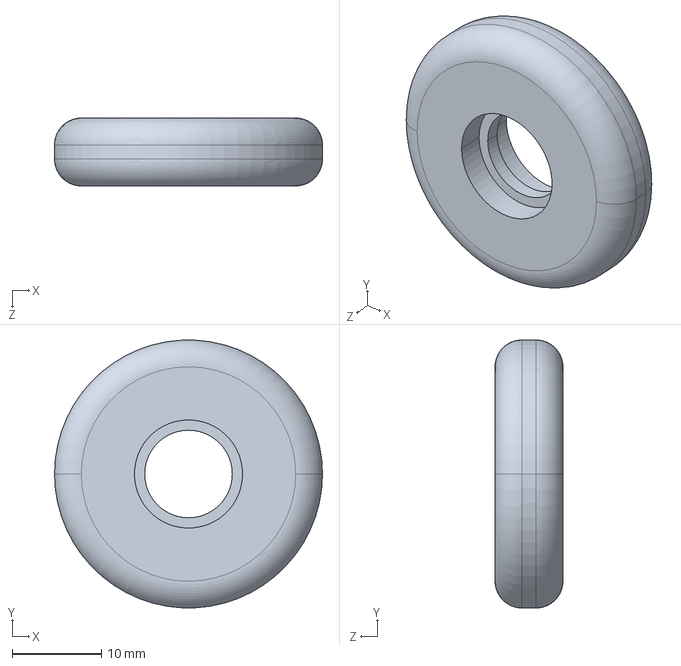
[picture p110: CAD file, 2026-10-20]
microduck_scs225/leg_cad/ft_changed_parts/STEP-changed-parts-FT 2026-09-30/合体轮胎.STEP
30.0 x 30.0 x 7.60 mm
