mengwei666/my_microduck/microduck-replica-cad-master/SolidWorks-XL330-v1.1/bearing_roll_轴承滚轮.SLDPRT

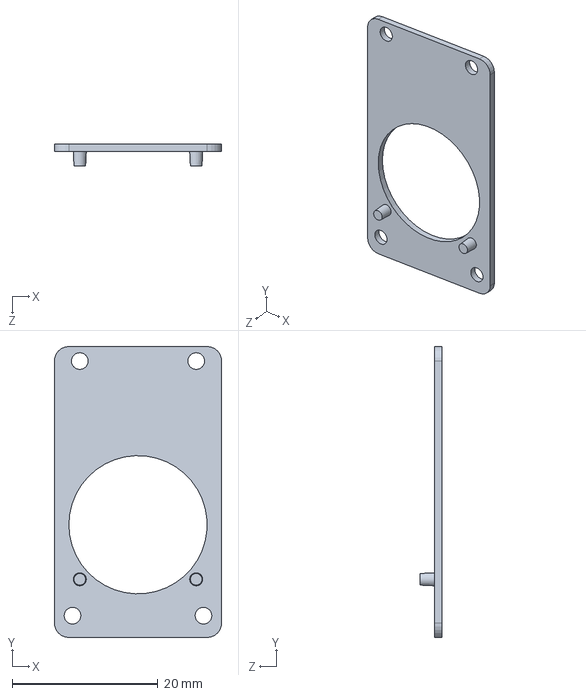
[picture p111: CAD file, 2026-10-21]
microduck-replica-cad-master/SolidWorks-XL330-v1.1/bearing_roll_轴承滚轮.SLDPRT
23.0 x 40.0 x 3.00 mm
