mengwei666/my_microduck/microduck_rl/src/mjlab_microduck/robot/microduck/assets/roller_blade.stl

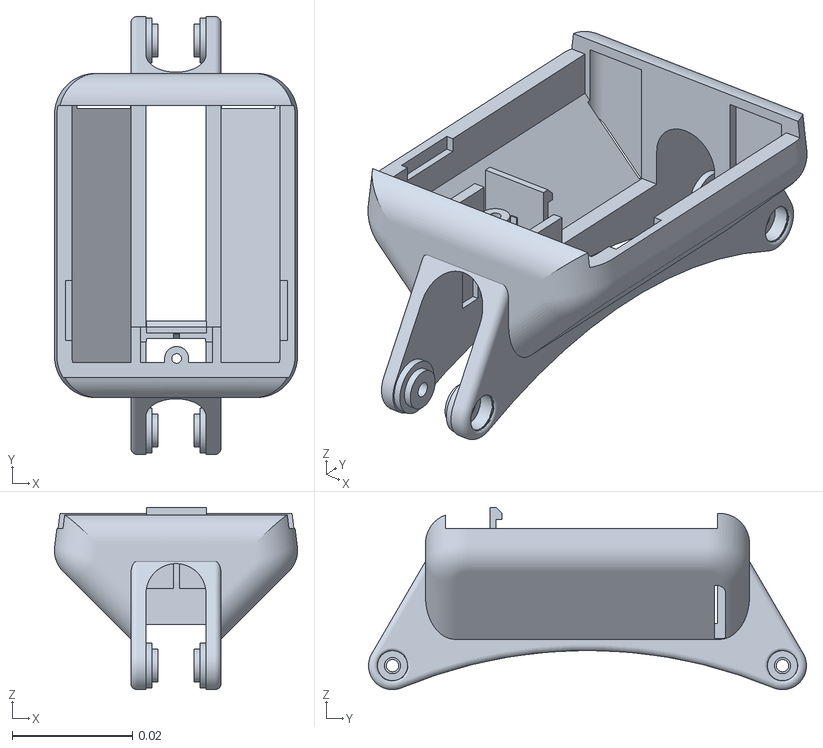
[picture p112: CAD file, 2026-09-17]
microduck_rl/src/mjlab_microduck/robot/microduck/assets/roller_blade.stl
0.0405 x 0.073 x 0.0304
