mengwei666/my_microduck/microduck_scs225/leg_cad/ft_changed_parts/STEP-changed-parts-FT 2026-09-30/ankle_right脚踝右1-FT.STEP

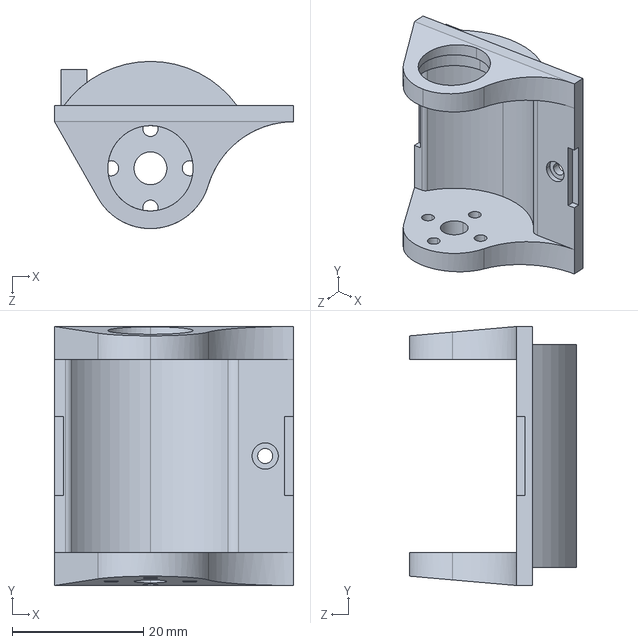
[picture p114: CAD file, 2026-10-20]
microduck_scs225/leg_cad/ft_changed_parts/STEP-changed-parts-FT 2026-09-30/ankle_right脚踝右1-FT.STEP
36.5 x 39.5 x 25.5 mm
