mengwei666/my_microduck/microduck_rl/src/mjlab_microduck/robot/microduck/assets/lens.stl

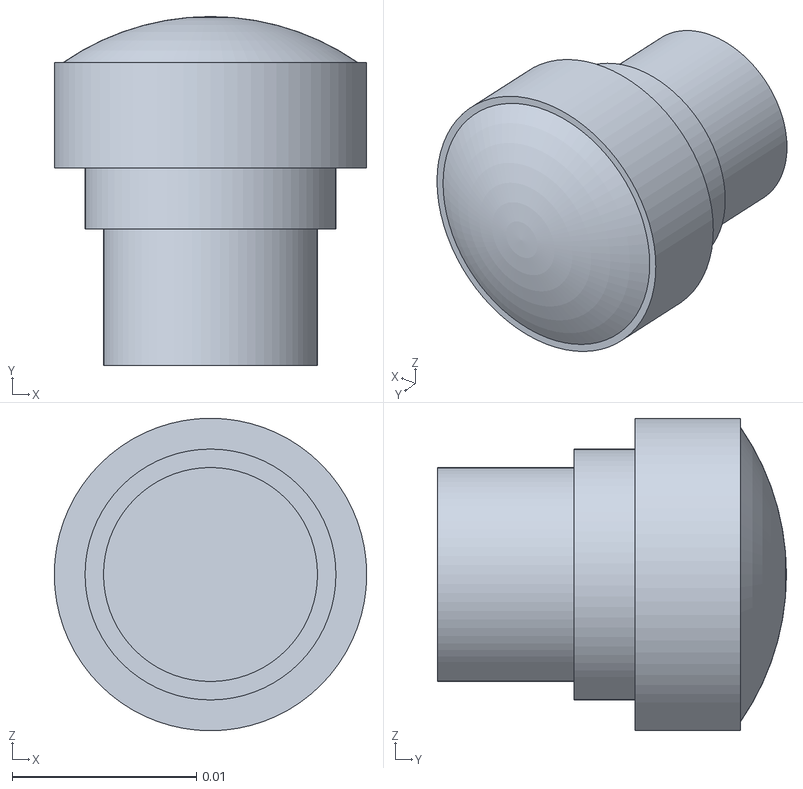
[picture p115: CAD file, 2026-09-17]
microduck_rl/src/mjlab_microduck/robot/microduck/assets/lens.stl
0.0169 x 0.0189 x 0.0169
