mengwei666/my_microduck/microduck-replica-cad-master/SolidWorks-FT2026-09-25/top_head_shell_头部上壳-FT.SLDPRT

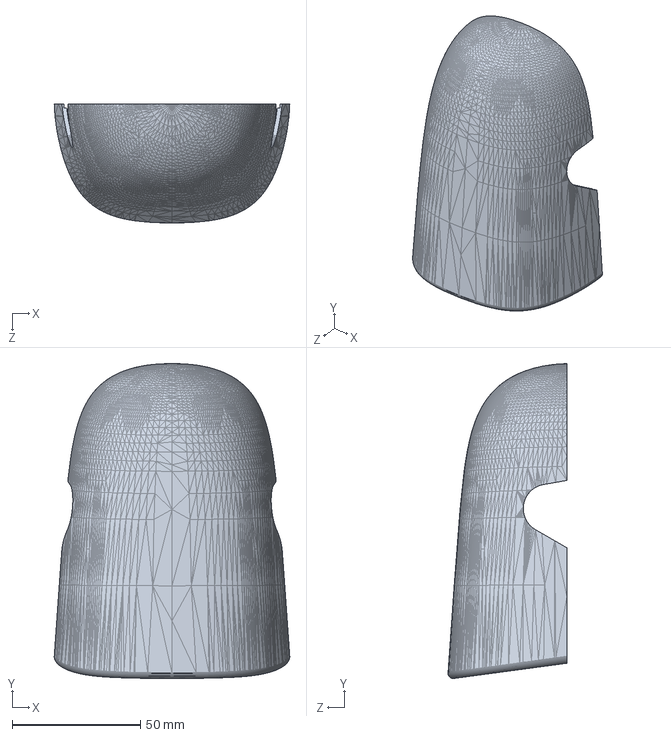
[picture p116: CAD file, 2026-10-21]
microduck-replica-cad-master/SolidWorks-FT2026-09-25/top_head_shell_头部上壳-FT.SLDPRT
91.8 x 122.7 x 46.3 mm
