mengwei666/my_microduck/microduck-replica-cad-master/SolidWorks-XL330-v1.1/01-upper_leg_rigidity_plate_上腿加固板.SLDPRT

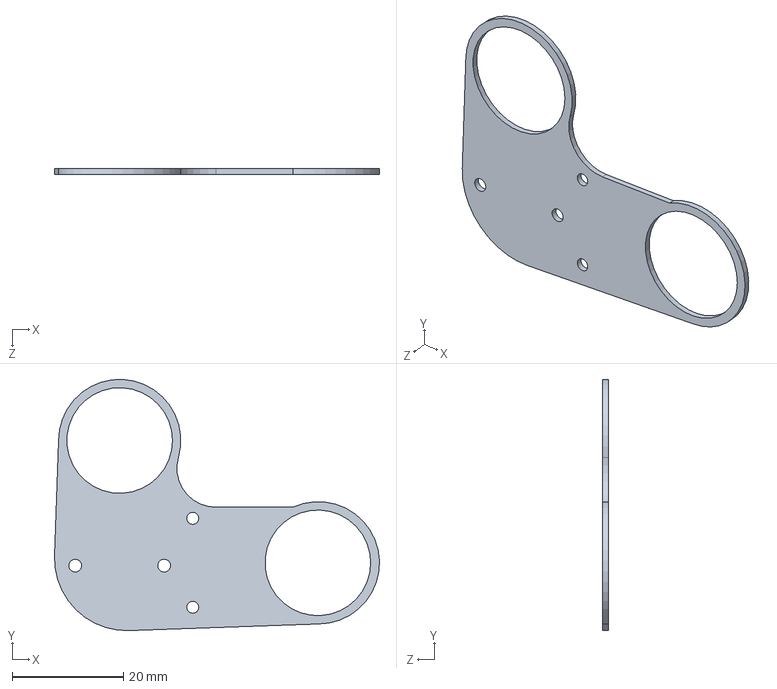
[picture p117: CAD file, 2026-10-21]
microduck-replica-cad-master/SolidWorks-XL330-v1.1/01-upper_leg_rigidity_plate_上腿加固板.SLDPRT
58.5 x 45.2 x 1.00 mm
