mengwei666/my_microduck/microduck_rl/src/mjlab_microduck/robot/microduck/assets/jaw.stl

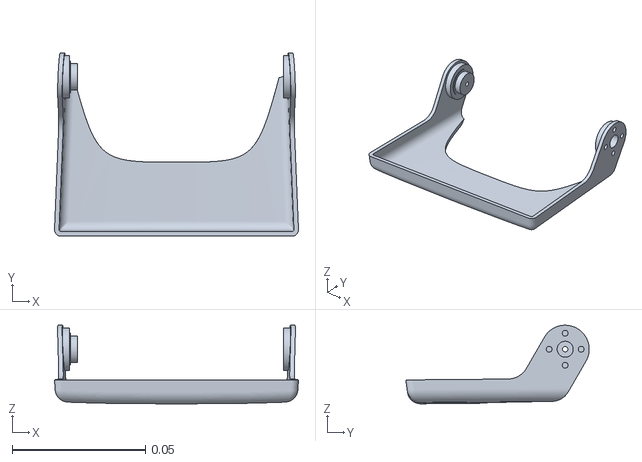
[picture p118: CAD file, 2026-09-17]
microduck_rl/src/mjlab_microduck/robot/microduck/assets/jaw.stl
0.0914 x 0.0687 x 0.0294
