mengwei666/my_microduck/microduck-replica-cad-master/SolidWorks-FT2026-09-25/face_part_面部零件-FT.SLDPRT

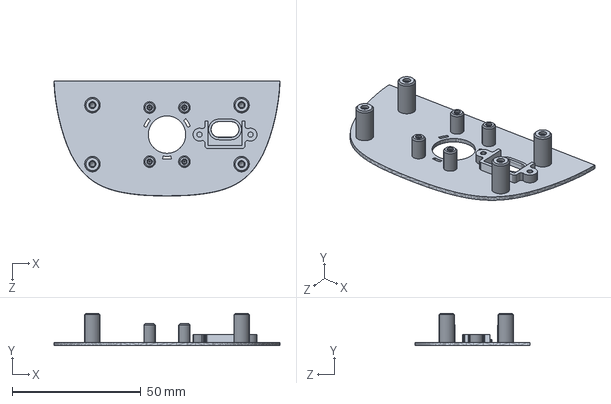
[picture p119: CAD file, 2026-10-21]
microduck-replica-cad-master/SolidWorks-FT2026-09-25/face_part_面部零件-FT.SLDPRT
87.7 x 12.5 x 44.6 mm
