mengwei666/my_microduck/microduck_rl/src/mjlab_microduck/robot/microduck/assets/foot_left.stl

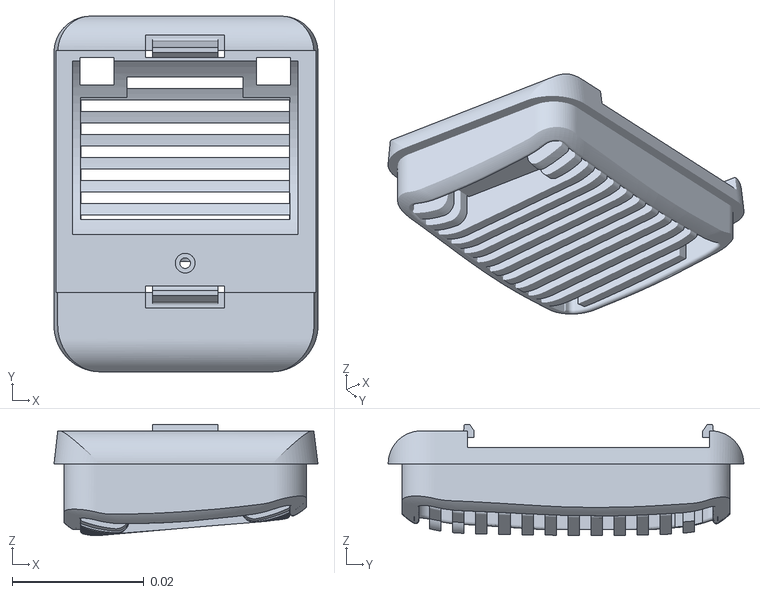
[picture p120: CAD file, 2026-09-17]
microduck_rl/src/mjlab_microduck/robot/microduck/assets/foot_left.stl
0.0401 x 0.054 x 0.0169
