mengwei666/my_microduck/microduck_scs225/leg_cad/ft_changed_parts/STEP-changed-parts-FT 2026-09-30/face_part_面部零件-FT1适配瑞莎原版摄像头 改了孔距.STEP

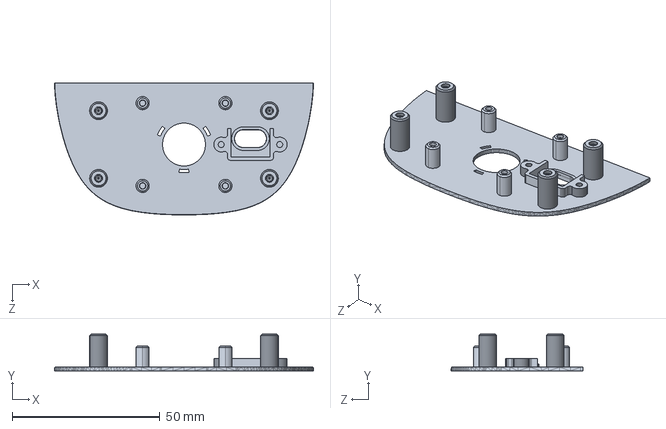
[picture p121: CAD file, 2026-10-20]
microduck_scs225/leg_cad/ft_changed_parts/STEP-changed-parts-FT 2026-09-30/face_part_面部零件-FT1适配瑞莎原版摄像头 改了孔距.STEP
87.7 x 12.5 x 44.6 mm
