mengwei666/my_microduck/microduck_rl/src/mjlab_microduck/robot/microduck/assets/sole_left.stl

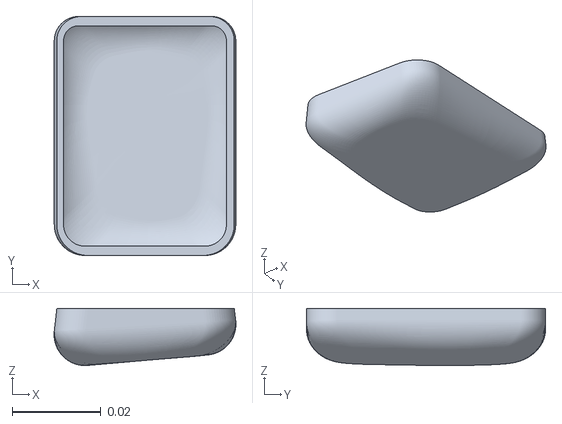
[picture p122: CAD file, 2026-09-17]
microduck_rl/src/mjlab_microduck/robot/microduck/assets/sole_left.stl
0.0411 x 0.054 x 0.0129
