mengwei666/my_microduck/microduck-replica-cad-master/SolidWorks-FT2026-09-25/jaw_下巴-FT.SLDPRT

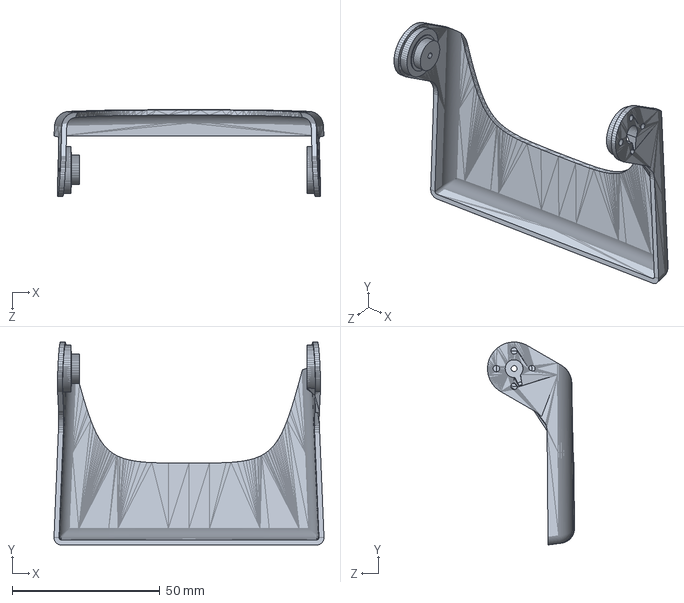
[picture p123: CAD file, 2026-10-21]
microduck-replica-cad-master/SolidWorks-FT2026-09-25/jaw_下巴-FT.SLDPRT
91.4 x 68.7 x 29.4 mm
