mengwei666/my_microduck/microduck-replica-cad-master/SolidWorks-XL330-v1.1/ankle_right脚踝右.SLDPRT

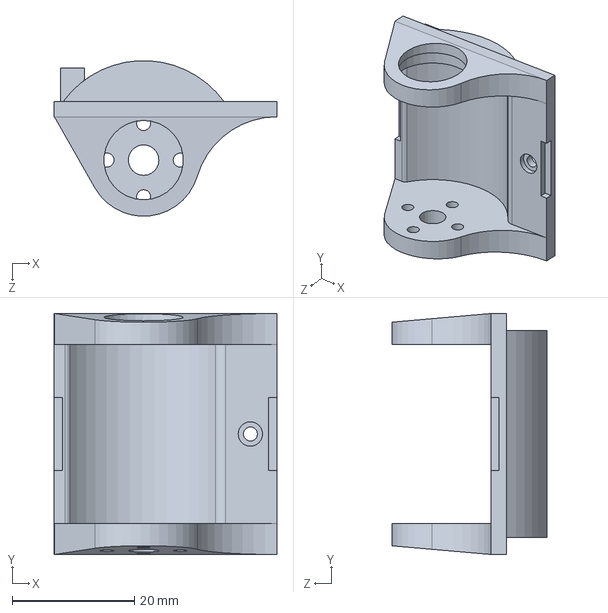
[picture p124: CAD file, 2026-10-21]
microduck-replica-cad-master/SolidWorks-XL330-v1.1/ankle_right脚踝右.SLDPRT
36.5 x 39.5 x 25.5 mm
