mengwei666/my_microduck/microduck_rl/src/mjlab_microduck/robot/microduck/assets/upper_leg_rigidity_plate.stl

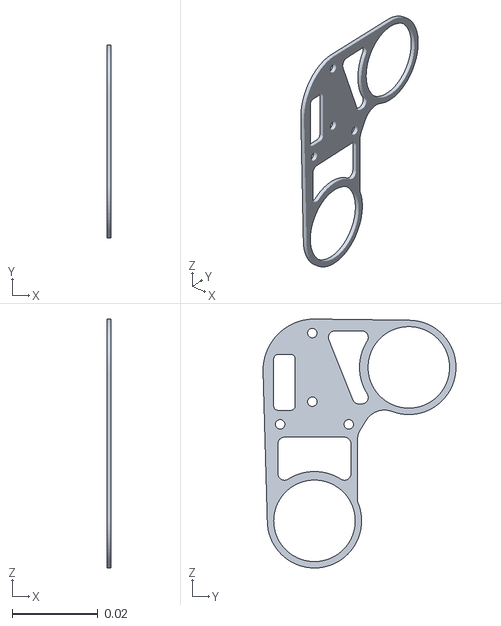
[picture p125: CAD file, 2026-09-17]
microduck_rl/src/mjlab_microduck/robot/microduck/assets/upper_leg_rigidity_plate.stl
0.001 x 0.045 x 0.0581
