mengwei666/my_microduck/microduck-replica-cad-master/SolidWorks-XL330-v1.1/xl330-m288-t1.SLDPRT

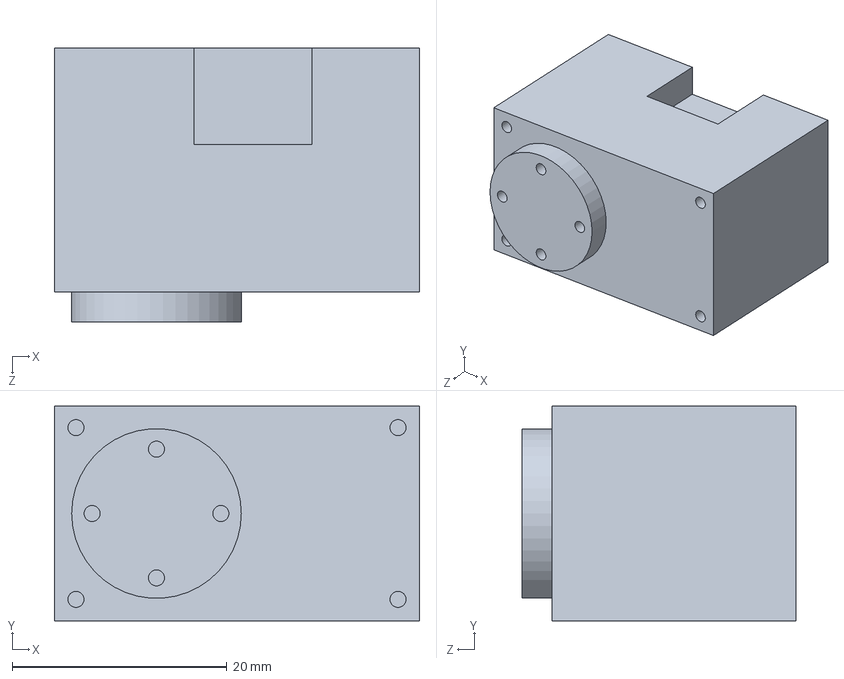
[picture p126: CAD file, 2026-10-21]
microduck-replica-cad-master/SolidWorks-XL330-v1.1/xl330-m288-t1.SLDPRT
34.0 x 20.0 x 25.5 mm
