mengwei666/my_microduck/microduck-replica-cad-master/SolidWorks-FT2026-09-25/jaw_soft_软下巴-FT.SLDPRT

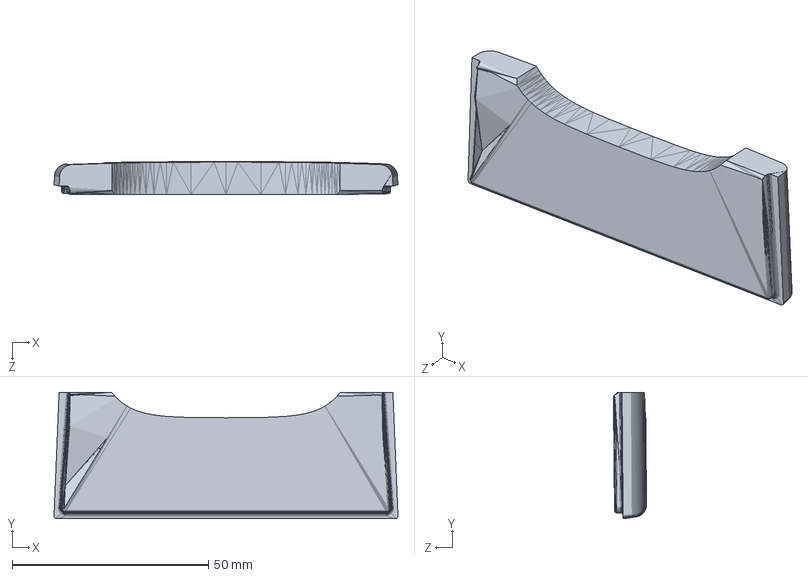
[picture p128: CAD file, 2026-10-21]
microduck-replica-cad-master/SolidWorks-FT2026-09-25/jaw_soft_软下巴-FT.SLDPRT
87.7 x 32.2 x 8.44 mm
