mengwei666/my_microduck/microduck-replica-cad-master/SolidWorks-XL330-v1.1/deep groove ball bearings gb.sldprt

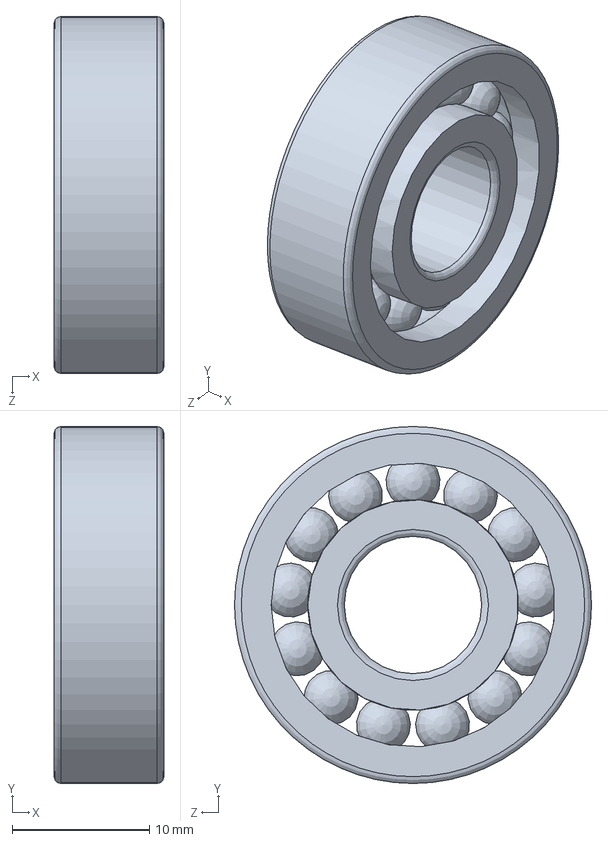
[picture p129: CAD file, 2026-10-21]
microduck-replica-cad-master/SolidWorks-XL330-v1.1/deep groove ball bearings gb.sldprt
8.00 x 26.0 x 26.0 mm
