mengwei666/my_microduck/microduck_rl/src/mjlab_microduck/robot/microduck/assets/yaw2roll.stl

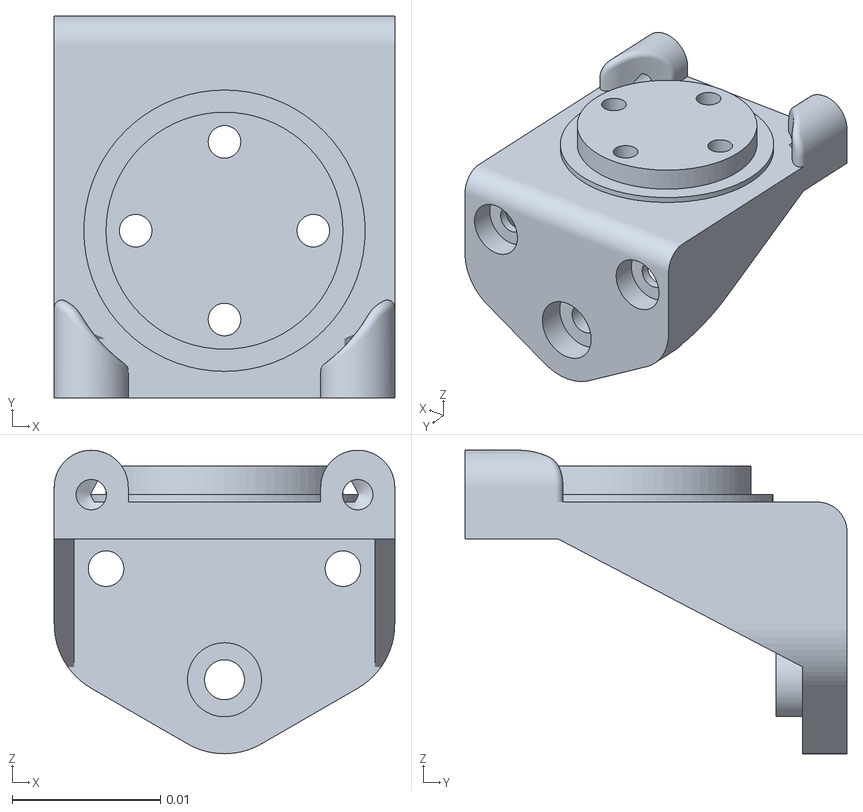
[picture p130: CAD file, 2026-09-17]
microduck_rl/src/mjlab_microduck/robot/microduck/assets/yaw2roll.stl
0.023 x 0.0258 x 0.0205
