mengwei666/my_microduck/microduck-replica-cad-master/SolidWorks-XL330-v1.1/trunk_base_躯干底座.SLDPRT

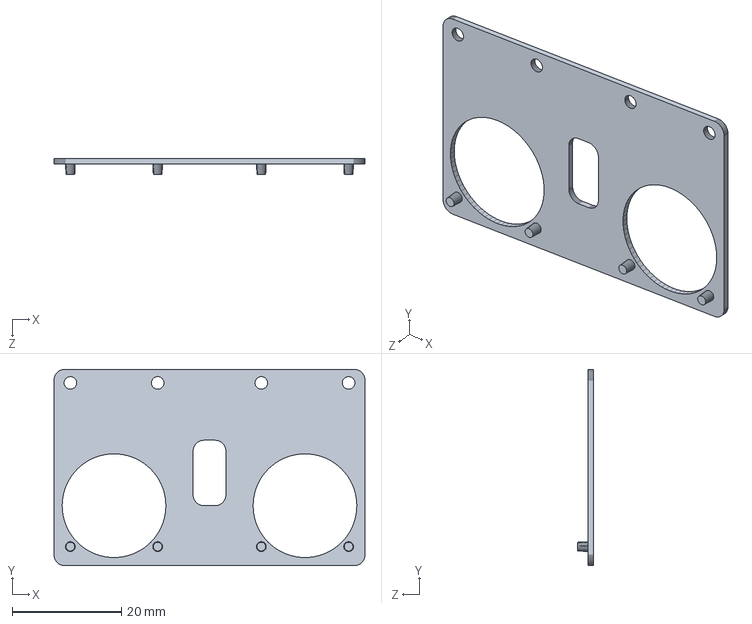
[picture p131: CAD file, 2026-10-21]
microduck-replica-cad-master/SolidWorks-XL330-v1.1/trunk_base_躯干底座.SLDPRT
57.0 x 36.0 x 3.00 mm
