mengwei666/my_microduck/microduck_rl/src/mjlab_microduck/robot/microduck/assets/leg.stl

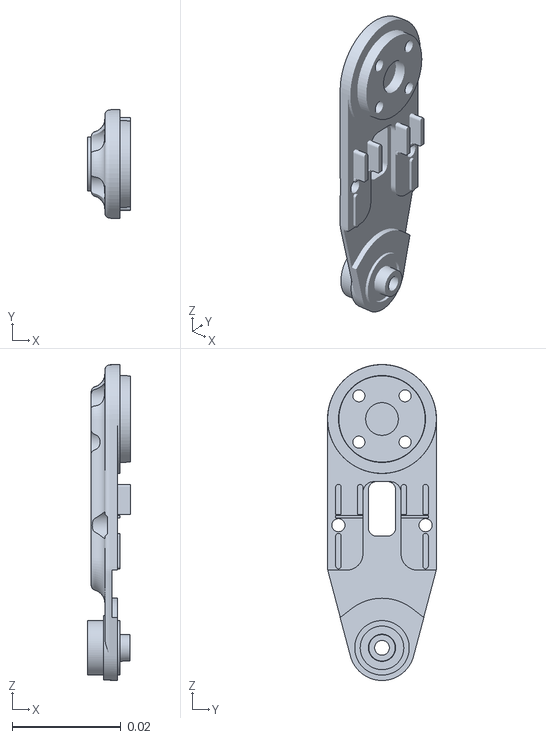
[picture p132: CAD file, 2026-09-17]
microduck_rl/src/mjlab_microduck/robot/microduck/assets/leg.stl
0.00795 x 0.02 x 0.058
