mengwei666/my_microduck/microduck-replica-cad-master/SolidWorks-FT2026-09-25/08_颈俯仰-FT.SLDASM

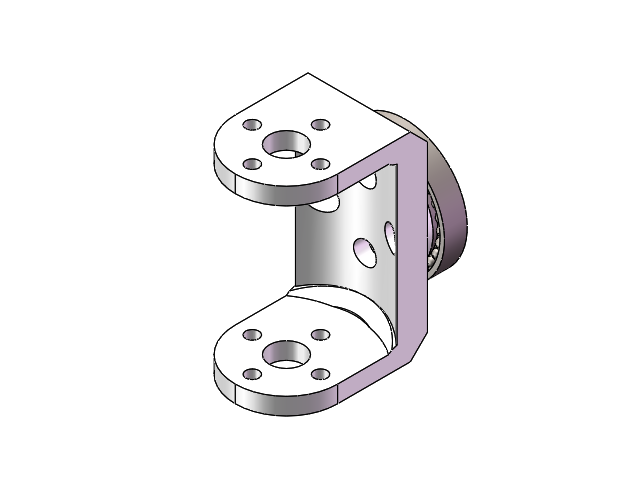
[picture p133: CAD file, 2026-10-21]
microduck-replica-cad-master/SolidWorks-FT2026-09-25/08_颈俯仰-FT.SLDASM
neck_pitch_颈部俯仰-FT
轴承16×22×4-FT
