mengwei666/my_microduck/microduck-replica-cad-master/SolidWorks-FT2026-09-25/12_右髋roll-FT.SLDASM

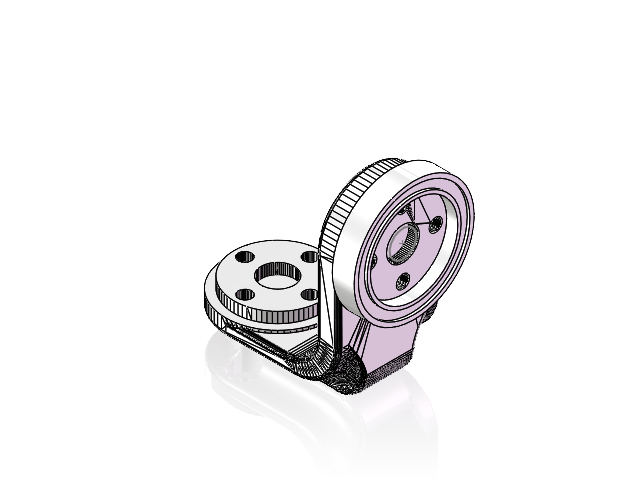
[picture p134: CAD file, 2026-10-21]
microduck-replica-cad-master/SolidWorks-FT2026-09-25/12_右髋roll-FT.SLDASM
hip_l_髋部左-FT
轴承16×22×4-FT
