mengwei666/my_microduck/(list of files, cad)

Other CAD files:
microduck_scs225/scs225_left_ankle/left_ankle_SCS225_full_check.step
microduck-replica-cad-master/SolidWorks-XL330-v1.1/15_右踝脚.SLDASM
microduck-replica-cad-master/SolidWorks-FT2026-09-25/00-microduck装配体-FT2026.9.23.SLDASM
microduck-replica-cad-master/SolidWorks-XL330-v1.1/12_右髋roll.SLDASM
microduck-replica-cad-master/SolidWorks-XL330-v1.1/04_左大腿.SLDASM
microduck-replica-cad-master/SolidWorks-XL330-v1.1/00-microduck装配体 XL330-288舵机版本.SLDASM
microduck-replica-cad-master/SolidWorks-XL330-v1.1/01_躯干主体.SLDASM
microduck-replica-cad-master/SolidWorks-XL330-v1.1/11_右髋yaw-roll.SLDASM
microduck-replica-cad-master/SolidWorks-XL330-v1.1/10_头部总成.SLDASM
microduck-replica-cad-master/SolidWorks-FT2026-09-25/11_右髋yaw-roll-FT.SLDASM
microduck-replica-cad-master/SolidWorks-XL330-v1.1/02_左髋yaw-roll.SLDASM
microduck-replica-cad-master/SolidWorks-XL330-v1.1/07_颈根.SLDASM
microduck_scs225/ascll/06_左踝脚/06_左踝脚-FT.STEP
microduck_scs225/ascll/3D_PCB_2026-10-21 (1).step
microduck_scs225/ascll/02_左髋yaw-roll/HD-1910-c001-dan.STEP
microduck_scs225/ascll/04_左大腿/HD-1910-c001-dan.STEP
microduck_scs225/ascll/06_左踝脚/deep groove ball bearings gb_Rolling bearings 61700 GB 276-94.STEP
microduck_scs225/leg_cad/ft_changed_parts/STEP-changed-parts-FT 2026-09-30/yaw2roll_偏航转横滚-FT.STEP
microduck_scs225/ascll/02_左髋yaw-roll/轴承16×22×4-FT.STEP
microduck_scs225/ascll/03_左髋roll/03_左髋roll-FT.STEP
microduck_scs225/ascll/04_左大腿/04_左大腿-FT.STEP
microduck_scs225/ascll/05_左小腿/05_左小腿-FT.STEP
microduck_scs225/leg_cad/leg_FT.step
microduck-replica-cad-master/SolidWorks-FT2026-09-25/yaw2roll_偏航转横滚-FT.SLDPRT
microduck_scs225/ascll/02_左髋yaw-roll/02_左髋yaw-roll-FT.STEP
microduck_scs225/ascll/04_左大腿/轴承16×22×4-FT.STEP
microduck_scs225/ascll/06_左踝脚/foot_left_左脚-FT.STEP
microduck_scs225/leg_cad/ft_changed_parts/STEP-changed-parts-FT 2026-09-30/01-upper_leg_rigidity_plate_上腿加固板-FT.STEP
microduck_scs225/leg_cad/microduck_lower_leg.step
microduck_scs225/scs225_left_ankle_v2/foot_left_SCS225.step
microduck_scs225/ascll/02_左髋yaw-roll/bearing_roll_轴承滚轮-FT.STEP
microduck_scs225/ascll/06_左踝脚/sole_left_左脚底-FT.STEP
microduck_scs225/leg_cad/ft_changed_parts/STEP-changed-parts-FT 2026-09-30/leg_腿部-FT.STEP
microduck_scs225/leg_cad/microduck_yaw2roll.step
microduck-replica-cad-master/SolidWorks-FT2026-09-25/bearing_roll_轴承滚轮-FT.SLDPRT
microduck_rl/src/mjlab_microduck/robot/microduck/assets/ankle_r_v1.stl
microduck_scs225/leg_cad/rigidity_plate_FT.step
microduck_scs225/leg_cad/ankle_left_FT.step
microduck-replica-cad-master/SolidWorks-FT2026-09-25/01-upper_leg_rigidity_plate_上腿加固板-FT.SLDPRT
microduck_scs225/leg_cad/ft_changed_parts/STEP-changed-parts-FT 2026-09-30/ankle_left_脚踝左-FT.STEP
microduck_scs225/leg_cad/ft_changed_parts/STEP-changed-parts-FT 2026-09-30/right_upper_leg_右上腿-FT.STEP
microduck-replica-cad-master/SolidWorks-XL330-v1.1/face_part_面部零件.SLDPRT
microduck_scs225/leg_cad/yaw2roll_FT.step
microduck-replica-cad-master/SolidWorks-FT2026-09-25/合体轮胎.SLDPRT
microduck-replica-cad-master/SolidWorks-XL330-v1.1/sole_left_左脚底.SLDPRT
microduck-replica-cad-master/SolidWorks-FT2026-09-25/hip_l_髋部左-FT.SLDPRT
microduck-replica-cad-master/SolidWorks-FT2026-09-25/3D_PCB1_2026-09-08-FT.SLDPRT
microduck-replica-cad-master/SolidWorks-FT2026-09-25/99-yaw_roll_motion_偏航横滚运动-F.SLDPRT
microduck-replica-cad-master/SolidWorks-FT2026-09-25/HD-1910-c001-dan.SLDPRT
microduck-replica-cad-master/SolidWorks-FT2026-09-25/HD-1910-c001-shuang.SLDPRT
microduck-replica-cad-master/SolidWorks-FT2026-09-25/M2铜柱-FT.SLDPRT
microduck-replica-cad-master/SolidWorks-FT2026-09-25/ankle_l_v1_脚踝左V1.SLDPRT
microduck-replica-cad-master/SolidWorks-FT2026-09-25/ankle_left_脚踝左-FT.SLDPRT
microduck-replica-cad-master/SolidWorks-FT2026-09-25/bottom_head_shell_头部下壳-FT.SLDPRT
microduck-replica-cad-master/SolidWorks-FT2026-09-25/elec_rpi_robot_hat_pcb_树莓派机器人HAT电路板-FT.SLDPRT
microduck-replica-cad-master/SolidWorks-FT2026-09-25/foot_right_右脚-FT.SLDPRT
microduck-replica-cad-master/SolidWorks-FT2026-09-25/left_shell_左壳-FT.SLDPRT
microduck-replica-cad-master/SolidWorks-FT2026-09-25/left_upper_leg_左上腿-FT.SLDPRT
microduck-replica-cad-master/SolidWorks-FT2026-09-25/leg_腿部-FT.SLDPRT
microduck-replica-cad-master/SolidWorks-FT2026-09-25/lens_镜头-FT.SLDPRT
microduck-replica-cad-master/SolidWorks-FT2026-09-25/neck_pitch_颈部俯仰-FT.SLDPRT
microduck-replica-cad-master/SolidWorks-FT2026-09-25/neck_颈部-FT.SLDPRT
microduck-replica-cad-master/SolidWorks-FT2026-09-25/noenoeil_眼睛-FT.SLDPRT
microduck-replica-cad-master/SolidWorks-FT2026-09-25/pcb__raspberry_pi_zero_2_w_树莓派Zero2W电路板-FT.SLDPRT
microduck-replica-cad-master/SolidWorks-FT2026-09-25/power_support_电源支架-FT.SLDPRT
microduck-replica-cad-master/SolidWorks-FT2026-09-25/right_shell_右壳-FT.SLDPRT
microduck-replica-cad-master/SolidWorks-FT2026-09-25/right_upper_leg_右上腿-FT.SLDPRT
microduck-replica-cad-master/SolidWorks-FT2026-09-25/roller_blade_滚轮叶片_mm.SLDPRT
microduck-replica-cad-master/SolidWorks-FT2026-09-25/soft_mouth_top_软嘴顶部-FT.SLDPRT
microduck-replica-cad-master/SolidWorks-FT2026-09-25/sole_left_左脚底-FT.SLDPRT
microduck-replica-cad-master/SolidWorks-FT2026-09-25/trunk_base_躯干底座-FT.SLDPRT
microduck-replica-cad-master/SolidWorks-FT2026-09-25/轴承12×6×3.SLDPRT
microduck-replica-cad-master/SolidWorks-FT2026-09-25/轴承16×22×4-FT.SLDPRT
microduck-replica-cad-master/SolidWorks-XL330-v1.1/3D_PCB1_2026-09-08.SLDPRT
microduck-replica-cad-master/SolidWorks-XL330-v1.1/M2铜柱.SLDPRT
microduck-replica-cad-master/SolidWorks-XL330-v1.1/ankle_left_脚踝左.SLDPRT
microduck-replica-cad-master/SolidWorks-XL330-v1.1/bottom_head_shell_头部下壳.SLDPRT
microduck-replica-cad-master/SolidWorks-XL330-v1.1/elec_rpi_robot_hat_pcb_树莓派机器人HAT电路板.SLDPRT
microduck-replica-cad-master/SolidWorks-XL330-v1.1/foot_right_右脚.SLDPRT
microduck-replica-cad-master/SolidWorks-XL330-v1.1/hip_l_髋部左.SLDPRT
microduck-replica-cad-master/SolidWorks-XL330-v1.1/left_shell_左壳.SLDPRT
microduck-replica-cad-master/SolidWorks-XL330-v1.1/left_upper_leg_左上腿.SLDPRT
microduck-replica-cad-master/SolidWorks-XL330-v1.1/leg_腿部.SLDPRT
microduck-replica-cad-master/SolidWorks-XL330-v1.1/lens_镜头.SLDPRT
microduck-replica-cad-master/SolidWorks-XL330-v1.1/m12_lens_holder_M12镜头座.SLDPRT
microduck-replica-cad-master/SolidWorks-XL330-v1.1/neck_pitch_颈部俯仰.SLDPRT
microduck-replica-cad-master/SolidWorks-XL330-v1.1/neck_颈部.SLDPRT
microduck-replica-cad-master/SolidWorks-XL330-v1.1/noenoeil_眼睛.SLDPRT
microduck-replica-cad-master/SolidWorks-XL330-v1.1/pcb__raspberry_pi_zero_2_w_树莓派Zero2W电路板.SLDPRT
microduck-replica-cad-master/SolidWorks-XL330-v1.1/power_support_电源支架.SLDPRT
microduck-replica-cad-master/SolidWorks-XL330-v1.1/right_shell_右壳.SLDPRT
microduck-replica-cad-master/SolidWorks-XL330-v1.1/right_upper_leg_右上腿.SLDPRT
microduck-replica-cad-master/SolidWorks-XL330-v1.1/soft_mouth_top_软嘴顶部.SLDPRT
microduck-replica-cad-master/SolidWorks-XL330-v1.1/xl330-m288-t2.SLDPRT
microduck-replica-cad-master/SolidWorks-XL330-v1.1/yaw2roll_偏航转横滚.SLDPRT
microduck-replica-cad-master/SolidWorks-XL330-v1.1/yaw_roll_motion_偏航横滚运动.SLDPRT
microduck-replica-cad-master/SolidWorks-XL330-v1.1/舵机xl330-288.SLDPRT
microduck-replica-cad-master/SolidWorks-XL330-v1.1/轴承16×22×4.SLDPRT
microduck_rl/src/mjlab_microduck/robot/microduck/assets/ankle_left.stl
microduck_rl/src/mjlab_microduck/robot/microduck/assets/banana_pcb_locker.stl
microduck_rl/src/mjlab_microduck/robot/microduck/assets/bearing_roll.stl
microduck_rl/src/mjlab_microduck/robot/microduck/assets/elec_rpi_robot_hat_pcb.stl
microduck_rl/src/mjlab_microduck/robot/microduck/assets/face_part.stl
microduck_rl/src/mjlab_microduck/robot/microduck/assets/foot_right.stl
microduck_rl/src/mjlab_microduck/robot/microduck/assets/hip_l.stl
microduck_rl/src/mjlab_microduck/robot/microduck/assets/jaw_soft.stl
microduck_rl/src/mjlab_microduck/robot/microduck/assets/left_shell.stl
microduck_rl/src/mjlab_microduck/robot/microduck/assets/m12_lens_holder.stl
microduck_rl/src/mjlab_microduck/robot/microduck/assets/neck.stl
microduck_rl/src/mjlab_microduck/robot/microduck/assets/neck_pitch.stl
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
