mengwei666/my_microduck/microduck-replica-cad-master/组件图/00-microduck装配体爆炸图1.png

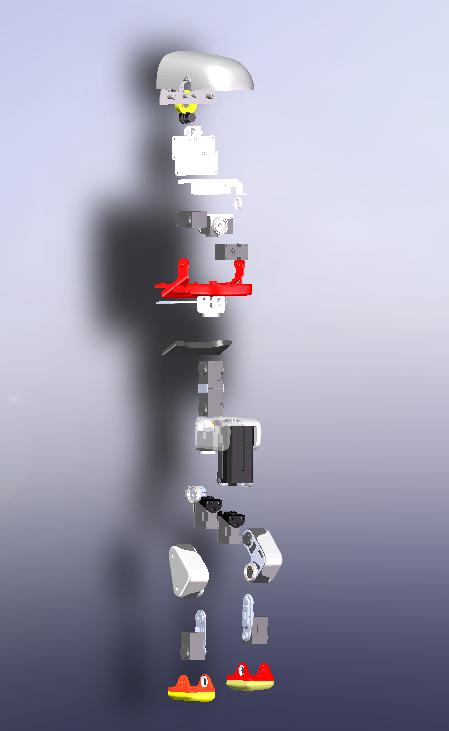
microduck-replica-cad-master/组件图/00-microduck装配体爆炸图1.png
