mengwei666/my_microduck/microduck_scs225/scs225_left_knee/03_check_assembly_iso.png

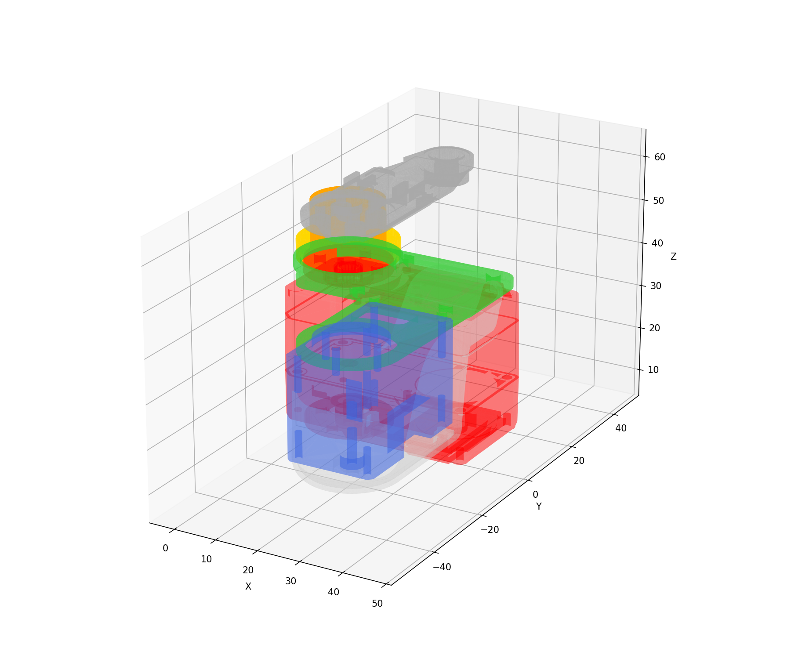
microduck_scs225/scs225_left_knee/03_check_assembly_iso.png
