mengwei666/my_microduck/microduck_scs225/scs225_left_knee/04_check_assembly_knee.png

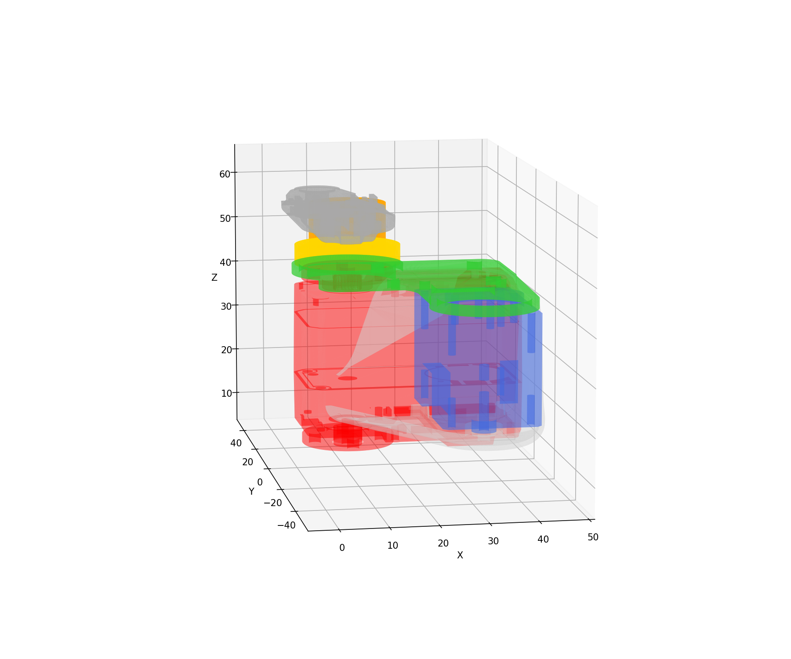
microduck_scs225/scs225_left_knee/04_check_assembly_knee.png
