mengwei666/my_microduck/microduck/robotd/src/main.rs

//! `robotd` — the robot control daemon.
//!
//! The 50 Hz control loop, the `robot.*` socket, and the health the updater gates on
//! (`docs/design/robotd-design.md` §1.4, §3.4).
//!
//! **Health is why the daemon has the shape it does.** The updater's auto-rollback is only
//! meaningful if `robot.health` means something, and it used to mean "the loop ticked once" —
//! so every rollback was tested against a placeholder. It now means **the loop is meeting its
//! deadline**: a loop running at 60% of target is alive, answers every request, and is badly
//! broken.
//!
//! Holding the pose with no policy (`policy.enabled = false`) stays the right thing to be doing
//! while someone deliberately breaks releases at a bench: the bus sees the real load at the
//! real rate, and nothing falls over when a bad build lands.
//!
//! Every method must be answerable *while the robot is in a bad state*,
//! since that is exactly when it is asked. So the IPC side reads atomics the control loop
//! publishes and never calls into the loop — a wedged loop reports itself unhealthy rather
//! than hanging the caller.

mod chorale;
mod control;
mod intents;
mod params;
mod soc;
mod sound;
mod theremin;

use std::path::PathBuf;
use std::process::ExitCode;
use std::sync::Arc;
use std::sync::atomic::{AtomicBool, AtomicU8, AtomicU32, AtomicU64, Ordering};
use std::time::{Duration, Instant};

use arc_swap::{ArcSwap, ArcSwapOption};
use clap::{Parser, Subcommand};
use duck_control::fall::{FallPredictor, FallPredictorConfig};
use duck_control::io::RobotIo;
use duck_control::obs::{BodyPose, Command as PolicyCommand};
use duck_control::policy::{DEFAULT_STANDING_THRESHOLD, Policy, PolicyError, PolicyPaths};
use duck_control::safety::{Safety, SafetyConfig};
use duck_control::{DEFAULT_POSITION, FakeIo, NUM_JOINTS};
use duck_ipc_proto as proto;
use tokio::io::{AsyncBufReadExt, AsyncWriteExt, BufReader};
use tokio::net::{UnixListener, UnixStream};

use control::{Controller, Driving, SkillTuning, Tuning};
use intents::Intents;
use params::{Mode, Params, Slot};

/// What to do when the shutdown sequence completes. Injected so the tests can observe the
/// call instead of powering off the machine running them.
type PowerOff = Arc<dyn Fn() + Send + Sync>;

/// Model API version this build implements (`updater-design.md` §5.5). Bump when the
/// sensor-input / actuator-output contract a model sees changes.
const MODEL_API: u32 = 1;

/// Socket mode. Same reasoning as `updaterd`'s: the group decides who may ask.
const SOCKET_MODE: u32 = 0o660;

const MAX_LINE: usize = 64 * 1024;

/// How often the loop logs a summary at `info`.
///
/// Per-tick logging would be ~4.3M lines a day at 50 Hz. That is not merely noise: under a
/// journal size cap it is what *evicts* the logs support needs.
const LOOP_SUMMARY_INTERVAL: Duration = Duration::from_secs(300);

/// How fast the beak follows the vowel being sung, as a time constant.
///
/// A vowel is a step — `ah` opens the mouth to 0.90 and `mm` to 0.02 — and a servo asked to jump
/// between them on a 20 ms tick twitches rather than sings. This is roughly how fast a jaw moves.
const CHORALE_MOUTH_TAU_S: f64 = 0.09;

/// How far a subscriber may fall behind before it starts losing frames.
///
/// Five seconds at 50 Hz. State is advisory: a client that cannot keep up gets a gap, never
/// backpressure onto the control loop. Same rule the updater applies to progress.
const STATE_BUFFER: usize = 256;

/// Window over which the achieved rate is measured, and therefore how quickly a degraded
/// loop becomes visible to the health gate. Doubles as the slow-sensor sampling interval
/// ([`publish_slow_sensors`]).
const RATE_WINDOW: Duration = Duration::from_secs(1);

/// How long the ramp to the home pose takes when the policy is first enabled.
///
/// The same two seconds `robotd init` uses, and for the same reason: fast enough that nobody wonders
/// whether the button did anything, slow enough that a robot going from limp to standing does not
/// snap. Not a parameter yet — one number with no evidence that anyone wants a different one.
const HOME_RAMP: Duration = Duration::from_secs(2);

/// Smoothing on the reported battery voltage. At one sample per [`RATE_WINDOW`] this is a
/// ~10 s time constant, which is what makes the number readable: the raw voltage sags
/// several tenths of a volt on every step and recovers between them, so an unsmoothed
/// reading swings while the pack is doing nothing unusual. Borrowed, with the figure, from
/// `microduck_runtime`.
const BATTERY_EMA_ALPHA: f64 = 0.1;

/// How long the shutdown sit gets before torque is cut and the machine powers off, when no
/// controller is there to say. The sitstand descent is a deliberate ~2 s glide; the prototype
/// gives it four seconds, and a running controller derives the same from the set's `ramp_s`
/// (`Controller::shutdown_sit_secs`).
const SHUTDOWN_SIT: Duration = Duration::from_secs(4);

/// How many consecutive failed bus reads the policy may drive through on the last good
/// sample before it stops.
///
/// **One dropped Dynamixel transaction is ordinary** — `robotd` says so itself when it logs
/// one — and it must therefore be *invisible*. It was not: a failed read used to stop the
/// policy for that tick, which commanded the hold pose and reset the controller, so every
/// ordinary dropped read produced a visible twitch. Measured on a bench robot at ~8 drops a
/// minute with a monitor attached, which is exactly the reported "random tiny spasms".
///
/// Coasting is safe because the observation is *already* a tick old by construction: at
/// 50 Hz the policy is trained on data of exactly this age, and a second tick of it is
/// inside that. Three ticks (60 ms) covers a drop, a retry and a slow tick; past that the
/// robot genuinely cannot see, and holding still is the honest answer.
const COAST_TICKS: u32 = 3;

/// How long driving must have been interrupted before the controller is reset.
///
/// The reset zeroes the action history the policy observes and drops the low-pass anchor,
/// which is right after a real pause and is itself a discontinuity after a 20 ms hiccup —
/// the very jolt it exists to prevent.
const RESET_AFTER_PAUSE: Duration = Duration::from_millis(200);

/// Mean leg-joint deviation from the home pose above which a boot counts as seated —
/// hips and knees folded far from standing. The prototype's threshold.
const SEATED_BOOT_RAD: f64 = 0.30;

/// Where the limp-fall sequence is (`[safety] limp_fall`).
///
/// The daemon's only answer to a fall, and it runs *during* one rather than after it: the
/// trigger is [`duck_control::fall::FallPredictor`], not the `fallen` verdict, because a
/// verdict that waits for the robot to be down cannot make it soft before it lands.
///
/// The verdict is still tracked and published throughout — it just does not gate anything.
#[derive(Debug, Clone, Copy, PartialEq)]
enum LimpFall {
    Idle,
    /// Gains at `gain_limp`, joints commanded to wherever they already are — the softest
    /// thing the servos can do short of cutting torque, which would drop the head on the
    /// floor and lose the pose the next phase ramps from.
    Limp {
        since: Instant,
        landing: Landing,
    },
    /// Ramping from where the robot landed back to the standing pose, so the standing
    /// policy starts from the still, known posture it stands up from cleanly.
    Posing {
        from: [f64; NUM_JOINTS],
        since: Instant,
    },
}

/// Watching a limping robot for the moment it stops moving.
///
/// The end of the limp is read from the gyro rather than timed, because the falls are not
/// all the same length: a stumble is over in a few hundred milliseconds and a topple off a
/// table takes most of a second, and ending the limp early is landing stiff after all.
/// Debounced, because a tumbling robot passes through instants of near-zero rate on its
/// way over — one quiet sample is not a landing.
#[derive(Debug, Clone, Copy, PartialEq, Default)]
struct Landing {
    still_for: Duration,
}

impl Landing {
    /// One tick. `rate` is the gyro magnitude in rad/s, or `None` for a tick with no fresh
    /// sample — which resets rather than accumulates: a robot nobody can read is not a
    /// robot anybody has seen go still.
    fn observe(&mut self, rate: Option<f64>, period: Duration, below: f64, held: Duration) -> bool {
        self.still_for = match rate {
            Some(rate) if rate < below => self.still_for.saturating_add(period),
            _ => Duration::ZERO,
        };
        self.still_for >= held
    }
}

impl LimpFall {
    /// The interpolated pose target for this tick, or `None` once the ramp is done.
    ///
    /// The same linear shape as [`Bringup::homing_target`], and separate from it on
    /// purpose: that ramp is bring-up from limp at the policy gain over a fixed two
    /// seconds, this one is a landed robot being put back into shape, and both its
    /// duration and its gain are tunable because both depend on how the robot lands.
    fn pose_target(&self, now: Instant, over: Duration) -> Option<[f64; NUM_JOINTS]> {
        let LimpFall::Posing { from, since } = self else {
            return None;
        };
        let t = now.duration_since(*since).as_secs_f64() / over.as_secs_f64();
        if t >= 1.0 {
            return None;
        }
        let mut target = [0.0; NUM_JOINTS];
        for (i, slot) in target.iter_mut().enumerate() {
            *slot = from[i] + (DEFAULT_POSITION[i] - from[i]) * t;
        }
        Some(target)
    }
}

#[derive(clap::ValueEnum, Clone, Copy, Debug, PartialEq, Eq)]
enum BusKind {
    /// Dynamixel protocol 2.0 — the shipped Microduck's bus.
    Dynamixel,
    /// Feetech SCS series (SCS225), one serial port, ids 1..=13.
    Scs,
}

#[derive(Parser, Debug)]
#[command(name = "robotd", about = "Robot control daemon", version)]
struct Args {
    /// Socket to serve the `robot.*` API on. `updaterd --robot-socket` must match.
    #[arg(long, default_value = "/run/robotd.sock")]
    socket: PathBuf,

    /// Params file. Defaults to `/etc/robot/robotd.toml`, which may be absent — an
    /// unprovisioned board comes up on defaults. A path given here must exist.
    #[arg(long)]
    params: Option<PathBuf>,

    /// Serial port override, for a board wired differently from the shipped default.
    #[arg(long)]
    port: Option<String>,

    /// Which motor bus to speak. `dynamixel` is the shipped Microduck; `scs` is a Feetech
    /// SCS series bus (13 SCS225 servos, ids 1..=13) as used on the RK3588 bench port.
    #[arg(long, value_enum, default_value = "dynamixel")]
    bus: BusKind,

    /// Run against a robot made of nothing. For laptop development and tests — there is no
    /// simulator yet, and this is what stands in for one.
    #[arg(long)]
    fake: bool,

    /// Do not load a policy: run the loop and hold the startup pose.
    ///
    /// Distinct from a policy that failed to load, which is unhealthy. This is the
    /// configuration to use when the thing under test is the updater rather than the gait —
    /// nothing falls over when a deliberately broken release lands.
    #[arg(long)]
    no_policy: bool,

    /// Report unhealthy. For exercising the updater's rollback path on a bench robot
    /// without having to break a real build.
    #[arg(long)]
    unhealthy: bool,

    /// Report that it is not safe to restart, as if the robot were moving.
    #[arg(long)]
    busy: bool,

    #[command(subcommand)]
    command: Option<Command>,
}

#[derive(Subcommand, Debug)]
enum Command {
    /// Enable torque and move to the home pose, then exit.
    ///
    /// Explicit, and separate from running the daemon, because the control loop must never
    /// move the robot on its own: `robotd` restarting during an update would otherwise make
    /// a standing robot lurch, which is both a fall risk and a confounder when the thing
    /// under test is the updater.
    Init {
        #[arg(long, default_value = "2s", value_parser = parse_duration)]
        duration: Duration,
    },
}

fn parse_duration(raw: &str) -> Result<Duration, String> {
    let (value, scale) = match raw.strip_suffix("ms") {
        Some(v) => (v, 1u64),
        None => match raw.strip_suffix('s') {
            Some(v) => (v, 1000),
            None => (raw, 1000),
        },
    };
    value
        .parse::<u64>()
        .map(|n| Duration::from_millis(n * scale))
        .map_err(|_| format!("expected e.g. 500ms or 2s, got {raw:?}"))
}

/// What the control loop publishes about itself.
///
/// Atomics rather than a mutex on purpose: the IPC side must never be able to block on the
/// control loop. A robot whose loop is wedged still has to be able to say "I am not
/// healthy" — if answering required the loop's lock, the one situation where `updaterd`
/// needs an answer is the situation it would hang in.
/// [`Mode`] as the byte [`RobotState::mode`] holds, and back.
///
/// Two tiny functions rather than a numeric cast, so the mapping is written down once: a mode
/// added later gets a code here and nowhere else, and an unknown byte reads as walking rather
/// than panicking on the IPC thread.
fn mode_code(mode: Mode) -> u8 {
    match mode {
        Mode::Walk => 0,
        Mode::Roller => 1,
    }
}

fn mode_of(code: u8) -> Mode {
    match code {
        1 => Mode::Roller,
        _ => Mode::Walk,
    }
}

/// The policy file names for one mode, as a set.
///
/// `None` in a skill slot doubles as "this robot cannot do that", which is what lets `dispatch`
/// refuse a `robot.do` for a skill this mode has no network for instead of queueing a request the
/// loop will drop — and roller mode is exactly that case: no standing network, a crouch where the
/// ground pick was.
#[derive(Debug, Clone, Default)]
struct PolicyNames {
    walk: Option<String>,
    stand: Option<String>,
    sitstand: Option<String>,
    ground_pick: Option<String>,
    /// The configurable one-shots this robot has, in priority order — the names a client may
    /// ask for, and the answer to "what can this robot do".
    skills: Vec<String>,
}

impl PolicyNames {
    /// The names for `policy`, or all-`None` when no policy is wanted.
    fn of(policy: &params::ResolvedPolicy) -> Self {
        if !policy.enabled {
            return Self::default();
        }
        let name = |path: &Option<std::path::PathBuf>| path.as_deref().and_then(file_name);
        Self {
            walk: file_name(&policy.walk),
            stand: name(&policy.stand),
            sitstand: name(&policy.sitstand),
            ground_pick: name(&policy.ground_pick),
            skills: policy.skills.iter().map(|s| s.name.clone()).collect(),
        }
    }
}

/// Why a slot is not running what was asked of it, for as long as that stays true.
///
/// A `Vec` rather than seven fields or a map: it is empty on nearly every robot, at most seven
/// long, and the linear scan is over a list shorter than the branch predictor's memory.
#[derive(Debug, Default, Clone)]
struct SlotErrors(Vec<(Slot, String)>);

impl SlotErrors {
    fn get(&self, slot: Slot) -> Option<&str> {
        self.0
            .iter()
            .find(|(s, _)| *s == slot)
            .map(|(_, reason)| reason.as_str())
    }

    fn set(&mut self, slot: Slot, reason: String) {
        self.clear(slot);
        self.0.push((slot, reason));
    }

    fn clear(&mut self, slot: Slot) {
        self.0.retain(|(s, _)| *s != slot);
    }
}

/// Where a policy file came from, for `robot.policies`.
///
/// Three origins, and the path is enough to tell them apart because the path is *made* of the
/// answer: the official set lives in its own directory, and a fetched policy lands under
/// `<library>/<org>/<name>/<revision>/`, so the org that published it is a path component. A
/// file anywhere else is one somebody put there by hand.
///
/// **Not a security boundary**, and nothing here pretends otherwise. Someone who can edit
/// `robotd.toml` can point a slot at a directory named to look official, and someone who can do
/// that can run whatever they like anyway. What stands between a bad policy and a broken robot
/// is the safety layer and the shape gate, not this label
/// (`docs/design/policy-channel-design.md` §2). This is here so a person can see what they are
/// running.
fn origin_of(path: &std::path::Path) -> &'static str {
    if path.starts_with(params::POLICY_DIR) {
        return "official";
    }
    if let Ok(rest) = path.strip_prefix(params::POLICY_LIBRARY)
        && let Some(org) = rest.components().next()
    {
        return if org.as_os_str() == OFFICIAL_ORG {
            "official"
        } else {
            "community"
        };
    }
    "local"
}

/// The org whose policies are official. One constant, matching `updater::policy::OFFICIAL_ORG`:
/// a robot that can be *told* which org to trust has a badge that means nothing.
const OFFICIAL_ORG: &str = "pollen-robotics";

/// The per-slot answer to `robot.policies`: what is loaded, from where, and why not.
///
/// Derived rather than stored, from the three things that between them decide it — what config
/// says, what that resolved to, and what failed. Storing it instead would be a fourth place for
/// the same fact, updated from three.
fn slot_report(
    policy_params: &params::PolicyParams,
    cfg: &params::ResolvedPolicy,
    errors: &SlotErrors,
) -> Vec<proto::PolicySlot> {
    Slot::ALL
        .into_iter()
        .map(|slot| {
            let path = cfg.slot(slot);
            proto::PolicySlot {
                slot: slot.as_str().to_owned(),
                path: path.map(|p| p.display().to_string()),
                origin: path.map(|p| origin_of(p).to_owned()),
                overridden: policy_params.slot(slot).is_some(),
                error: errors.get(slot).map(str::to_owned),
            }
        })
        .collect()
}

/// Drop any *overridden* slot whose file will not load, before the controller is built.
///
/// The sharp edge of `robotctl policy load` writing config: a file that loaded when it was tried
/// can be gone by the next boot — deleted, on a wiped library, on a reflashed board whose config
/// was restored. Without this the daemon reports unhealthy on every start, and `updaterd`'s
/// health gate then rolls back daemon releases for a reason no release caused: an update loop
/// over a missing file no update could have supplied.
///
/// So an override that will not load costs its slot and nothing else. The slot falls back to the
/// mode's default, the reason is recorded, and health reports **degraded** — the state for a
/// fault that belongs to the board rather than to the release being gated, where reverting the
/// daemon cannot help and only churns the boot counter.
///
/// **Only overrides.** An official path that will not load is a broken bundle and must reach the
/// health gate as unhealthy, which is exactly what rolls it back.
///
/// **And only faults that name a file.** A missing ONNX Runtime fails every path equally; taking
/// it as evidence against each override in turn would silently strip a board's whole
/// configuration because a dylib was not installed. `docs/design/policy-channel-design.md` §5.
fn drop_unloadable_overrides(policy_params: &mut params::PolicyParams, errors: &mut SlotErrors) {
    drop_unloadable_overrides_with(policy_params, errors, duck_control::policy::validate)
}

/// [`drop_unloadable_overrides`] with the check injected, so its two rules can be tested on a
/// machine that has no ONNX Runtime — which is every machine this repository's tests run on, and
/// is itself one of the cases the rules are about.
fn drop_unloadable_overrides_with(
    policy_params: &mut params::PolicyParams,
    errors: &mut SlotErrors,
    validate: impl Fn(&std::path::Path) -> Result<(), PolicyError>,
) {
    if !policy_params.enabled {
        return;
    }
    // A `walk = "none"` already in the file, from a `policy load walk none` this daemon used to
    // accept. `resolved` now falls back rather than panicking, so the robot walks — but it walks
    // with something the config does not name, which is exactly what this reports.
    if policy_params
        .slot(Slot::Walk)
        .as_deref()
        .is_some_and(params::is_none_sentinel)
    {
        tracing::error!("[policy] walk = \"none\" cannot be honoured; using this robot's own");
        errors.set(
            Slot::Walk,
            "the walking policy cannot be switched off; using this robot's own".to_owned(),
        );
        policy_params.set_slot(Slot::Walk, None);
    }

    for slot in Slot::ALL {
        if policy_params.slot(slot).is_none() {
            continue;
        }
        let cfg = policy_params.resolved();
        // A slot set to the literal "none" resolves to nothing, and disabling a capability on
        // purpose is not a fault to fall back from.
        let Some(path) = cfg.slot(slot) else {
            continue;
        };
        let Err(e) = validate(path) else {
            continue;
        };
        if e.path().is_none() {
            tracing::error!(error = %e, "cannot validate policies at all; leaving config alone");
            return;
        }
        tracing::error!(
            slot = slot.as_str(),
            path = %path.display(),
            error = %e,
            "override will not load; falling back to this slot's default"
        );
        errors.set(slot, e.to_string());
        policy_params.set_slot(slot, None);
    }
}

struct RobotState {
    /// Epoch for every timestamp below. `Instant` so the clock cannot go backwards.
    started: Instant,
    ticks: AtomicU64,
    /// Ticks whose work overran the period. Cumulative, for diagnosis; the rate check is
    /// what catches a sustained problem.
    missed: AtomicU64,
    /// Microseconds since `started` at the last completed tick.
    last_tick_us: AtomicU64,
    /// Achieved rate over the last window, as `f64::to_bits`. Zero until the first window
    /// closes, which is why the stall check carries the first second.
    achieved_hz: AtomicU64,
    /// Consecutive failed bus reads. Reset by any success.
    consecutive_errors: AtomicU32,
    /// Failed attempts to bring the bus up — opening it, verifying its registers, or
    /// reading the startup pose. Non-zero means the loop is still waiting for a robot to
    /// answer and has never commanded anything.
    startup_bus_failures: AtomicU32,
    /// Motor-bus voltage, EMA-smoothed, as `f64::to_bits`. Zero means *not read yet* — a
    /// distinction that has to survive to the wire, since zero volts and unknown volts look
    /// nothing alike to whoever is deciding whether to charge the robot.
    battery_v: AtomicU64,
    /// Hottest servo of the last thermal sample: temperature as `f64::to_bits`, and which
    /// joint it was. Zero means *not read yet*, same as the battery.
    motor_max_c: AtomicU64,
    motor_mean_c: AtomicU64,
    /// Index into [`duck_control::JOINT_NAMES`] of the hottest joint.
    motor_hottest: AtomicU32,
    /// Hottest board thermal zone, as `f64::to_bits`. Zero means no reading — off Linux, or a
    /// kernel with no thermal sysfs ([`soc`]).
    cpu_temp_c: AtomicU64,
    /// Mirrors of the bus's own IMU diagnostics, refreshed with the thermal sample. Held here
    /// so the IPC side can report them without touching the loop's IO.
    imu_stale_blocks: AtomicU64,
    /// Stale reads in a row as of the last sample. Sampled rather than watched, which is fine
    /// for the fault it describes: a board that has stopped refreshing keeps repeating, so its
    /// run is still growing whenever the next sample lands.
    imu_stale_run: AtomicU64,
    imu_ready: AtomicBool,
    shutdown: AtomicBool,
    /// Fan-out for `robot.state`. Bounded and lossy by design — see [`STATE_BUFFER`].
    state_tx: tokio::sync::broadcast::Sender<proto::RobotState>,
    /// What `btd` should be advertising, published when it changes.
    ///
    /// A broadcast channel like the state stream, and for the same reason: `btd` subscribes, and a
    /// `robotd` with nobody subscribed must not be blocked by that. Small buffer — a subscriber
    /// that has fallen behind on beacons wants the newest one, not a backlog of beats that have
    /// already passed.
    chorale_tx: tokio::sync::broadcast::Sender<proto::ChoraleAdvertise>,
    /// Why the policy is not loaded, if it is not. Set once at startup; the loop keeps
    /// running and holds the pose, so a broken bundle is a rollback rather than a crash.
    policy_error: ArcSwapOption<String>,
    /// Why the last policy change failed, when it named no slot to blame it on.
    ///
    /// **Not [`RobotState::policy_error`]**, and the difference is the health verdict.
    /// That one is the release's own policy failing to load, which is unhealthy and rolls the
    /// release back. This is somebody's *change* failing — a reload after a skill was added, a
    /// whole-robot reset — where the robot is still running the policy it had, so it is degraded
    /// and a rollback would fix nothing.
    ///
    /// A change to one slot is reported on that slot instead, which says more.
    policy_change_error: ArcSwapOption<String>,
    /// Which policy files this process is running, as file names. `None` when the policy is
    /// disabled.
    ///
    /// From the params rather than from the loaded network, and therefore known before the
    /// control thread has finished loading anything — a client that subscribes during startup
    /// gets the answer rather than a race. What *failed* to load is `policy_error`; this is
    /// what was asked for, and the pair is what distinguishes "no policy wanted" from "the
    /// policy this release ships would not load".
    ///
    /// **One swap for the whole set rather than seven fields**, because a mode switch replaces
    /// all of them at once: a reader that caught `walk` from roller beside `stand` from walking
    /// would be told about a robot that does not exist. Swapped by the control loop, which is
    /// the only thing that loads a policy.
    policies: ArcSwap<PolicyNames>,
    /// The per-slot report `robot.policies` serves — paths, origins, and any slot whose override
    /// could not be loaded.
    ///
    /// Beside [`Self::policies`] rather than replacing it: that one is read every time a client
    /// asks which skills exist, on a hot path, and answers with file names alone. This is the
    /// whole picture and is read when somebody asks a question about policies, which is rare.
    /// Swapped together and by the same thread, so the two cannot disagree.
    policy_slots: ArcSwap<Vec<proto::PolicySlot>>,
    /// `[policy] enabled`. A startup constant — nothing switches it at runtime — and it is here
    /// because `robot.policies` has to distinguish a robot that is deliberately holding its pose
    /// from one whose slots merely look empty.
    policy_enabled: bool,
    /// The config file this robot was started with, for the two calls that write it.
    ///
    /// Everything else here reads config once at startup and keeps what it parsed. `pad.bind` has
    /// to write, because `padd` re-reads `[pad]` from the file every second — a binding held only
    /// in memory would be reverted before anybody let go of the phone.
    config_path: PathBuf,
    /// Whether this robot can make a sound at all: audio enabled, and a bank with wavs in
    /// it. Same job as the `policy_*` fields above — false is "this robot cannot do that",
    /// which is what lets `dispatch` refuse a `robot.sound` with a reason instead of
    /// accepting it into silence. Read once at startup, like the policies: the postinstall
    /// renders the bank and restarts robotd, so a bank cannot appear under a running one.
    has_voice: bool,
    /// Whether a theremin can be picked up: the params allow one, and the depth stream is
    /// actually delivering frames. Published by the loop rather than read once at startup,
    /// because unlike a voice bank the sensor comes and goes — `tofd` restarts, the ToF
    /// drops off the I²C bus — and an accepted theremin on a duck with no depth is a
    /// feature that silently does nothing.
    theremin_ready: AtomicBool,
    /// Whether this robot's config allows it to sing with others. Read once at startup, like the
    /// policies: `[chorale] accept`, false by default.
    chorale_accepted: bool,
    /// `walk` or `roller`, as `robot.mode` reports it.
    ///
    /// Not constant any more: `robot.setMode` switches it while the robot runs, so this is stored
    /// rather than read from the params it started as. An `AtomicU8` over [`Mode`] because it is
    /// read on the IPC side and written by the control loop, and there is nothing to allocate.
    mode: AtomicU8,
    /// Published by the loop so the IPC side can answer without consulting it.
    fallen: AtomicBool,
    /// The policy is driving and has been asked for a non-zero velocity.
    moving: AtomicBool,
    /// Torque is on and the joints are at the home pose, so the policy can drive.
    ///
    /// False covers two different states on purpose — never brought up, and ramping — because a
    /// client can act on neither: the answer to both is "wait, or press Start". The journal
    /// distinguishes them.
    homed: AtomicBool,

    period_us: u64,
    min_achieved_hz: f64,
    stall_periods: u32,
    max_consecutive_errors: u32,
    force_unhealthy: bool,
    force_busy: bool,
}

impl RobotState {
    fn new(
        params: &Params,
        config_path: &std::path::Path,
        force_unhealthy: bool,
        force_busy: bool,
    ) -> Self {
        Self {
            started: Instant::now(),
            ticks: AtomicU64::new(0),
            missed: AtomicU64::new(0),
            last_tick_us: AtomicU64::new(0),
            achieved_hz: AtomicU64::new(0),
            consecutive_errors: AtomicU32::new(0),
            startup_bus_failures: AtomicU32::new(0),
            battery_v: AtomicU64::new(0),
            motor_max_c: AtomicU64::new(0),
            motor_mean_c: AtomicU64::new(0),
            motor_hottest: AtomicU32::new(0),
            cpu_temp_c: AtomicU64::new(0),
            imu_stale_blocks: AtomicU64::new(0),
            imu_stale_run: AtomicU64::new(0),
            imu_ready: AtomicBool::new(false),
            shutdown: AtomicBool::new(false),
            state_tx: tokio::sync::broadcast::Sender::new(STATE_BUFFER),
            chorale_tx: tokio::sync::broadcast::Sender::new(8),
            policy_error: ArcSwapOption::empty(),
            policy_change_error: ArcSwapOption::empty(),
            policies: ArcSwap::from_pointee(PolicyNames::of(&params.policy.resolved())),
            policy_slots: ArcSwap::from_pointee(slot_report(
                &params.policy,
                &params.policy.resolved(),
                &SlotErrors::default(),
            )),
            policy_enabled: params.policy.enabled,
            config_path: config_path.to_owned(),
            has_voice: params.audio.enabled && has_any_wav(&params.audio.bank),
            theremin_ready: AtomicBool::new(false),
            chorale_accepted: params.chorale.accept,
            mode: AtomicU8::new(mode_code(params.policy.mode)),
            fallen: AtomicBool::new(false),
            moving: AtomicBool::new(false),
            homed: AtomicBool::new(false),
            period_us: params.period().as_micros() as u64,
            min_achieved_hz: params.update_gate.min_achieved_hz,
            stall_periods: params.update_gate.stall_periods,
            max_consecutive_errors: params.update_gate.max_consecutive_errors,
            force_unhealthy,
            force_busy,
        }
    }

    fn health(&self) -> proto::HealthResult {
        // Everything the robot can say about itself, attached to every answer whatever the
        // verdict — and consulted by none of the checks below.
        //
        // Two separate jobs in one method, deliberately. `healthy`/`degraded` are the update
        // system's inputs and may only reflect what a *release* can be blamed for. The rest
        // is a description of the robot for whoever is looking at it, and it travels on the
        // same answer because a robot behaving oddly is asked exactly one question, once.
        let describe =
            |healthy: bool, degraded: bool, reason: Option<String>| proto::HealthResult {
                healthy,
                degraded,
                reason,
                battery: self.battery(),
                motors: self.motor_thermal(),
                cpu_temp_c: {
                    // Zero is "never read", the same sentinel the battery uses: a board at
                    // 0 °C is a sensor that is not there, not a cold robot.
                    let c = f64::from_bits(self.cpu_temp_c.load(Ordering::Relaxed));
                    (c > 0.0).then_some(c)
                },
                control_loop: Some(self.loop_health()),
                bus: proto::BusHealth {
                    consecutive_errors: self.consecutive_errors.load(Ordering::Relaxed),
                    startup_failures: self.startup_bus_failures.load(Ordering::Relaxed),
                },
                imu: Some(proto::ImuHealth {
                    ready: self.imu_ready.load(Ordering::Relaxed),
                    stale_blocks: self.imu_stale_blocks.load(Ordering::Relaxed),
                    consecutive_stale_blocks: self.imu_stale_run.load(Ordering::Relaxed),
                }),
            };

        let unhealthy = |reason: String| describe(false, false, Some(reason));
        // Not healthy, but not the release's fault either — see `HealthResult::degraded`.
        let degraded = |reason: String| describe(false, true, Some(reason));

        if self.force_unhealthy {
            return unhealthy("forced unhealthy by --unhealthy".into());
        }

        // "Starting" is not "started". The gate polls, so it will see the transition.
        if self.ticks.load(Ordering::Relaxed) == 0 {
            // Distinguish "starting" from "cannot see a robot". Both mean no ticks, but only
            // one of them is going to resolve on its own, and the update system quotes this
            // string as the reason it rolled a release back — so it has to name the cause.
            let waiting = self.startup_bus_failures.load(Ordering::Relaxed);
            if waiting > 0 {
                // Degraded, not unhealthy: an unpowered bench board must not roll back every
                // release shipped to it. The bus not answering is the same before and after.
                return degraded(format!(
                    "no robot on the motor bus after {waiting} attempts; \
                     is servo power on and the bus wired?"
                ));
            }
            return unhealthy("control loop has not completed a cycle yet".into());
        }

        // A daemon that came up but cannot run its policy is not healthy, however well the
        // loop is ticking. This is what makes the updater roll back a release whose bundle
        // is wrong, instead of leaving a robot that holds a pose and never walks again.
        if let Some(reason) = self.policy_error.load_full() {
            return unhealthy(format!("policy unavailable: {reason}"));
        }

        // A slot running its default because an override would not load. Degraded rather than
        // unhealthy, and the distinction is load-bearing: this is a property of the *board* —
        // somebody's file is missing — so reverting the daemon cannot fix it, and gating on it
        // would make every subsequent release fail its health check over a stale config line.
        // The robot walks; it walks with the policy it shipped with, and says so.
        let fell_back = self.policy_slots.load();
        let mut fell_back = fell_back
            .iter()
            .filter_map(|slot| slot.error.as_ref().map(|e| format!("{}: {e}", slot.slot)))
            .peekable();
        if fell_back.peek().is_some() {
            return degraded(format!(
                "using the default policy where an override would not load — {}",
                fell_back.collect::<Vec<_>>().join("; ")
            ));
        }

        // A reload or a reset that would not build. Same verdict and the same reasoning as the
        // slots above: the robot kept the policy it had, so it walks, and no release the update
        // gate could revert to would change the outcome.
        if let Some(reason) = self.policy_change_error.load_full() {
            return degraded(format!("the last policy change did not take — {reason}"));
        }

        let errors = self.consecutive_errors.load(Ordering::Relaxed);
        if errors >= self.max_consecutive_errors {
            return unhealthy(format!("{errors} consecutive bus read failures"));
        }

        // A wedged loop stops stamping. This is what turns a hung control thread into an
        // honest answer instead of a socket that keeps saying "healthy" forever.
        let now_us = self.started.elapsed().as_micros() as u64;
        let stale_us = now_us.saturating_sub(self.last_tick_us.load(Ordering::Relaxed));
        let stall_limit_us = self.period_us.saturating_mul(self.stall_periods as u64);
        if stale_us > stall_limit_us {
            return unhealthy(format!("control loop stalled for {} ms", stale_us / 1000));
        }

        let hz = f64::from_bits(self.achieved_hz.load(Ordering::Relaxed));
        if hz > 0.0 && hz < self.min_achieved_hz {
            return unhealthy(format!(
                "control loop at {hz:.1} Hz, below the {:.1} Hz floor",
                self.min_achieved_hz
            ));
        }

        describe(true, false, None)
    }

    /// The loop's own numbers, as the readout reports them.
    fn loop_health(&self) -> proto::LoopHealth {
        let hz = f64::from_bits(self.achieved_hz.load(Ordering::Relaxed));
        let now_us = self.started.elapsed().as_micros() as u64;
        proto::LoopHealth {
            target_hz: 1_000_000.0 / self.period_us as f64,
            // Zero is the "no window has closed yet" sentinel, not a measured rate.
            achieved_hz: (hz > 0.0).then_some(hz),
            ticks: self.ticks.load(Ordering::Relaxed),
            missed: self.missed.load(Ordering::Relaxed),
            last_tick_age_ms: now_us.saturating_sub(self.last_tick_us.load(Ordering::Relaxed))
                / 1000,
        }
    }

    /// The hottest servo of the last thermal sample, or `None` before the first one.
    fn motor_thermal(&self) -> Option<proto::MotorThermal> {
        let max_c = f64::from_bits(self.motor_max_c.load(Ordering::Relaxed));
        if max_c <= 0.0 {
            return None;
        }
        let hottest = self.motor_hottest.load(Ordering::Relaxed) as usize;
        Some(proto::MotorThermal {
            hottest: duck_control::JOINT_NAMES
                .get(hottest)
                .unwrap_or(&"unknown")
                .to_string(),
            max_c,
            mean_c: f64::from_bits(self.motor_mean_c.load(Ordering::Relaxed)),
        })
    }

    /// The last battery reading, mapped to a percentage — or `None` if there has not been
    /// one.
    ///
    /// Zero is the "never read" sentinel rather than a measurement: the atomic starts there,
    /// and a robot whose bus cannot answer never leaves it. Reporting that as `0.00 V, 0%`
    /// would put a flat-battery warning in front of anyone whose robot has been up for less
    /// than a second.
    fn battery(&self) -> Option<proto::Battery> {
        let volts = f64::from_bits(self.battery_v.load(Ordering::Relaxed));
        (volts > 0.0).then(|| proto::Battery {
            volts,
            percent: duck_control::battery_percent(volts),
        })
    }

    fn safe_to_restart(&self) -> proto::SafeToRestartResult {
        if self.force_busy {
            return proto::SafeToRestartResult {
                safe: false,
                reason: Some("forced busy by --busy".into()),
            };
        }
        // Restarting motor control mid-stride is how a robot falls over
        // (`updater-design.md` §7.2). A robot that is merely standing, or already down, is
        // safe to interrupt — it is going nowhere either way.
        if self.moving.load(Ordering::Relaxed) && !self.fallen.load(Ordering::Relaxed) {
            return proto::SafeToRestartResult {
                safe: false,
                reason: Some("the robot is walking".into()),
            };
        }
        proto::SafeToRestartResult {
            safe: true,
            reason: None,
        }
    }
}

#[tokio::main]
async fn main() -> ExitCode {
    // Rust ignores SIGPIPE, which turns `robotd ... | head` into a panic.
    unsafe { libc::signal(libc::SIGPIPE, libc::SIG_DFL) };

    let args = Args::parse();

    tracing_subscriber::fmt()
        .with_env_filter(
            tracing_subscriber::EnvFilter::try_from_default_env()
                .unwrap_or_else(|_| tracing_subscriber::EnvFilter::new("info")),
        )
        .with_writer(std::io::stderr)
        .init();

    duck_ipc_proto::log_startup_identity!("robotd");

    let explicit = args.params.is_some();
    let params_path = args
        .params
        .clone()
        .unwrap_or_else(|| PathBuf::from(params::DEFAULT_PATH));
    let mut params = match Params::load(&params_path, explicit) {
        Ok(params) => params,
        Err(e) => {
            tracing::error!(error = %e, "bad params");
            return ExitCode::FAILURE;
        }
    };
    if let Some(port) = args.port.clone() {
        params.bus.port = port;
    }
    if args.no_policy {
        params.policy.enabled = false;
    }

    if let Some(Command::Init { duration }) = args.command {
        return run_init(&params, duration, args.bus);
    }

    let state = Arc::new(RobotState::new(
        &params,
        &params_path,
        args.unhealthy,
        args.busy,
    ));

    if args.unhealthy {
        tracing::warn!("--unhealthy: will report unhealthy, so updates will roll back");
    }
    if args.busy {
        tracing::warn!("--busy: will refuse restarts, so updates will be held off");
    }

    let intents = Arc::new(Intents::new());

    // The real thing. `setsid` detaches the command from this process's cgroup, so the
    // poweroff proceeds while systemd is busy killing robotd itself.
    let poweroff: PowerOff = Arc::new(|| {
        let result = std::process::Command::new("setsid")
            .args(["sh", "-c", "systemctl poweroff"])
            .spawn();
        if let Err(e) = result {
            tracing::error!(error = %e, "cannot power off");
        }
    });

    let control = match spawn_control_thread(
        &args,
        &params,
        Arc::clone(&state),
        Arc::clone(&intents),
        poweroff,
    ) {
        Ok(handle) => handle,
        Err(e) => {
            tracing::error!(error = %e, "cannot start the control loop");
            return ExitCode::FAILURE;
        }
    };

    let serving = serve(
        Arc::clone(&state),
        Arc::clone(&intents),
        args.socket.clone(),
    );
    let mut code = ExitCode::SUCCESS;
    tokio::select! {
        result = serving => {
            if let Err(e) = result {
                tracing::error!(error = %e, "IPC server stopped");
                code = ExitCode::FAILURE;
            }
        }
        _ = shutdown() => tracing::info!("shutting down"),
    }

    // Ask the loop to stop and let it finish the tick it is in, rather than aborting
    // mid-transaction and leaving a half-written packet on the bus.
    state.shutdown.store(true, Ordering::Relaxed);
    let _ = control.join();
    let _ = std::fs::remove_file(&args.socket);
    code
}

/// Enable torque and ramp to the home pose.
#[cfg(target_os = "linux")]
fn run_init(params: &Params, duration: Duration, bus: BusKind) -> ExitCode {
    let mut io = match open_selected_bus(&params.bus.port, bus) {
        Ok(io) => io,
        Err(e) => {
            tracing::error!(error = %e, port = %params.bus.port, "cannot open the bus");
            return ExitCode::FAILURE;
        }
    };
    if let Err(e) = io.check_registers() {
        tracing::error!(error = %e, "motor register check failed");
        return ExitCode::FAILURE;
    }
    if let Err(e) = io.set_torque(true) {
        tracing::error!(error = %e, "cannot enable torque");
        return ExitCode::FAILURE;
    }
    // Before the ramp, not after: position_p_gain is a RAM register that survives this
    // process, so whatever was written last is what the robot stands up with. A previous fall
    // leaves `gain_limp` (50) there, and `init` would then take the robot to its home pose at
    // a third of the intended stiffness — soft enough to be a fall risk in the one command
    // whose whole job is establishing a known state.
    //
    // `robotd`'s control loop sets its own gain on the first tick, so this only governs the
    // ramp and the window before the daemon starts — which is exactly the window where the
    // robot is standing up unsupported.
    if let Err(e) = io.set_gain(params.policy.gain) {
        tracing::error!(error = %e, gain = params.policy.gain, "cannot set the position gain");
        return ExitCode::FAILURE;
    }
    if let Err(e) = io.interpolate_to(&DEFAULT_POSITION, duration, Duration::from_millis(20)) {
        tracing::error!(error = %e, "interpolation to the home pose failed");
        return ExitCode::FAILURE;
    }
    tracing::warn!(?duration, "at home pose, torque enabled");
    ExitCode::SUCCESS
}

#[cfg(not(target_os = "linux"))]
fn run_init(_params: &Params, _duration: Duration, _bus: BusKind) -> ExitCode {
    tracing::error!("init needs a real bus; this build is not on the robot");
    ExitCode::FAILURE
}

/// Start the control loop on its own OS thread, with its own current-thread runtime.
///
/// Its own thread because the bus read is *blocking* serial I/O — on a shared runtime it
/// would occupy a worker for the duration of every transaction. Its own runtime so IPC work
/// can never be scheduled in front of a tick. This mirrors the prototype, where the loop
/// likewise had a runtime to itself and everything else lived on threads.
fn spawn_control_thread(
    args: &Args,
    params: &Params,
    state: Arc<RobotState>,
    intents: Arc<Intents>,
    poweroff: PowerOff,
) -> std::io::Result<std::thread::JoinHandle<()>> {
    let period = params.period();
    let fake = args.fake;
    let bus = args.bus;
    let port = params.bus.port.clone();
    let params = params.clone();
    // So a reload can re-read `[policy]` without a restart. The path rather than the loaded
    // params, because the point is to pick up what has been written since.
    let params_path = args
        .params
        .clone()
        .unwrap_or_else(|| PathBuf::from(params::DEFAULT_PATH));

    std::thread::Builder::new()
        .name("control".into())
        .spawn(move || {
            let runtime = match tokio::runtime::Builder::new_current_thread()
                .enable_time()
                .build()
            {
                Ok(runtime) => runtime,
                Err(e) => {
                    tracing::error!(error = %e, "cannot build the control runtime");
                    return;
                }
            };

            if fake {
                tracing::warn!("--fake: no bus, no robot");
                runtime.block_on(control_loop(
                    FakeIo::at(DEFAULT_POSITION),
                    state,
                    intents,
                    params,
                    params_path,
                    period,
                    poweroff,
                ));
                return;
            }

            // Waiting, not one shot. `open_bus` verifies motor registers, which means it
            // talks to the servos — so on an unpowered board it fails and this used to fall
            // straight off the end of the thread. No control loop was ever created, and
            // because nothing had been *attempted* the health reason was the bland "control
            // loop has not completed a cycle yet", forever, whatever happened to the robot
            // afterwards. Retrying the read alone was not enough: execution never got there.
            runtime.block_on(async move {
                if let Some(io) = open_bus_waiting(&port, &state, bus).await {
                    control_loop(io, state, intents, params, params_path, period, poweroff).await;
                }
            });
        })
}

/// The real bus on the board; a fake elsewhere, so `open_bus_waiting` has one signature.
///
/// One enum rather than a type alias because the port now carries two protocols: the
/// shipped Dynamixel bus and the Feetech SCS bus used by the RK3588 bench port. Every
/// method delegates, so nothing above this line knows which one is open.
#[cfg(target_os = "linux")]
enum BusIo {
    Dynamixel(duck_control::bus::DynamixelIo),
    Scs(duck_control::scs::ScsIo),
}

/// The SCS wiring: servos on ids 1..=13, skipping the two joints this robot does not have.
///
/// Servo `1 + i` drives `SCS_JOINT_SLOTS[i]`. The machine has no mouth (slot 9) and no head
/// yaw (slot 7), so those two slots are left at zero and never commanded; every other joint
/// keeps the shipped Microduck index so a policy trained for this joint order can be swapped
/// in later without a remap.
#[cfg(target_os = "linux")]
const SCS_JOINT_SLOTS: [usize; 13] = [0, 1, 2, 3, 4, 5, 6, 8, 10, 11, 12, 13, 14];

/// The MPU6050 on the RK3588 bench port: JP5 `P1_A0`/`P1_A1` are I2C2, AD0 tied to ground.
#[cfg(target_os = "linux")]
const SCS_IMU_I2C: &str = "/dev/i2c-2";
#[cfg(target_os = "linux")]
const SCS_IMU_ADDR: u16 = 0x68;

#[cfg(target_os = "linux")]
fn open_scs(port: &str) -> duck_control::io::Result<duck_control::scs::ScsIo> {
    let ids: Vec<u8> = (1..=13).collect();
    let slots: Vec<usize> = SCS_JOINT_SLOTS.to_vec();
    let mut io = duck_control::scs::ScsIo::open(port, 1_000_000, ids, slots)?;
    match duck_control::mpu6050::Mpu6050::open(SCS_IMU_I2C, SCS_IMU_ADDR) {
        Ok(imu) => io.attach_imu(imu),
        Err(e) => tracing::warn!(
            error = %e,
            bus = SCS_IMU_I2C,
            "no IMU on the bus; orientation will be a default, not a measurement"
        ),
    }
    Ok(io)
}

#[cfg(target_os = "linux")]
fn open_selected_bus(port: &str, bus: BusKind) -> duck_control::io::Result<BusIo> {
    match bus {
        BusKind::Dynamixel => duck_control::bus::DynamixelIo::open(port).map(BusIo::Dynamixel),
        BusKind::Scs => open_scs(port).map(BusIo::Scs),
    }
}

#[cfg(target_os = "linux")]
impl BusIo {
    fn check_registers(&mut self) -> duck_control::io::Result<usize> {
        match self {
            BusIo::Dynamixel(io) => io.check_registers(),
            BusIo::Scs(io) => io.check_registers(),
        }
    }

    fn interpolate_to(
        &mut self,
        target: &[f64; duck_control::NUM_JOINTS],
        duration: Duration,
        step: Duration,
    ) -> duck_control::io::Result<()> {
        match self {
            BusIo::Dynamixel(io) => io.interpolate_to(target, duration, step),
            BusIo::Scs(io) => io.interpolate_to(target, duration, step),
        }
    }
}

#[cfg(target_os = "linux")]
impl RobotIo for BusIo {
    fn read(&mut self) -> duck_control::io::Result<duck_control::io::Sensors> {
        match self {
            BusIo::Dynamixel(io) => io.read(),
            BusIo::Scs(io) => io.read(),
        }
    }

    fn write(&mut self, targets: &duck_control::io::JointTargets) -> duck_control::io::Result<()> {
        match self {
            BusIo::Dynamixel(io) => io.write(targets),
            BusIo::Scs(io) => io.write(targets),
        }
    }

    fn set_gain(&mut self, kp: u16) -> duck_control::io::Result<()> {
        match self {
            BusIo::Dynamixel(io) => io.set_gain(kp),
            BusIo::Scs(io) => io.set_gain(kp),
        }
    }

    fn set_torque(&mut self, on: bool) -> duck_control::io::Result<()> {
        match self {
            BusIo::Dynamixel(io) => io.set_torque(on),
            BusIo::Scs(io) => io.set_torque(on),
        }
    }

    fn slow_sensors(&mut self) -> duck_control::io::Result<duck_control::io::SlowSensors> {
        match self {
            BusIo::Dynamixel(io) => io.slow_sensors(),
            BusIo::Scs(io) => io.slow_sensors(),
        }
    }

    fn imu_stale(&self) -> duck_control::io::ImuStale {
        match self {
            BusIo::Dynamixel(io) => io.imu_stale(),
            BusIo::Scs(io) => io.imu_stale(),
        }
    }

    fn imu_ready(&self) -> bool {
        match self {
            BusIo::Dynamixel(io) => io.imu_ready(),
            BusIo::Scs(io) => io.imu_ready(),
        }
    }
}

#[cfg(not(target_os = "linux"))]
type BusIo = FakeIo;

/// Open and verify the bus, waiting for a robot to answer.
///
/// Same reasoning as [`adopt_startup_pose`], one step earlier: an unpowered board cannot
/// pass `check_registers`, and that is a condition someone fixes by flipping a switch, not
/// one to abandon the control loop over.
///
/// Returns `None` only if shutdown is requested while waiting.
async fn open_bus_waiting(port: &str, state: &RobotState, bus: BusKind) -> Option<BusIo> {
    let mut attempt = 0u32;

    while !state.shutdown.load(Ordering::Relaxed) {
        // Logging lives in `open_bus`, which is chatty by design on the first attempt and
        // quiet thereafter — a board waiting overnight must not fill the journal.
        if let Some(io) = open_bus(port, attempt, bus) {
            state.startup_bus_failures.store(0, Ordering::Relaxed);
            return Some(io);
        }
        attempt += 1;
        // Published before sleeping, so `robot.health` can name the cause immediately.
        state.startup_bus_failures.store(attempt, Ordering::Relaxed);

        // Nothing to retry on a platform that has no bus at all.
        if !cfg!(target_os = "linux") {
            return None;
        }
        tokio::time::sleep(STARTUP_RETRY_INTERVAL).await;
    }

    None
}

/// Open and verify the bus, or explain why not.
#[cfg(target_os = "linux")]
fn open_bus(port: &str, attempt: u32, bus: BusKind) -> Option<BusIo> {
    // First attempt and every thirtieth — about one line per 30 s while waiting.
    let loud = attempt == 0 || attempt.is_multiple_of(STARTUP_READ_LOG_EVERY);

    let mut io = match open_selected_bus(port, bus) {
        Ok(io) => io,
        Err(e) => {
            if loud {
                tracing::error!(error = %e, port, attempt, "cannot open the bus; waiting");
            }
            return None;
        }
    };
    match io.check_registers() {
        Ok(0) => tracing::info!("motor registers already correct"),
        Ok(n) => tracing::warn!(corrected = n, "motor registers corrected"),
        Err(e) => {
            if loud {
                tracing::error!(
                    error = %e,
                    attempt,
                    "motor register check failed; waiting, is servo power on?"
                );
            }
            return None;
        }
    }
    Some(io)
}

#[cfg(not(target_os = "linux"))]
fn open_bus(_port: &str, _attempt: u32, _bus: BusKind) -> Option<BusIo> {
    tracing::error!("no bus on this platform; use --fake");
    None
}

/// How long to wait between attempts to read the startup pose.
///
/// A second, not a control period: the read itself already carries a 30 ms bus timeout, and
/// a board waiting for someone to switch servo power on is not in a hurry. Fast enough that
/// powering the robot brings it up while your hand is still on the switch.
const STARTUP_RETRY_INTERVAL: Duration = Duration::from_secs(1);

/// Log one waiting line, then one every this many attempts — about one per 30 s.
const STARTUP_READ_LOG_EVERY: u32 = 30;

/// Adopt the pose the robot is already in, waiting for the bus to answer.
///
/// Never move on start: the servos hold their last commanded goal while this process is
/// dead, so a restart mid-update leaves a standing robot standing, with no gap. That
/// requires a successful read, so there is nothing to command until one lands.
///
/// This used to be a single read that logged and returned on failure — which killed the
/// control thread for the life of the process. `robotd` stayed up and kept answering the
/// socket, so a board booted before its servos were powered was permanently inert: powering
/// them changed nothing and only `systemctl restart robotd` helped, with no hint anywhere
/// that a restart was what was needed. Retrying makes the ordinary order of operations —
/// power the board, then power the servos — just work.
///
/// Read through `Safety` rather than the bus directly: safety owns the only `RobotIo`, so
/// this is the only way to reach it, and going through it keeps that invariant intact even
/// for the one read that happens before the loop starts.
///
/// Returns `None` only if shutdown is requested while waiting.
/// How far the robot has got towards being drivable.
///
/// This is what made pressing Start on a fresh robot do nothing visible: the policy ran, the loop
/// wrote positions, and the servos ignored them because they had no torque. Torque came from
/// `robotd init` — a separate subcommand that opens the motor bus itself, so it needs the daemon
/// stopped, and which appeared in no documentation.
///
/// The invariant the old design protected is narrower than "never touch torque", and it survives
/// intact: **nothing here runs because a process started.** A `robotd` restarted by an update finds
/// `Limp`, writes nothing new, and leaves a standing robot standing. Only an explicit
/// `robot.enable` moves it on, which is a human pressing Start.
#[derive(Debug, Clone, Copy, PartialEq)]
enum Bringup {
    /// No torque asked for yet. The loop still reads, publishes and holds — it just cannot make the
    /// robot do anything, which is the correct state for a robot nobody has asked to move.
    Limp,
    /// Torque is on and the joints are ramping to the home pose. The policy does not drive yet: it
    /// would be stepping from wherever the robot was slumped, which is exactly the lurch the ramp
    /// exists to avoid.
    Homing {
        from: [f64; NUM_JOINTS],
        since: Instant,
    },
    /// At the home pose with torque on. The policy drives when enabled.
    Ready,
}

impl Bringup {
    /// The interpolated target for this tick, or `None` once the ramp is done.
    ///
    /// Linear, like `DynamixelIo::interpolate_to` which `robotd init` uses — same shape, except this
    /// one is computed per tick instead of blocking the thread, because here the loop is running.
    fn homing_target(&self, now: Instant) -> Option<[f64; NUM_JOINTS]> {
        let Bringup::Homing { from, since } = self else {
            return None;
        };
        let t = now.duration_since(*since).as_secs_f64() / HOME_RAMP.as_secs_f64();
        if t >= 1.0 {
            return None;
        }
        let mut target = [0.0; NUM_JOINTS];
        for (i, slot) in target.iter_mut().enumerate() {
            *slot = from[i] + (DEFAULT_POSITION[i] - from[i]) * t;
        }
        Some(target)
    }
}

async fn adopt_startup_pose<T: RobotIo>(
    safety: &mut Safety<T>,
    state: &RobotState,
    period: Duration,
) -> Option<[f64; NUM_JOINTS]> {
    let mut attempt = 0u32;

    while !state.shutdown.load(Ordering::Relaxed) {
        match safety.read() {
            Ok(sensors) => {
                state.startup_bus_failures.store(0, Ordering::Relaxed);
                if attempt > 0 {
                    // Only worth a line if it had to wait — otherwise "control loop running"
                    // below already says everything, and this would just double it.
                    tracing::warn!(
                        attempt,
                        hz = 1.0 / period.as_secs_f64(),
                        "the motor bus answered; holding the pose found at startup"
                    );
                }
                return Some(sensors.positions);
            }
            Err(e) => {
                attempt += 1;
                // Published before sleeping, so `robot.health` can name the cause on the
                // very first failure rather than after the first log line.
                state.startup_bus_failures.store(attempt, Ordering::Relaxed);
                if attempt == 1 || attempt.is_multiple_of(STARTUP_READ_LOG_EVERY) {
                    tracing::warn!(
                        error = %e,
                        attempt,
                        "no answer from the motor bus; waiting, not commanding anything"
                    );
                }
                tokio::time::sleep(STARTUP_RETRY_INTERVAL).await;
            }
        }
    }

    None
}

/// The tick.
///
/// ```text
/// read → observe (fall) → gate (deadman) → policy → safety.apply
/// ```
///
/// Safety holds the only `RobotIo`, so everything above it can propose targets and nothing
/// above it can command a motor.
///
/// A policy that failed to load is survivable, and deliberately so: the loop keeps running
/// at rate, holds its pose, and `robot.health` says why. The updater then rolls the release
/// back. The alternative — refusing to start — becomes a crashloop under
/// `Restart=always` and reaches the health gate as `Unreachable`, which blames the wrong
/// thing in the journal.
/// Load one mode's policy bundle, reporting why not.
///
/// `Ok(None)` is "no policy was wanted", which is healthy; `Err` is "one was wanted and could not
/// be loaded", which is not. Collapsing those two would either make a bench robot look broken or
/// let a release with an unusable bundle pass the health gate.
///
/// Separate from [`build_controller`] because two callers want opposite things from a failure.
/// Startup and a mode switch want it recorded as *the* policy error, which is unhealthy and gets
/// the release rolled back. A `robot.loadPolicy` wants the reason handed back so it can keep the
/// controller it already had — a robot must not lose its gait because somebody tried a file.
/// A policy change between being asked for and being applied.
///
/// The networks load on a thread of their own. `Policy::load` validates and warms up every
/// session, which is most of a second on the board, and this loop cannot stop for that: the
/// swap used to happen only at the home pose, where a stalled command stream cost nothing, but
/// a change to a network that is not driving now happens wherever the robot is — mid-sit,
/// mid-stride — and a walking robot whose targets stop arriving for a second falls over.
struct PendingSwap {
    change: intents::PolicyChange,
    /// The config the change asks for, from the one that is running.
    candidate: params::PolicyParams,
    cfg: params::ResolvedPolicy,
    /// The network that was driving when the request landed is one this change replaces. The
    /// robot goes home first and the new controller starts fresh there, as every change used to.
    /// Otherwise the new controller is swapped in wherever the robot is and continues from the
    /// old one's state — see [`Controller::carry_over`].
    disturbs: bool,
    loading: std::sync::mpsc::Receiver<Result<Option<Controller>, String>>,
    /// What the thread came back with, once it has.
    built: Option<Result<Option<Controller>, String>>,
}

impl PendingSwap {
    /// Collect the thread's answer if it has one. Called once a tick; never blocks.
    fn poll(&mut self) {
        if self.built.is_some() {
            return;
        }
        match self.loading.try_recv() {
            Ok(result) => self.built = Some(result),
            Err(std::sync::mpsc::TryRecvError::Empty) => {}
            Err(std::sync::mpsc::TryRecvError::Disconnected) => {
                self.built = Some(Err(
                    "the policy loading thread ended without a result".to_owned()
                ))
            }
        }
    }

    fn ready(&self) -> bool {
        self.built.is_some()
    }
}

/// Does a change replace the network that is driving the robot right now?
///
/// The report that made this a question: `policy load walk <file>`, a walk, a sit, then `policy
/// reset walk` — and the robot ramped to home and stood up. The reset was right about the config
/// and wrong about the robot: nothing it changed was running. The `sitstand` network had the
/// robot, and it was the same file before and after.
///
/// So a change is compared against what is driving, by the resolved path of that one network — or
/// the whole skill list when a skill is driving, because a skill is addressed by its index in it.
/// `None` driving, or a network that resolves to the same file, is a change the robot need not
/// move for.
///
/// A reload is the exception, and disturbs whatever is in motion: it exists for the case where
/// every path is unchanged and the bytes behind them are not, so the paths cannot say whether the
/// running network is affected. It is also the one change that is never issued while somebody is
/// trying a gait.
///
/// **A seated robot is disturbed by nothing.** The second report: `robotctl policy update` on a
/// robot sitting on the bench, and it ramped to home and stood up — the update ends in a reload,
/// and the reload took the mode switch's path because the sitstand network was driving. But the
/// home-first ramp exists to stop a network being swapped under a *moving* gait, and a seated
/// robot is parked: the network holds a static pose on a constant flag, and `busy()` already says
/// sitting is not travelling. Swapping bytes under that is exactly what `carry_over` was built
/// for — the seat, the flag and the filter anchor go across, and the next tick holds the same
/// pose from the same place. Standing it up to change a file it was not using was the surprise.
fn change_disturbs(
    driving: Option<&Driving>,
    change: &intents::PolicyChange,
    before: &params::ResolvedPolicy,
    after: &params::ResolvedPolicy,
) -> bool {
    let Some(driving) = driving else {
        return false;
    };
    if matches!(driving, Driving::Seated) {
        return false;
    }
    if matches!(change, intents::PolicyChange::Reload) {
        return true;
    }
    match driving {
        Driving::Walk => before.walk != after.walk,
        Driving::Stand => before.stand != after.stand,
        Driving::SitStand => before.sitstand != after.sitstand,
        Driving::Seated => false,
        Driving::GroundPick => before.ground_pick != after.ground_pick,
        Driving::Skill(_) => before.skills != after.skills,
    }
}

/// The config a change asks for, from the one that is running.
///
/// `None` when it cannot be read — a reload of a file that will not parse — which leaves the robot
/// exactly as it is. It is the caller's file and their mistake to fix, and dropping a working
/// policy set over a syntax error would be the worse of the two outcomes.
fn candidate_params(
    change: &intents::PolicyChange,
    current: &params::PolicyParams,
    params_path: &std::path::Path,
    slot_errors: &mut SlotErrors,
) -> Option<params::PolicyParams> {
    let mut candidate = current.clone();
    match change {
        intents::PolicyChange::Slot { slot, path } => candidate.set_slot(*slot, path.clone()),
        intents::PolicyChange::ResetAll => {
            for slot in Slot::ALL {
                candidate.set_slot(slot, None);
            }
        }
        // Re-read `[policy]` from disk, so a skill added since startup is one this robot has
        // without a restart.
        //
        // **Only `[policy]`, and the mode is kept.** The daemons read their config once at
        // startup and that stays true of everything else here — re-reading `[safety]` or
        // `[control]` under a running loop is a different and much larger promise. The mode is
        // carried over because `robot.setMode` deliberately does not write config: adopting the
        // file's mode here would undo a live switch as a side effect of adding a skill.
        intents::PolicyChange::Reload => match params::Params::load(params_path, false) {
            Ok(fresh) => {
                let mode = candidate.mode;
                candidate = fresh.policy;
                candidate.mode = mode;
                // A file may name a skill this board cannot load; the same check startup runs
                // drops it and reports degraded rather than failing.
                drop_unloadable_overrides(&mut candidate, slot_errors);
            }
            Err(e) => {
                tracing::error!(
                    error = %e,
                    path = %params_path.display(),
                    "reload: config will not parse; keeping what is running"
                );
                return None;
            }
        },
    }
    Some(candidate)
}

fn try_controller(
    policy_cfg: &params::ResolvedPolicy,
    limp_fall: bool,
) -> Result<Option<Controller>, PolicyError> {
    if !policy_cfg.enabled {
        tracing::warn!("policy disabled; holding the startup pose");
        return Ok(None);
    }
    {
        let tuning = Tuning {
            action_scale: policy_cfg.action_scale,
            standing_action_scale: policy_cfg.standing_action_scale,
            standing_gain_ratio: policy_cfg.standing_gain_ratio,
            gain: policy_cfg.gain,
            head_lowpass: policy_cfg.head_lowpass,
            legs_lowpass: policy_cfg.legs_lowpass,
        };
        let skills = SkillTuning {
            ground_pick_period: policy_cfg.ground_pick_period,
            ground_pick_end_phase: policy_cfg.ground_pick_end_phase,
            ground_pick_action_scale: policy_cfg.ground_pick_action_scale,
            ground_pick_gain_ratio: policy_cfg.ground_pick_gain_ratio,
            sitstand_rise_s: policy_cfg.sitstand_rise_s,
            sitstand_ramp_s: policy_cfg.sitstand_ramp_s,
            skills: policy_cfg.skills.clone(),
        };
        let paths = PolicyPaths {
            walk: policy_cfg.walk.clone(),
            stand: policy_cfg.stand.clone(),
            sitstand: policy_cfg.sitstand.clone(),
            ground_pick: policy_cfg.ground_pick.clone(),
            // Only the skills whose file resolves — a slot switched off with `"none"` is
            // already filtered out by `resolved_skills`.
            skills: policy_cfg
                .skills
                .iter()
                .filter_map(|skill| skill.resolved_path())
                .collect(),
        };
        match Policy::load(&paths, DEFAULT_STANDING_THRESHOLD) {
            Ok(mut policy) => {
                // Roller mode has no standing network — command magnitude stops selecting
                // it. Nothing else reserves it: limp-fall hands back by *letting* the
                // standing network be selected, which is what stands the robot up.
                if policy_cfg.mode == Mode::Roller {
                    policy.set_standing_disabled(true);
                }
                tracing::warn!(
                    mode = policy_cfg.mode.as_str(),
                    walk = %policy_cfg.walk.display(),
                    stand = ?policy_cfg.stand.as_ref().map(|p| p.display().to_string()),
                    sitstand = ?policy_cfg.sitstand.as_ref().map(|p| p.display().to_string()),
                    ground_pick = ?policy_cfg.ground_pick.as_ref().map(|p| p.display().to_string()),
                    kicks = policy_cfg.kick_left.is_some() || policy_cfg.kick_right.is_some(),
                    roulade = ?policy_cfg.roulade.as_ref().map(|p| p.display().to_string()),
                    limp_fall,
                    "policy loaded"
                );
                Ok(Some(Controller::new(policy, tuning, skills)))
            }
            Err(e) => Err(e),
        }
    }
}

/// How many times the torque cut on the way to a power-off is tried before giving up.
const POWEROFF_TORQUE_ATTEMPTS: u32 = 3;

/// Cut torque before a power-off, and keep asking until every servo has heard.
///
/// This is the one bus write that has to land. The poweroff it precedes kills this process, so a
/// servo the cut did not reach stays stiff with nothing left running to tell it otherwise — and
/// a robot that sat down and switched off with its legs locked is exactly how a single dropped
/// ack presented, reported in the journal by the last tick that could have retried and acted on by
/// nobody. Torque writes are idempotent, so asking three times costs a few milliseconds on a tick
/// where the robot is sitting still, and it is the last thing this loop does that matters.
fn cut_torque_before_poweroff<T: RobotIo>(safety: &mut Safety<T>) {
    for attempt in 1..=POWEROFF_TORQUE_ATTEMPTS {
        match safety.set_torque(false) {
            Ok(()) => return,
            Err(e) => {
                tracing::warn!(error = %e, attempt, "cannot cut torque before power off")
            }
        }
    }
    tracing::error!(
        attempts = POWEROFF_TORQUE_ATTEMPTS,
        "torque may still be on; powering off anyway"
    );
}

/// [`try_controller`], with a failure recorded as *the* policy error.
///
/// The startup and mode-switch path: a policy that was wanted and would not load makes the robot
/// unhealthy, which is what gets a bad release rolled back rather than leaving a duck that holds
/// a pose and never walks again.
fn build_controller(
    policy_cfg: &params::ResolvedPolicy,
    limp_fall: bool,
    state: &RobotState,
) -> Option<Controller> {
    match try_controller(policy_cfg, limp_fall) {
        Ok(controller) => controller,
        Err(e) => {
            tracing::error!(error = %e, "policy unavailable; holding the pose");
            state.policy_error.store(Some(Arc::new(e.to_string())));
            None
        }
    }
}

async fn control_loop<T: RobotIo>(
    io: T,
    state: Arc<RobotState>,
    intents: Arc<Intents>,
    params: Params,
    // Where `[policy]` is re-read from on a reload, so adding a skill needs no restart.
    params_path: PathBuf,
    period: Duration,
    poweroff: PowerOff,
) {
    // Owned rather than borrowed from `params`, because neither the mode nor the slots stay
    // what the file said: `robot.setMode` replaces the mode, `robot.loadPolicy` replaces one
    // slot, and the line below drops any override this board cannot actually load.
    let mut policy_params = params.policy.clone();
    // Slots running their default because an override would not load. Empty on nearly every
    // robot; anything in it makes health degraded and shows up in `robot.policies`.
    let mut slot_errors = SlotErrors::default();
    drop_unloadable_overrides(&mut policy_params, &mut slot_errors);
    // `mut` because a mode switch replaces it: the resolved policy *is* the mode, once the
    // per-mode defaults have been applied.
    let mut policy_cfg = policy_params.resolved();
    // Republished, because `RobotState::new` built both from the file and the check above may
    // have dropped an override since. A client that asks before the first tick gets what this
    // loop is actually going to load, not what the file asked for.
    state.policies.store(Arc::new(PolicyNames::of(&policy_cfg)));
    state.policy_slots.store(Arc::new(slot_report(
        &policy_params,
        &policy_cfg,
        &slot_errors,
    )));
    let mut safety = Safety::new(
        io,
        SafetyConfig {
            fall_gravity_z: params.safety.fall_gravity_z,
            fall_debounce: Duration::from_millis(params.safety.fall_debounce_ms),
            deadman: Duration::from_millis(params.safety.deadman_ms),
            gain_running: policy_cfg.gain,
            gain_limp: params.safety.gain_limp,
        },
    );

    let Some(mut hold) = adopt_startup_pose(&mut safety, &state, period).await else {
        return;
    };

    // Was the robot powered on already sitting? A seated duck has hips and knees folded
    // far from the standing pose. If so, the first bring-up rises via the sitstand network
    // instead of dragging the legs through the linear ramp — the ramp is for a robot that
    // is roughly standing.
    const LEG_JOINTS: [usize; 10] = [0, 1, 2, 3, 4, 10, 11, 12, 13, 14];
    let leg_deviation = LEG_JOINTS
        .iter()
        .map(|&j| (hold[j] - DEFAULT_POSITION[j]).abs())
        .sum::<f64>()
        / LEG_JOINTS.len() as f64;
    let mut seated_boot = leg_deviation > SEATED_BOOT_RAD;
    if seated_boot {
        tracing::warn!(
            deviation = format!("{leg_deviation:.2}"),
            "seated boot detected — will stand up via the sitstand policy"
        );
    }

    // Loaded once here and again on a mode switch — see `build_controller`.
    let mut controller = build_controller(&policy_cfg, params.safety.limp_fall, &state);

    tracing::warn!(
        joints = NUM_JOINTS,
        hz = 1.0 / period.as_secs_f64(),
        driving = controller.is_some(),
        "control loop running"
    );

    let mut ticker = tokio::time::interval(period);
    // `Skip`, not `Burst` and not `Delay`.
    //
    // `Burst` replays a backlog back to back, stacking motor commands — clearly wrong. But
    // `Delay` is wrong too, and less obviously: it schedules the next tick at *now + period*
    // after each one, so every tick's wakeup latency is added to the period rather than
    // absorbed. A few milliseconds of scheduler jitter becomes a permanent rate loss.
    //
    // Measured, not reasoned about: with `Delay` this loop reported 43.1 Hz against a 50 Hz
    // target and `missed = 0` — not overrunning its work, just being rescheduled late every
    // time. With a real bus read costing 3–8 ms it would have been nearer 35 Hz, and it
    // would have looked like a hardware problem.
    //
    // `Skip` keeps the original schedule and drops missed ticks, which is what a control
    // loop wants: no backlog, no drift.
    ticker.set_missed_tick_behavior(tokio::time::MissedTickBehavior::Skip);

    let mut window_start = Instant::now();
    let mut window_ticks = 0u64;
    let mut last_summary = Instant::now();
    let mut was_driving = false;
    let mut bringup = Bringup::Limp;
    // A mode switch in flight: the mode to end up in, once the robot is home. `None` the rest of
    // the time, which is nearly always.
    let mut mode_change: Option<Mode> = None;
    // A policy load in flight, for the same reason and on the same path as `mode_change`: the
    // robot goes home first, and the swap happens there.
    let mut pending_swap: Option<PendingSwap> = None;

    // Command smoothing, per the prototype: `cmd += α × (target − cmd)` at the tick rate.
    // A stick snap becomes a ramp the gait can follow; the state lives here because it is
    // per-tick, which the intent slots must not be.
    let dt = period.as_secs_f64();
    let cmd_alpha = params.control.cmd_alpha.clamp(0.0, 1.0);
    let head_alpha = params.control.head_alpha.clamp(0.0, 1.0);
    let mut twist_ema = [0.0f64; 3];
    let mut head_ema = [0.0f64; 4];
    let mut body_ema = [0.0f64; 3];

    // Coasting over a dropped bus read, and where the robot actually is.
    //
    // `known_positions` is updated from every sample that arrives and is what a fallback
    // holds. It used to be `hold`, which is only assigned when driving *stops* — and the
    // assignment needed a sample, which is the one thing a failed read does not have. So a
    // drop mid-stride held whatever `hold` was last set to, which after bring-up is the home
    // pose: one tick of "snap to standing" at full gain, mid-motion.
    let mut coast = Coast::new();
    let mut stopped_driving_at: Option<Instant> = None;

    // Contact odometry, ticked at the loop's own rate on the sample the loop already
    // read — the prototype ran it at 100 Hz on extra bus reads, which is exactly the
    // bus pressure the spasms investigation taught this loop not to add.
    let mut odometry = odometry::Odometry::alpha();

    // The sit-then-power-off sequence.
    let mut shutdown_sit: Option<Instant> = None;
    let mut powered_off = false;
    let mut warned_imu_warming = false;

    // Limp-fall (`[safety] limp_fall`): the predictor that sees a fall start, and where the
    // sequence it drives has got to. Built whether or not the mode is on — it costs a
    // multiply-subtract per tick, and having the numbers computed on every robot is what
    // makes the thresholds tunable against a recording from a robot that was not running
    // the mode.
    let mut falling = FallPredictor::new(FallPredictorConfig {
        tilt_z: params.safety.limp_fall_tilt_z,
        predicted_z: params.safety.limp_fall_predict_z,
        lookahead: Duration::from_millis(params.safety.limp_fall_lookahead_ms),
        debounce: Duration::from_millis(params.safety.limp_fall_debounce_ms),
    });
    let limp_fall_still = Duration::from_millis(params.safety.limp_fall_still_ms);
    let limp_fall_max = Duration::from_millis(params.safety.limp_fall_max_ms);
    let limp_fall_pose = Duration::from_millis(params.safety.limp_fall_pose_ms);
    let mut limp_fall = LimpFall::Idle;

    // The voice, and the ear. Both optional equipment: a robot without a codec or a bank
    // walks identically — the player degrades to a debug line, and the mic worker is only
    // spawned when configured, with its own retry loop when arecord flaps.
    let mut voice = params
        .audio
        .enabled
        .then(|| sound::Sound::new(params.audio.bank.clone(), params.audio.device.clone()));
    let pet: Option<pet_detect::worker::PetHandle> = if params.audio.enabled
        && params.audio.pet_detect_resolved(params.policy.mode)
        && let Some(model) = params.audio.pet_model_resolved()
        && model.exists()
    {
        match pet_detect::worker::PetHandle::spawn(pet_detect::worker::PetConfig {
            alsa_device: params.audio.capture_device(),
            model_path: model.clone(),
            enter_threshold: params.audio.pet_enter_threshold,
            exit_threshold: params.audio.pet_exit_threshold,
        }) {
            Ok(handle) => {
                tracing::warn!(model = %model.display(), "petting detection listening");
                Some(handle)
            }
            Err(e) => {
                // Not unhealthy: the classifier is a feature, not the robot. A missing
                // model on a release that ships one is caught by the packaging tripwires.
                tracing::warn!(error = %e, "petting detection unavailable");
                None
            }
        }
    } else {
        // Configured on but nothing to run: a bench robotd, a board that predates the
        // model, or audio off. Quietly so on purpose — the mic is optional equipment.
        None
    };

    // The theremin. Its depth reader starts now and parks on `tofd`'s socket whether or not
    // anyone ever asks for an instrument: one blocked read costs nothing, and connecting
    // lazily would make the first arming window wait for a connection as well as for
    // frames — a second of silence that reads as a broken feature. Off entirely when the
    // params say so, or when audio is off, since a theremin with no voice is a mouth
    // opening for no reason.
    let mut theremin = (params.theremin.enabled && params.audio.enabled)
        .then(|| theremin::Theremin::spawn(params.theremin.socket.clone(), params.theremin.hand()));
    // How far the beak is open for the chorale, slewed across ticks — see where it is written.
    let mut chorale_mouth = 0.0f64;
    // And how the head sways while singing, applied to the next tick's command.
    let mut chorale_head = [0.0f64; 4];

    // The note the theremin is holding, kept across ticks so a hand leaving the frame fades
    // the note at its own pitch instead of gliding to the bottom of the range on its way out.
    let mut theremin_hz = 0.0f64;

    // The chorale. Off unless the config opted in — see `[chorale] accept`, and note that off
    // means putting nothing on the air rather than declining politely.
    let mut chorale = (params.chorale.accept && params.audio.enabled)
        .then(|| {
            let personality = voice.as_mut().and_then(|v| v.personality())?;
            // `DUCK_CHORALE_PIECE=<id>` pins the conductor's pick — a bench lever for testing
            // one piece, read once like everything else about this process's configuration.
            let forced_piece = std::env::var("DUCK_CHORALE_PIECE")
                .ok()
                .and_then(|v| v.parse::<u8>().ok());
            Some(chorale::Chorale::new(
                personality.pitch_center_hz,
                personality.seed,
                forced_piece,
            ))
        })
        .flatten();
    if chorale.is_some() {
        tracing::warn!("chorale: this robot will sing with others");
    }

    // Say hello in this robot's own voice as the control loop comes up, as the prototype
    // does — the greet is also the audible "robotd is running" on a headless board. Its
    // own switch, because the reason to want it gone (restarting the daemon all day) is
    // not a reason to give up the triggers and the mic that `audio.enabled = false` takes
    // with it.
    if let Some(voice) = voice.as_mut()
        && params.audio.greet
    {
        voice.play("greet", false);
    }

    while !state.shutdown.load(Ordering::Relaxed) {
        ticker.tick().await;
        let tick_start = Instant::now();

        let fresh = match safety.read() {
            Ok(sensors) => {
                state.consecutive_errors.store(0, Ordering::Relaxed);
                Some(sensors)
            }
            Err(e) => {
                let n = state.consecutive_errors.fetch_add(1, Ordering::Relaxed) + 1;
                // One dropped transaction is ordinary on a serial bus; a run of them is not.
                // Log the first and then every tenth, so a persistent fault is visible
                // without a wall of identical lines.
                if n == 1 || n.is_multiple_of(10) {
                    tracing::warn!(error = %e, consecutive = n, "bus read failed");
                }
                None
            }
        };

        // Coast over a dropped read on the last good sample — see [`COAST_TICKS`]. The
        // distinction between "fresh" and "what the policy steps from" matters twice below:
        // safety only observes fresh samples, so a repeat cannot feed the fall debounce, and
        // `known_positions` only advances on fresh ones, so a coasted tick cannot pretend to
        // know where the joints have moved to.
        let sensors = coast.sample(fresh);

        if let Some(fresh) = fresh.as_ref() {
            safety.observe(fresh, period);
            // Only once the orientation filter has converged: seeding the anchor from a
            // quaternion that is still swinging would put the world origin somewhere the
            // robot never was. A coasted tick is skipped too — repeating a stale sample
            // into the estimator would tell it the robot froze, which it did not.
            if safety.imu_ready() {
                odometry.update(&fresh.positions, fresh.imu.quat);
            }
        }
        state.fallen.store(safety.fallen(), Ordering::Relaxed);

        let snapshot = intents.snapshot();
        let (gated, deadman) = safety.gate(snapshot.command, snapshot.twist_age);
        let mut limits: Vec<duck_control::safety::Limit> = deadman.into_iter().collect();

        // An explicit `robot.init` / `robot.relax`, taken once.
        //
        // Before the enable-driven bring-up below, so a `relax` that arrives in the same tick as a
        // still-set `enabled` flag wins — `request_relax` clears that flag, and reading the request
        // first means the order cannot invert.
        match intents.take_power_request() {
            // The power-off has been asked for and torque is off. Standing the robot up now would
            // hand the poweroff a robot mid-ramp, stiff, which is the outcome the sit exists to
            // avoid.
            Some(intents::PowerRequest::Init) if powered_off => {
                tracing::warn!("robot.init ignored: the robot is powering off")
            }
            Some(intents::PowerRequest::Init) => match (bringup, sensors.as_ref()) {
                // Unlike `enable`, this needs no policy: "stand up" is a reasonable thing to ask of
                // a robot with no walking network at all, and it is what a bench robot needs before
                // anything else can be tested.
                (Bringup::Limp, Some(sensors)) => match safety.set_torque(true) {
                    Ok(()) => {
                        if seated_boot && controller.as_ref().is_some_and(|c| c.has_sitstand()) {
                            seated_boot = false;
                            tracing::warn!(
                                "robot.init: seated boot — rising via the sitstand policy"
                            );
                            controller
                                .as_mut()
                                .expect("checked above")
                                .begin_boot_rise();
                            bringup = Bringup::Ready;
                        } else {
                            tracing::warn!(?HOME_RAMP, "robot.init: torque on, ramping to home");
                            bringup = Bringup::Homing {
                                from: sensors.positions,
                                since: tick_start,
                            };
                        }
                    }
                    Err(e) => tracing::warn!(error = %e, "cannot enable torque"),
                },
                // Already up: ramp back to home from wherever the joints are, as the
                // prototype's init_position always does — Start on a robot stopped
                // mid-crouch must not hand the policy that crouch as its starting pose.
                // The policy holds off while Homing runs and resumes at Ready.
                (Bringup::Ready, Some(sensors)) => {
                    tracing::warn!(?HOME_RAMP, "robot.init: re-homing from the current pose");
                    bringup = Bringup::Homing {
                        from: sensors.positions,
                        since: tick_start,
                    };
                }
                // Mid-ramp, or no sample to ramp from: nothing to do, and saying so beats
                // a silent no-op.
                (state, _) => tracing::info!(?state, "robot.init: nothing to bring up"),
            },
            Some(intents::PowerRequest::Relax) => match safety.set_torque(false) {
                Ok(()) => {
                    tracing::warn!("robot.relax: torque off");
                    // Back to the start, so the next `init` or Start ramps from wherever the robot
                    // ends up rather than assuming it is still at the home pose.
                    bringup = Bringup::Limp;
                    was_driving = false;
                }
                Err(e) => {
                    tracing::warn!(error = %e, "cannot cut torque; the robot is still powered")
                }
            },
            None => {}
        }

        // One-shot skill requests, taken once per tick like the power request. They need a
        // driving robot — the prototype's buttons likewise did nothing until the policy ran.
        let requests = intents.take_skills();
        if requests.any() {
            match controller.as_mut() {
                Some(controller)
                    if snapshot.enabled && bringup == Bringup::Ready && shutdown_sit.is_none() =>
                {
                    let outcome = |what: &str, result: Result<(), &'static str>| match result {
                        Ok(()) => tracing::warn!(skill = what, "skill started"),
                        Err(reason) => tracing::warn!(skill = what, reason, "skill refused"),
                    };
                    if requests.ground_pick {
                        outcome("ground_pick", controller.start_ground_pick());
                    }
                    if requests.sit_toggle {
                        match controller.sit_toggle() {
                            Ok(direction) => tracing::warn!(direction, "sit toggle"),
                            Err(reason) => tracing::warn!(reason, "sit toggle refused"),
                        }
                    }
                    // The configurable one-shots, in priority order. A held button lands here
                    // every tick, so only the *start* of one is journal-worthy: `Ok(false)` is a
                    // chain refresh and stays quiet.
                    for index in requests.requested() {
                        let name = controller
                            .skill_names()
                            .get(index)
                            .cloned()
                            .unwrap_or_else(|| index.to_string());
                        match controller.start_skill(index) {
                            Ok(true) => tracing::warn!(skill = %name, "skill started"),
                            Ok(false) => {}
                            Err(reason) => {
                                tracing::debug!(skill = %name, reason, "skill refused");
                            }
                        }
                    }
                }
                _ => tracing::info!("skill request ignored: the policy is not driving"),
            }
        }

        // Sounds: the wheee hold as a level, then the one-shot tags queued by clients. In
        // that order, because the ride owns the PCM while it lasts — the one-shots have to
        // see the ride this tick started (they wait) or the release this tick did (they
        // play). The hold is held only while `padd`'s re-notifications stay fresh; a client
        // that dies mid-ride leaves a ride that lands rather than one that loops forever.
        if let Some(voice) = voice.as_mut() {
            let hold = if powered_off {
                intents::WheeeHold::Released
            } else {
                intents.wheee_hold()
            };
            voice.theremin_settle();
            voice.wheee(hold);
            for tag in intents.take_sounds() {
                voice.play(tag.as_str(), false);
            }

            // Petting: coo, exactly when the prototype coos — not fallen, no scripted move
            // in flight. The verdict is used bare here (not the armed fall gate): this is a
            // sound cue, and cooing while face-down would be worse than staying quiet.
            if let Some(pet) = pet.as_ref() {
                while let Some(ev) = pet.try_recv_event() {
                    match ev {
                        pet_detect::PettingEvent::Start => {
                            let calm =
                                !safety.fallen() && controller.as_ref().is_none_or(|c| !c.busy());
                            if calm {
                                tracing::info!("petting started");
                                voice.play("coo", false);
                            } else {
                                tracing::debug!("petting detected (ignored: busy or down)");
                            }
                        }
                        pet_detect::PettingEvent::End => tracing::debug!("petting ended"),
                    }
                }
                // Ambient sound events have no consumer until the autonomous brain arrives;
                // surfaced at debug so mic tuning on a bench has data to look at.
                while let Some(ev) = pet.try_recv_sound() {
                    tracing::debug!(event = ?ev, "ambient sound");
                }
            }
        }

        // A drive-mode switch: `robot.setMode`, which the pad's held D-pad up sends.
        //
        // The robot goes back to its home pose first and the policies load there, for the reason
        // the prototype relaunched into pose 0: swapping the network under a moving gait means the
        // next tick is a different policy's idea of what the legs were doing. Torque stays on
        // throughout — the robot holds itself up across the swap rather than sitting down.
        if let Some(code) = intents.take_mode_switch() {
            let target = mode_of(code);
            if target == policy_params.mode {
                tracing::info!(
                    mode = target.as_str(),
                    "already in that mode; nothing to switch"
                );
            } else if mode_change.is_some() {
                tracing::warn!(mode = target.as_str(), "a mode switch is already in flight");
            } else {
                tracing::warn!(
                    from = policy_params.mode.as_str(),
                    to = target.as_str(),
                    "mode switch: going home before loading the other policies"
                );
                // The prototype's cue, and worth keeping: one quack for walking, two for roller,
                // so the robot says which mode it is going to without anybody reading a log.
                if let Some(voice) = voice.as_mut() {
                    voice.play("chirp", false);
                    if target == Mode::Roller {
                        voice.play("chirp", false);
                    }
                }
                mode_change = Some(target);
                // Home the robot with the machinery `init` and a fall recovery already use: it
                // ramps per tick, and `driving` is false until it reaches Ready.
                if let Some(sensors) = sensors.as_ref() {
                    bringup = Bringup::Homing {
                        from: sensors.positions,
                        since: tick_start,
                    };
                }
            }
        }

        // A policy change: `robot.loadPolicy`. The networks load on their own thread, and where
        // the swap then happens depends on what is driving — see `change_disturbs`.
        //
        // A change to the network that has the robot takes the mode switch's path and for the
        // same reason: swapping a network under a moving gait means the next tick is a different
        // policy's idea of what the legs were doing. So the robot goes home first and the swap
        // happens there, torque on throughout. A change to any other network is swapped in
        // wherever the robot is, carrying the running state across, so a `walk` reset under a
        // seated robot is a config change and not a stand-up.
        if let Some(change) = intents.take_policy_change() {
            if mode_change.is_some() || pending_swap.is_some() {
                tracing::warn!("a policy change is already in flight; ignoring this one");
            } else if let Some(candidate) =
                candidate_params(&change, &policy_params, &params_path, &mut slot_errors)
            {
                let cfg = candidate.resolved();
                // Only a network that stepped last tick counts as driving: a robot that is
                // disabled, limp or mid-ramp has nothing running that a swap could interrupt.
                let driving = if was_driving {
                    controller.as_ref().and_then(|c| c.driving())
                } else {
                    None
                };
                let disturbs = change_disturbs(driving.as_ref(), &change, &policy_cfg, &cfg);
                let (tx, rx) = std::sync::mpsc::sync_channel(1);
                let load_cfg = cfg.clone();
                let limp_fall = params.safety.limp_fall;
                let spawned = std::thread::Builder::new()
                    .name("policy-load".to_owned())
                    .spawn(move || {
                        // A receiver that has gone away is a loop that has stopped; nothing
                        // to do with the result then.
                        let _ = tx
                            .send(try_controller(&load_cfg, limp_fall).map_err(|e| e.to_string()));
                    });
                match spawned {
                    Err(e) => tracing::error!(
                        change = describe_change(&change),
                        error = %e,
                        "cannot start loading the policy; keeping what is running"
                    ),
                    Ok(_) => {
                        if disturbs {
                            tracing::warn!(
                                change = describe_change(&change),
                                driving = %driving.as_ref().map_or_else(String::new, |d| d.to_string()),
                                "policy change replaces the network driving: going home before swapping"
                            );
                            // Home first only when the robot is actually up. The ramp exists to
                            // stop a network being swapped under a moving gait, and a robot
                            // lying limp on a bench has no gait to protect — while standing one
                            // up because somebody loaded a file would be a surprise of its own,
                            // and on a table a nasty one. So the swap below waits for the ramp
                            // when there is one and happens as soon as the load lands when
                            // there is not.
                            if bringup == Bringup::Ready
                                && let Some(sensors) = sensors.as_ref()
                            {
                                bringup = Bringup::Homing {
                                    from: sensors.positions,
                                    since: tick_start,
                                };
                            }
                        } else {
                            tracing::warn!(
                                change = describe_change(&change),
                                driving = %driving.as_ref().map_or_else(|| "nothing".to_owned(), |d| d.to_string()),
                                "policy change leaves the network driving alone: swapping in place"
                            );
                        }
                        pending_swap = Some(PendingSwap {
                            change,
                            candidate,
                            cfg,
                            disturbs,
                            loading: rx,
                            built: None,
                        });
                    }
                }
            }
        }
        if let Some(pending) = pending_swap.as_mut() {
            pending.poll();
        }

        // The sit-then-power-off sequence: `robot.shutdown`, or a genuinely empty pack.
        // The battery reading is a ~10 s EMA refreshed once a second, so a load sag cannot
        // reach the floor — a pack that gets there is spent.
        let battery_v = f64::from_bits(state.battery_v.load(Ordering::Relaxed));
        let battery_empty = params.safety.battery_empty_shutdown
            && battery_v > 0.0
            && battery_v <= duck_control::model::BATTERY_EMPTY_V;
        if !powered_off && shutdown_sit.is_none() && (intents.take_shutdown() || battery_empty) {
            let can_sit = snapshot.enabled
                && bringup == Bringup::Ready
                && !safety.fallen()
                && controller.as_ref().is_some_and(|c| c.has_sitstand());
            if can_sit {
                tracing::warn!(battery_empty, "shutdown: sitting down before power off");
                // Goodbye peck; non-blocking — it plays out during the sit.
                if let Some(voice) = voice.as_mut() {
                    voice.play("peck", false);
                }
                controller
                    .as_mut()
                    .expect("can_sit checked the controller")
                    .begin_shutdown_sit();
                shutdown_sit = Some(tick_start);
            } else {
                tracing::warn!(battery_empty, "shutdown: cutting torque and powering off");
                cut_torque_before_poweroff(&mut safety);
                // Goodbye peck; blocking, so it is heard before the poweroff kills this
                // process's cgroup. The one deliberate block in the loop, on its last tick.
                if let Some(voice) = voice.as_mut() {
                    voice.play("peck", true);
                }
                intents.set_enabled(false);
                bringup = Bringup::Limp;
                powered_off = true;
                poweroff();
            }
        }
        let shutdown_sit_hold = controller.as_ref().map_or(SHUTDOWN_SIT, |c| {
            Duration::from_secs_f64(c.shutdown_sit_secs())
        });
        if let Some(started) = shutdown_sit
            && !powered_off
            && tick_start.duration_since(started) >= shutdown_sit_hold
        {
            tracing::warn!("sit complete: cutting torque and powering off");
            cut_torque_before_poweroff(&mut safety);
            intents.set_enabled(false);
            bringup = Bringup::Limp;
            powered_off = true;
            poweroff();
        }

        // Limp-fall (`[safety] limp_fall`): catch the fall on the way down.
        //
        // The standing policy is a good stand-up-er and a bad faller. It stands a still
        // robot up cleanly from face-down or face-up; asked to do it out of a dynamic fall
        // it tries, fails, tries again — at walking gain, against the floor — and the
        // motors pay for every attempt. So take the fall away from it: go soft before the
        // landing, let the robot arrive limp, put it back into the standing pose, and only
        // then hand it over. What the policy then sees is the case it is good at.
        //
        // Everything here is off the policy's path by construction: `driving` is false for
        // the whole sequence, so the controller is not stepped and the targets below come
        // from this block. Nothing in `safety` needs telling: the fall verdict gates
        // nothing, so the pose ramp moves a robot lying on the floor like any other tick.
        if params.safety.limp_fall {
            // Abandoned mid-sequence: someone cut the torque, disabled the policy, or the
            // shutdown sit started. Whatever took over owns the robot now — drop out rather
            // than finishing a pose ramp nobody asked for, and hold where the robot is
            // rather than snapping back to a pose it collapsed out of a second ago.
            if limp_fall != LimpFall::Idle
                && !(snapshot.enabled
                    && bringup == Bringup::Ready
                    && shutdown_sit.is_none()
                    && !powered_off)
            {
                tracing::warn!("limp-fall abandoned — something else took the robot");
                limp_fall = LimpFall::Idle;
                falling.reset();
                hold = coast.known_positions(hold);
            }
            match limp_fall {
                LimpFall::Idle => {
                    // Only on a fresh sample: a coasted one is the same reading twice, and
                    // feeding it to a debounce would let one bad tick count three times.
                    let eligible = was_driving
                        // Already down. There is no fall left to catch, and this is what
                        // stops the sequence firing at a robot on the floor working its way
                        // upright: a stand-up rocks, and a rock is a tilt with a rate on it.
                        // Limping through that would be an endless limp-pose-retry loop.
                        && !safety.fallen()
                        && shutdown_sit.is_none()
                        && !powered_off
                        // A roulade tips the robot over on purpose, a ground pick pitches it
                        // forward, and a sit is not a fall. Limping through any of them would
                        // break a move that was working.
                        && controller
                            .as_ref()
                            .is_some_and(|c| !c.busy() && !c.is_sitting());
                    match fresh.as_ref() {
                        Some(fresh) if eligible && safety.imu_ready() => {
                            if falling.observe(&fresh.imu, period) {
                                tracing::warn!(
                                    gravity_z = format!("{:.2}", fresh.imu.gravity[2]),
                                    rate =
                                        format!("{:.2}", FallPredictor::gravity_z_rate(&fresh.imu)),
                                    gain = params.safety.gain_limp,
                                    "falling — going limp to land soft"
                                );
                                limp_fall = LimpFall::Limp {
                                    since: tick_start,
                                    landing: Landing::default(),
                                };
                            }
                        }
                        // Not eligible, or blind for this tick. Drop any debounce in
                        // progress rather than resuming it later against a robot that has
                        // moved on.
                        _ => falling.reset(),
                    }
                }
                LimpFall::Limp { since, mut landing } => {
                    let rate = fresh
                        .as_ref()
                        .map(|s| s.imu.gyro.iter().map(|w| w * w).sum::<f64>().sqrt());
                    let landed = landing.observe(
                        rate,
                        period,
                        params.safety.limp_fall_still_rate,
                        limp_fall_still,
                    );
                    // Whatever the gyro says: a robot held in someone's hands, or resting
                    // against something that keeps nudging it, must not stay limp forever.
                    let timed_out = tick_start.duration_since(since) >= limp_fall_max;
                    if landed || timed_out {
                        // From where the robot actually is. `hold` is where it was when
                        // driving stopped, which is a pose it has since collapsed out of —
                        // ramping from that would start with a jump.
                        let from = coast.known_positions(hold);
                        tracing::warn!(
                            limp_ms = tick_start.duration_since(since).as_millis(),
                            timed_out,
                            pose_ms = limp_fall_pose.as_millis(),
                            "landed — posing back to standing"
                        );
                        limp_fall = LimpFall::Posing {
                            from,
                            since: tick_start,
                        };
                    } else {
                        limp_fall = LimpFall::Limp { since, landing };
                    }
                }
                LimpFall::Posing { since, .. } => {
                    if tick_start.duration_since(since) >= limp_fall_pose {
                        tracing::warn!("posed — handing back to the standing policy");
                        limp_fall = LimpFall::Idle;
                        falling.reset();
                        hold = DEFAULT_POSITION;
                        // Hand back to the policy, and let it choose. The twist has been
                        // held at zero through the whole sequence, so with nobody driving
                        // the standing network is what command magnitude selects — which
                        // is the stand-up. A client that *is* driving gets its walk back;
                        // the humans stay in charge, here as everywhere else.
                        if let Some(controller) = controller.as_mut() {
                            controller.reset();
                        }
                    }
                }
            }
        }
        let in_limp_fall = limp_fall != LimpFall::Idle;

        // Smooth the command. The limp-fall sequence holds the twist at zero outright, so
        // the robot is not handed back mid-command; and leaving body-pose mode snaps the
        // body back to nominal rather than gliding, which is its B-button exit.
        let twist_target = if in_limp_fall { [0.0; 3] } else { gated.twist };
        if in_limp_fall {
            twist_ema = [0.0; 3];
        }
        for (ema, target) in twist_ema.iter_mut().zip(twist_target) {
            *ema += cmd_alpha * (target - *ema);
        }
        for (ema, target) in head_ema.iter_mut().zip(gated.head) {
            *ema += head_alpha * (target - *ema);
        }
        if snapshot.pose.active {
            for (ema, target) in body_ema.iter_mut().zip(snapshot.pose.body) {
                *ema += cmd_alpha * (target - *ema);
            }
        } else {
            body_ema = [0.0; 3];
        }
        let command = PolicyCommand {
            twist: twist_ema,
            // The chorale's sway rides on top of whatever the head was asked to do, computed
            // last tick (20 ms stale, invisible at sway speed) and slewed to zero when the
            // singing stops so the head settles rather than snaps.
            head: [
                head_ema[0] + chorale_head[0],
                head_ema[1] + chorale_head[1],
                head_ema[2] + chorale_head[2],
                head_ema[3] + chorale_head[3],
            ],
            body: BodyPose {
                z: body_ema[0],
                roll: body_ema[1],
                pitch: body_ema[2],
            },
        };

        // Bring the robot up when someone asks it to drive and it has no torque yet.
        //
        // Not gated on the fall: a fallen robot ramps like any other, as the prototype
        // does. Being down is a report, and the humans stay in charge.
        //
        // Needs a sample: `from` is where the joints actually are, and starting a ramp from a
        // position nobody read would be the lurch this exists to avoid.
        // `controller.is_some()` as well, because this call means "enable the policy": powering the
        // joints to run a policy that is disabled or would not load is work towards nothing, and it
        // would make a release whose bundle is broken stand the robot up and then hold. A robot that
        // should stand without a policy is what `robotd init` is for.
        //
        // And never once the power-off has begun. `snapshot.enabled` was read at the top of this
        // tick, and the sit-complete path above clears the flag *and* sets `Limp` in the middle
        // of it — so without the guard, the very tick that cut torque for the poweroff turned it
        // back on and started ramping the robot to home. Seen on the robot as "sits, stands back
        // up, switches off", or when the poweroff was quicker, "sits, switches off, stiff".
        if !powered_off
            && let (Bringup::Limp, true, true, Some(sensors)) = (
                bringup,
                snapshot.enabled,
                controller.is_some(),
                sensors.as_ref(),
            )
        {
            match safety.set_torque(true) {
                Ok(()) => {
                    if seated_boot && controller.as_ref().is_some_and(|c| c.has_sitstand()) {
                        // Seated boot: hold the seat and rise via the sitstand network —
                        // the linear ramp would drag folded legs sideways through the floor.
                        seated_boot = false;
                        tracing::warn!("seated boot — rising via the sitstand policy");
                        controller
                            .as_mut()
                            .expect("checked above")
                            .begin_boot_rise();
                        bringup = Bringup::Ready;
                    } else {
                        tracing::warn!(
                            ?HOME_RAMP,
                            "enabling the policy: torque on, ramping to home"
                        );
                        bringup = Bringup::Homing {
                            from: sensors.positions,
                            since: tick_start,
                        };
                    }
                }
                // Reported, not fatal, and it stays `Limp` so the next tick tries again: a bus that
                // dropped one transaction is ordinary, and a robot that refused to ever come up
                // because of it would be worse than one that keeps asking.
                Err(e) => tracing::warn!(error = %e, "cannot enable torque; the robot stays limp"),
            }
        }

        // The ramp finishing is what makes the policy eligible to drive.
        //
        // Unless the robot went home for a swap whose networks are still loading. Then it holds
        // here, at the pose the ramp reached, until they land: the ramp exists so the swap happens
        // at rest, and going `Ready` with the old controller for the second the load still needs
        // would hand it the robot for exactly that second.
        if let Bringup::Homing { .. } = bringup
            && bringup.homing_target(tick_start).is_none()
            && pending_swap
                .as_ref()
                .is_some_and(|p| p.disturbs && !p.ready())
        {
            hold = DEFAULT_POSITION;
        } else if let Bringup::Homing { .. } = bringup
            && bringup.homing_target(tick_start).is_none()
        {
            // Home, and a switch waiting: load the other mode's bundle here, where the robot is
            // standing still at a known pose with torque on. `Policy::load` validates and warms
            // up each network, so this blocks the loop for a moment — deliberately, and in the one
            // place where a stalled command stream costs nothing, because the robot is holding a
            // pose rather than mid-stride. Missed ticks in that window are expected.
            if let Some(target) = mode_change.take() {
                policy_params.mode = target;
                let cfg = policy_params.resolved();
                state.policy_error.store(None);
                controller = build_controller(&cfg, params.safety.limp_fall, &state);
                // Published together with the mode, and only after the load: a client that reads
                // `robot.mode` and gets the new one must not then be told the old mode's networks.
                state.policies.store(Arc::new(PolicyNames::of(&cfg)));
                state.mode.store(mode_code(target), Ordering::Relaxed);
                state
                    .policy_slots
                    .store(Arc::new(slot_report(&policy_params, &cfg, &slot_errors)));
                policy_cfg = cfg;
                tracing::warn!(
                    mode = target.as_str(),
                    loaded = controller.is_some(),
                    "mode switch complete"
                );
            }
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
