mengwei666/my_microduck/(commit log)

2026-09-17 Add microduck and microduck_rl projects
    [ankle_l_v1.stl, ankle_left.stl, ankle_r_v1.stl, ankle_right.stl, arm.stl, axis.stl, banana_pcb_locker.stl, bearing_roll.stl]
2026-10-20 第一次上传
    [01-upper_leg_rigidity_plate_上腿加固板-FT.STEP, 02_左髋yaw-roll-FT.STEP, 03_左髋roll-FT.STEP, 04_左大腿-FT.SLDASM, 04_左大腿-FT.STEP, 05_左小腿-FT.STEP, 06_左踝脚-FT.STEP, 99-yaw_roll_motion_偏航横滚运动-F.STEP]
2026-10-21 20261021 上传文件测试
2026-10-21 20261021 添加其他项目文件
    [00-microduck装配体 XL330-288舵机版本.SLDASM, 00-microduck装配体-FT2026.9.23.SLDASM, 01-upper_leg_rigidity_plate_上腿加固板-FT.SLDPRT, 01-upper_leg_rigidity_plate_上腿加固板.SLDPRT, 01_躯干主体-FT.SLDASM, 01_躯干主体.SLDASM, 02_左髋yaw-roll-FT.SLDASM, 02_左髋yaw-roll.SLDASM]
2026-10-21 20261021 添加其他项目文件2
2026-10-21 20261021 添加工控机模型
    [3D_PCB_2026-10-21 (1).step, Bus Servo Adapter (A).step, SCS225_ankle_housing.step, SCS225_ankle_link.step, SCS225_fit_reference.step, ankle_left_SCS225.step, foot_left_SCS225.step, left_ankle_SCS225_check.FCStd]
